davecutting/Ward-Melville-2018-Mission-Possible/Circuit Board/MIT Invitational Circuit Board/Board Bottom MIT.JPG

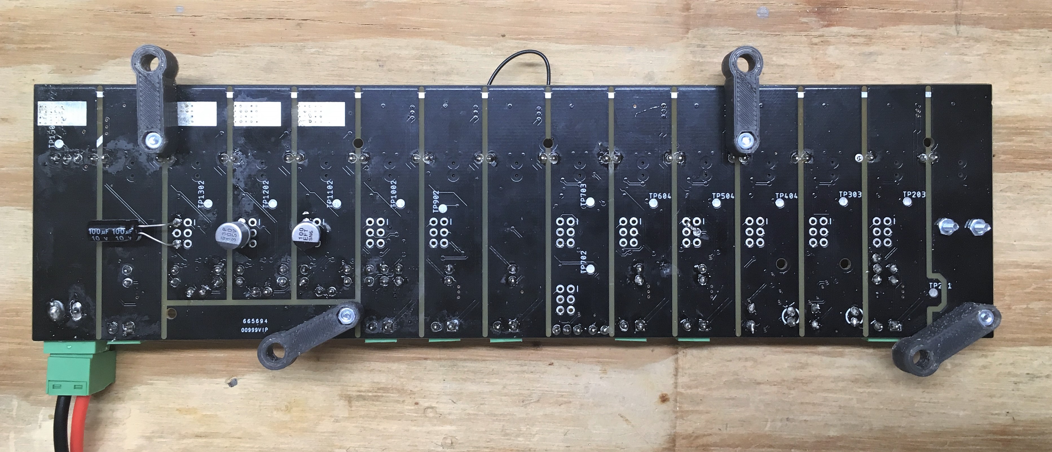
Circuit Board/MIT Invitational Circuit Board/Board Bottom MIT.JPG
