davecutting/Ward-Melville-2018-Mission-Possible/README.md

# WMHS Mission Possible 2018 # 

This repository contains code and circuit board design files for Ward Melville High School's A team Mission Prossible device in the 2017-2018 season. All work represented here is the original work of David Cutting.
