davecutting/Ward-Melville-2018-Mission-Possible/Code/Eastern LI Regionals Code/coinTiny/coinTiny-v1.1.pdf

coinTiny.ino -- Printed on 1/26/2018, 10:43:47 PM -- Page 1 1 /**
2 Coin Action - Mission Possible MK2
3 Ward Melville HS Science Olympiad - Team A - 2017-2018
4 coinTiny.ino
5 Purpose: Triggers the next action based on the input from an NPN inductive probe. 6
7 @author David Cutting
8 @version 1.1 1/23/2018
9 */
10
11 // Definitions for microcontroller pin numbers 12 const int PROBE_PIN = 2;
13 const int OUT_PIN = 4;
14
15 // Variables for states of the pins 16 bool probeState = HIGH;
17 bool outState = LOW;
18
19 // Variables and constants for the debounce code 20 unsigned int counter = 0;
21 const int DEBOUNCE_COUNT = 50;
22 long time = 0;
23
24 void setup() {
25 // Set the microcontroller pins as either inputs or outputs 26 pinMode(PROBE_PIN, INPUT);
27 pinMode(OUT_PIN, OUTPUT);
28
29 // Set the output pin to low
30 digitalWrite(OUT_PIN, LOW); // Write the output pin to LOW 31 }
32
33 void loop() {
34 if(millis() != time && outState == LOW) { // If more than one millisecond has elapsed since the last loop...
35 probeState = digitalRead(PROBE_PIN); // Read the current state of the probe and store it 36
37 if(probeState == LOW) { // If the state of the probe is low (quarter is present)...
38 counter++; // Increment the counter
39 }
40 else { // Otherwise...
41 counter = 0; // Reset the counter
42 }
43 if(counter >= DEBOUNCE_COUNT) { // If the counter is greater than the debounce threshold...
44 counter = 0; // Reset the counter
45 outState = HIGH; // Set the trigger state to high
46 digitalWrite(OUT_PIN, outState); // Set the output pin to the trigger state 47 }
48 time = millis(); // Record the current time in milliseconds
49 }
50 }
51

C:\Users\davec\Documents\GitHub\Ward-Melville-2018-Mission-Possible\Code\Eastern LI Regionals Code\coinTiny\coinTiny.ino -- File date: 1/23/2018 -- File time: 1:49:51 AM
