davecutting/Ward-Melville-2018-Mission-Possible/Code/Eastern LI Regionals Code/exoTiny/exoTiny-v1_1.pdf

exoTiny.ino -- Printed on 1/26/2018, 11:27:37 PM -- Page 1 1 /**
2 Exothermic Action - Mission Possible MK2
3 Ward Melville HS Science Olympiad - Team A - 2017-2018
4 exoTiny.ino
5 Purpose: Triggers the next action when the resistance of a photocell changes more than a threshold value.
6
7 @author David Cutting
8 @version 1.1 1/26/2018
9 */
10
11 // Definitions for microcontroller pin numbers 12 const int photocellPin = 1;
13 const int outPin = 4;
14
15 // Variables for states of the pins 16 int photocellValue;
17 int photocellBase;
18 bool statusOut = LOW;
19
20 void setup() {
21 // Set the microcontroller pins as either inputs or outputs 22 pinMode(photocellPin, INPUT);
23 pinMode(outPin, OUTPUT);
24
25 // Set the output pin to low
26 digitalWrite(outPin, LOW); // Write the output pin to LOW 27
28 // Read the initial value of the photocell (ambient light)
29 photocellBase = analogRead(photocellPin);
30 }
31
32 void loop() {
33 photocellValue = analogRead(photocellPin);
34
35 if(photocellValue - photocellBase >= 200 && statusOut == LOW) {
36 // If the difference (NOT ABSOLUTE VALUE) between the current reading and the ambient reading is greater than the threshold...
37 delay(500); // Delay 500 milliseconds (0.5 s) to allow observation
38 statusOut = HIGH;
39 digitalWrite(outPin, HIGH); // Trigger the next action
40 }
41 }
42

C:\Users\davec\Documents\GitHub\Ward-Melville-2018-Mission-Possible\Code\Eastern LI Regionals Code\exoTiny\exoTiny.ino -- File date: 1/26/2018 -- File time: 11:24:33 PM
