davecutting/Ward-Melville-2018-Mission-Possible/Circuit Board/Eastern LI Regionals Circuit Board/Schematic Top.pdf

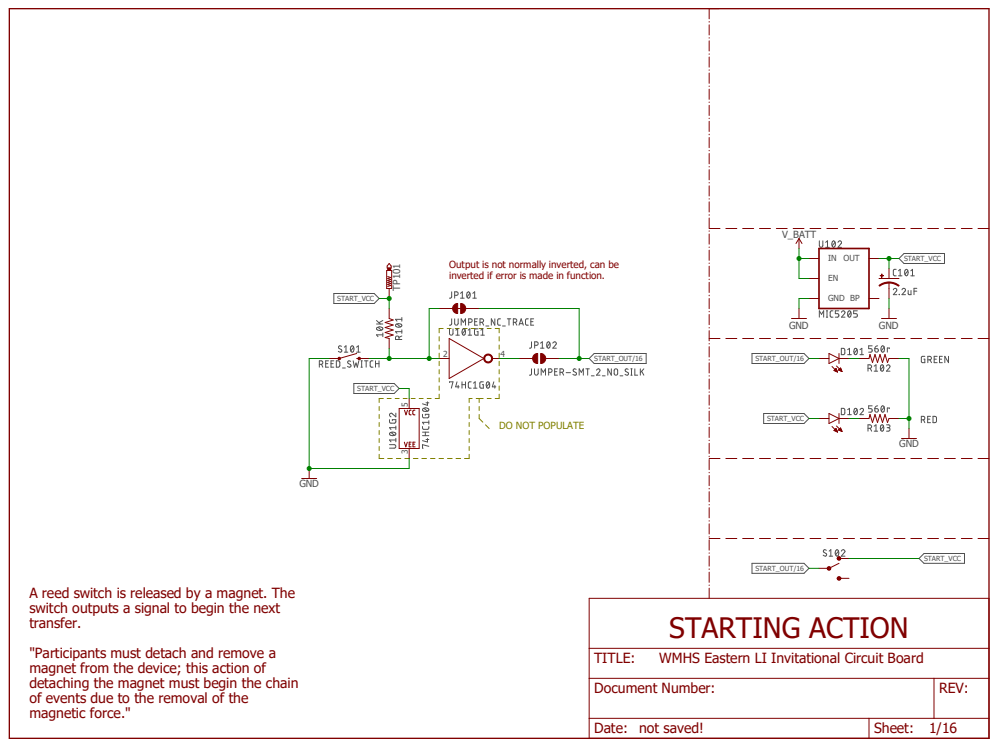
[picture p19: page 1]
GND; V_BATT; OUT; START_VCC; START_OUT/16; STARTING ACTION; TITLE:

Output is not normally inverted, can be
inverted if error is made in function.

DO NOT POPULATE

A reed switch is released by a magnet. The
switch outputs a signal to begin the next
transfer.
"Participants must detach and remove a
magnet from the device; this action of
detaching the magnet must begin the chain
of events due to the removal of the
magnetic force."

WMHS Eastern LI Invitational Circuit Board

Document Number: | REV:

Date: not saved! | Sheet: 1/16

# GND SK310A⁻TP

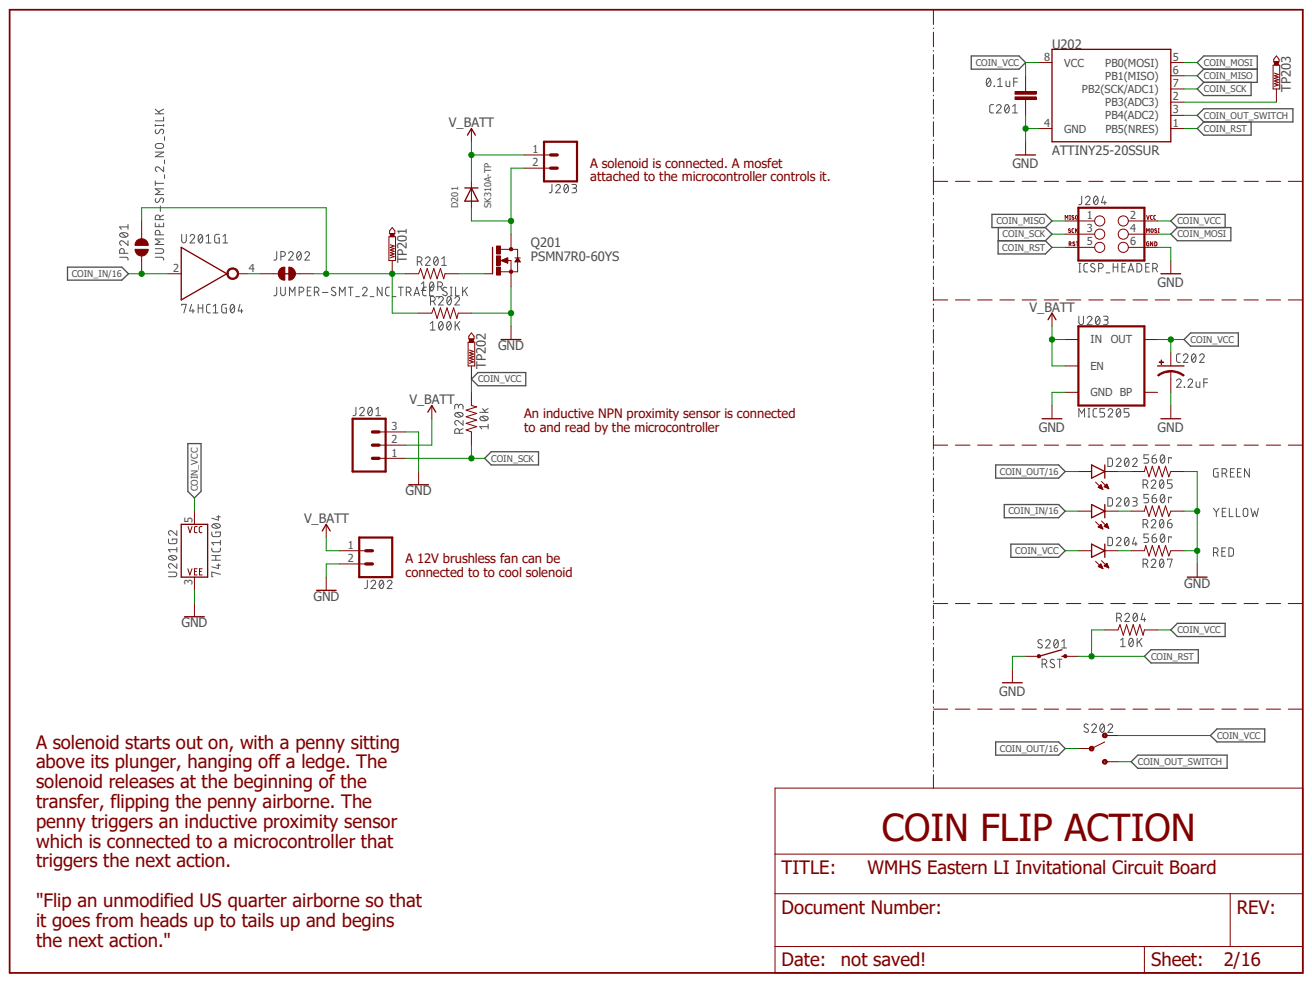
[picture p20: page 2]
V_BATT; GND; ATTINY25-20SSUR; PSMN7R0-60YS D²⁰¹; U202 VCC 8; PB1(MISO); PB5(NRES); 1 GND 4; PB0(MOSI); PB2(SCK/ADC1); 7 PB3(ADC3); PB4(ADC2); OUT; TP203 COIN_VCC; COIN_VCC; COIN_IN/16; COIN_SCK; COIN_MISO; COIN_RST; COIN_MOSI; COIN_OUT/16; COIN_OUT_SWITCH; TITLE:

A solenoid is connected. A mosfet
attached to the microcontroller controls it.

An inductive NPN proximity sensor is connected
to and read by the microcontroller

A 12V brushless fan can be
connected to to cool solenoid

A solenoid starts out on, with a penny sitting
above its plunger, hanging off a ledge. The
solenoid releases at the beginning of the
transfer, flipping the penny airborne. The
penny triggers an inductive proximity sensor
which is connected to a microcontroller that
triggers the next action.
"Flip an unmodified US quarter airborne so that
it goes from heads up to tails up and begins
the next action."

COIN_OUT/16
COIN FLIP ACTION

WMHS Eastern LI Invitational Circuit Board

Document Number: | REV:

Date: not saved! | Sheet: 2/16

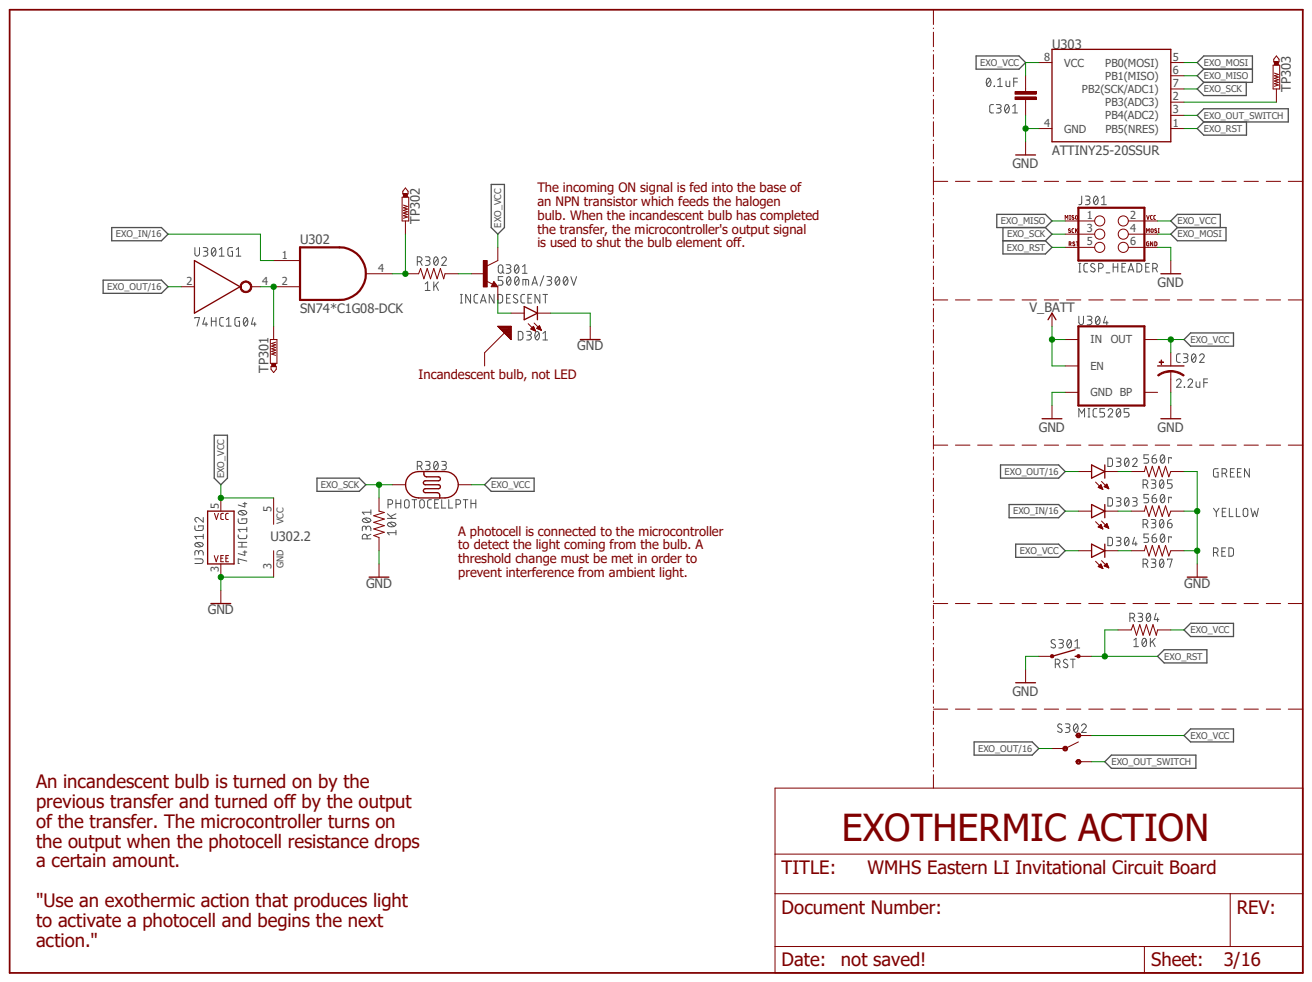
[picture p21: page 3]
GND; ATTINY25-20SSUR; V_BATT; SN74*C1G08-DCK; U303 VCC 8; PB1(MISO); PB5(NRES); 1 GND 4; PB0(MOSI); PB2(SCK/ADC1); 7 PB3(ADC3); PB4(ADC2); OUT; 5 3 U302.2 3 5 GND VCC TP303 TP301 TP302 EXO_VCC; EXO_VCC EXO_VCC; EXO_VCC; EXO_SCK; EXO_IN/16; EXO_OUT/16; EXO_MISO; EXO_RST; EXO_MOSI; EXO_OUT_SWITCH; EXOTHERMIC ACTION; TITLE:

The incoming ON signal is fed into the base of
an NPN transistor which feeds the halogen
bulb. When the incandescent bulb has completed
the transfer, the microcontroller's output signal
is used to shut the bulb element off.

Incandescent bulb, not LED

A photocell is connected to the microcontroller
to detect the light coming from the bulb. A
threshold change must be met in order to
prevent interference from ambient light.

An incandescent bulb is turned on by the
previous transfer and turned off by the output
of the transfer. The microcontroller turns on
the output when the photocell resistance drops
a certain amount.
"Use an exothermic action that produces light
to activate a photocell and begins the next
action."

WMHS Eastern LI Invitational Circuit Board

Document Number: | REV:

Date: not saved! | Sheet: 3/16

# LIGHT_VCC LIGHT_VCC

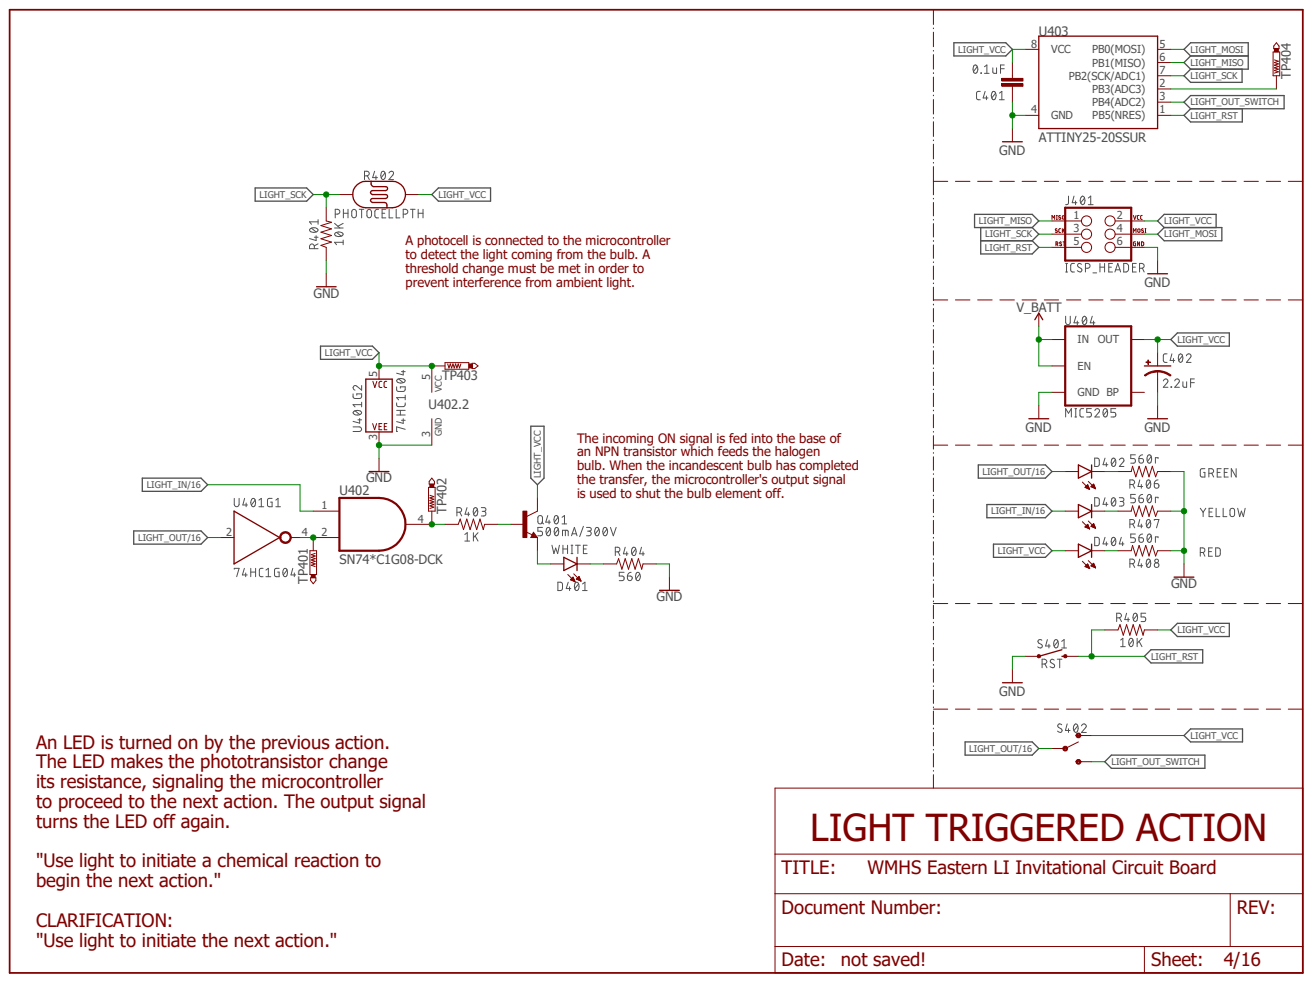
[picture p22: page 4]
GND; ATTINY25-20SSUR; V_BATT; SN74*C1G08-DCK; U403 VCC 8; PB1(MISO); PB5(NRES); 1 GND 4; PB0(MOSI); PB2(SCK/ADC1); 7 PB3(ADC3); PB4(ADC2); OUT; U402.2 3 5 GND VCC5 3; LIGHT_SCK; LIGHT_VCC; LIGHT_IN/16; LIGHT_OUT/16; LIGHT_MISO; LIGHT_RST; LIGHT_MOSI; LIGHT_OUT_SWITCH; TITLE:

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

An LED is turned on by the previous action.
The LED makes the phototransistor change
its resistance, signaling the microcontroller
to proceed to the next action. The output signal
turns the LED off again.
"Use light to initiate a chemical reaction to
begin the next action."
CLARIFICATION:
"Use light to initiate the next action."

LIGHT TRIGGERED ACTION

WMHS Eastern LI Invitational Circuit Board

Document Number: | REV:

Date: not saved! | Sheet: 4/16

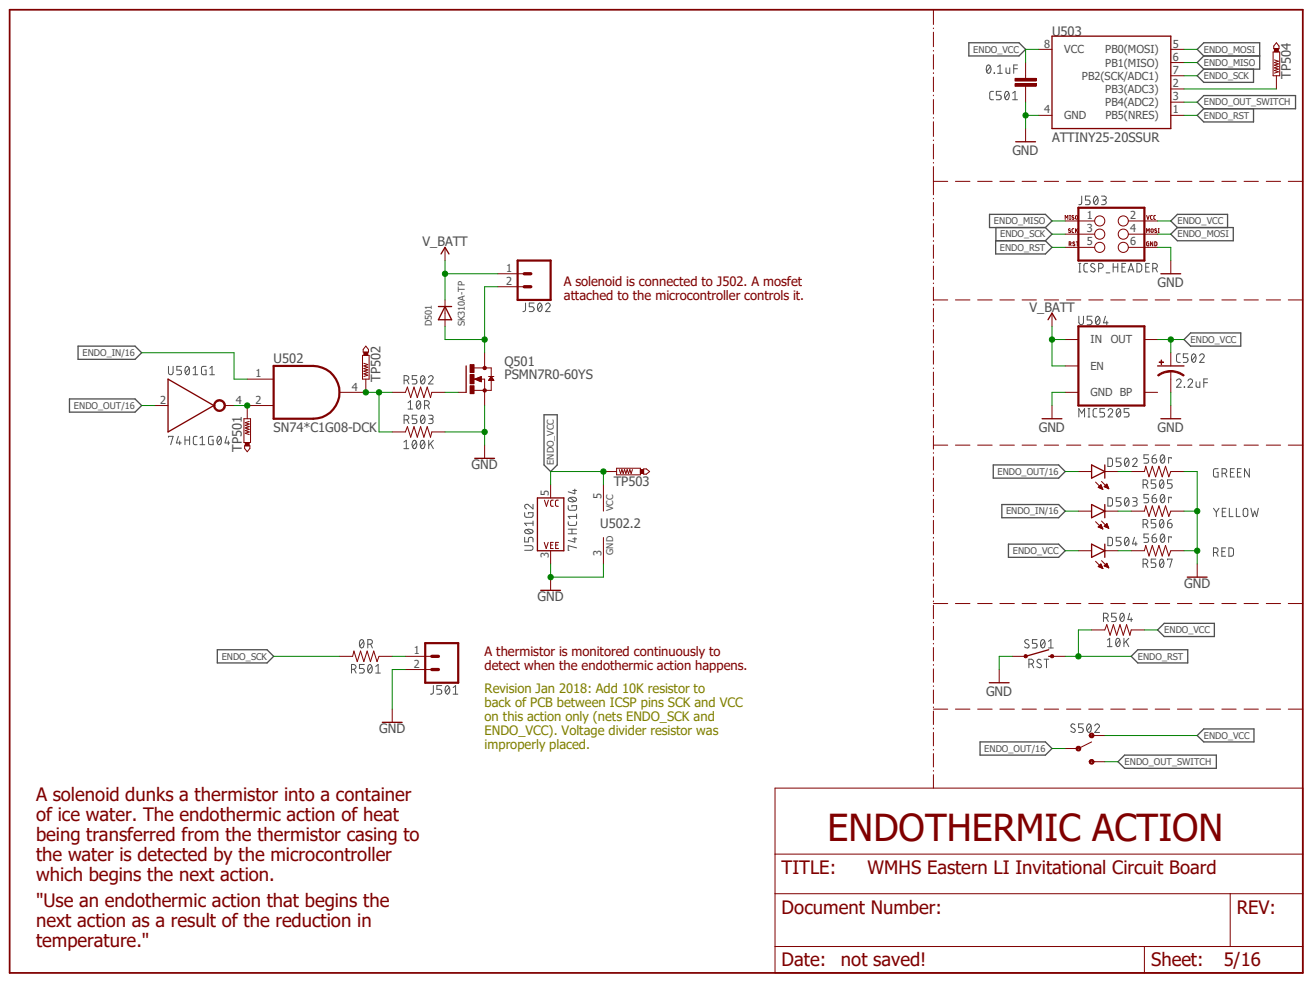
[picture p23: page 5]
GND; PSMN7R0-60YS; GND SK310A⁻TP; V_BATT; ATTINY25-20SSUR; SN74*C1G08-DCK; Q501 D⁵⁰¹; U503 VCC 8; PB1(MISO); PB5(NRES); 1 GND 4; PB0(MOSI); PB2(SCK/ADC1); 7 PB3(ADC3); PB4(ADC2); OUT; 4 U502.2 3 5 GND VCC; ENDO_SCK; ENDO_IN/16; ENDO_OUT/16; ENDO_VCC; ENDO_MISO; ENDO_RST; ENDO_MOSI; ENDO_OUT_SWITCH; ENDOTHERMIC ACTION; TITLE:

A solenoid is connected to J502. A mosfet
attached to the microcontroller controls it.

A thermistor is monitored continuously to
detect when the endothermic action happens.
Revision Jan 2018: Add 10K resistor to
back of PCB between ICSP pins SCK and VCC
on this action only (nets ENDO_SCK and
ENDO_VCC). Voltage divider resistor was
improperly placed.

A solenoid dunks a thermistor into a container
of ice water. The endothermic action of heat
being transferred from the thermistor casing to
the water is detected by the microcontroller
which begins the next action.
"Use an endothermic action that begins the
next action as a result of the reduction in
temperature."

WMHS Eastern LI Invitational Circuit Board

Document Number: | REV:

Date: not saved! | Sheet: 5/16

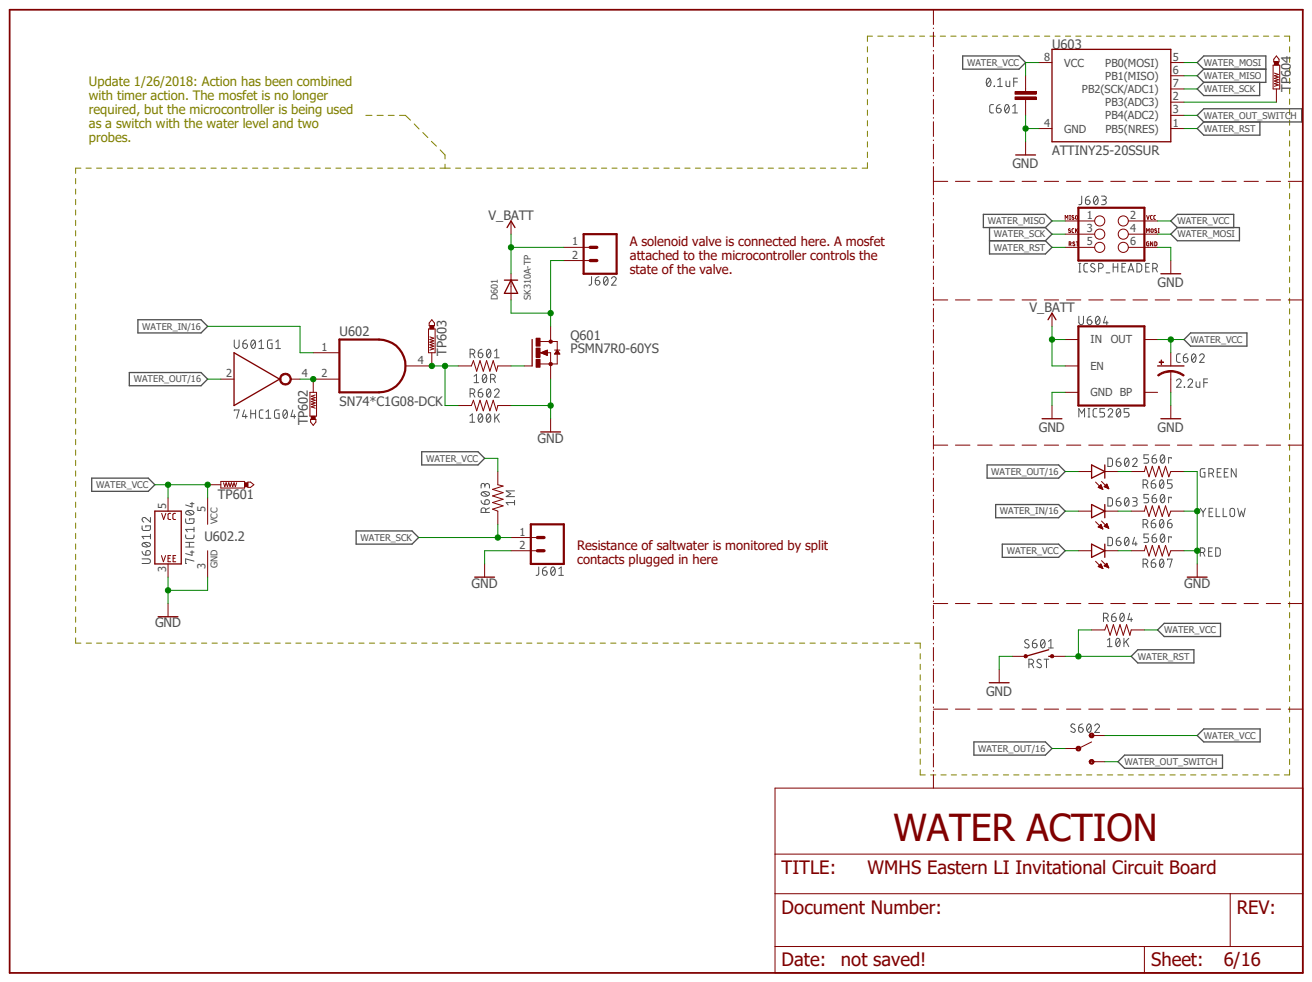
[picture p24: page 6]
PSMN7R0-60YS; GND SK310A⁻TP; V_BATT; GND; ATTINY25-20SSUR; SN74*C1G08-DCK; Q601 D⁶⁰¹; U603 VCC 8; PB1(MISO); PB5(NRES); 1 GND 4; PB0(MOSI); PB2(SCK/ADC1); 7 PB3(ADC3); PB4(ADC2); OUT; 5 3 U602.2 3 5 GND VCC TP604; WATER_VCC; WATER_SCK; WATER_IN/16; WATER_OUT/16; WATER_MISO; WATER_RST; WATER_MOSI; WATER_OUT_SWITCH; WATER ACTION; TITLE:

Update 1/26/2018: Action has been combined
with timer action. The mosfet is no longer
required, but the microcontroller is being used
as a switch with the water level and two
probes.

A solenoid valve is connected here. A mosfet
attached to the microcontroller controls the
state of the valve.

Resistance of saltwater is monitored by split
contacts plugged in here

WMHS Eastern LI Invitational Circuit Board

Document Number: | REV:

Date: not saved! | Sheet: 6/16

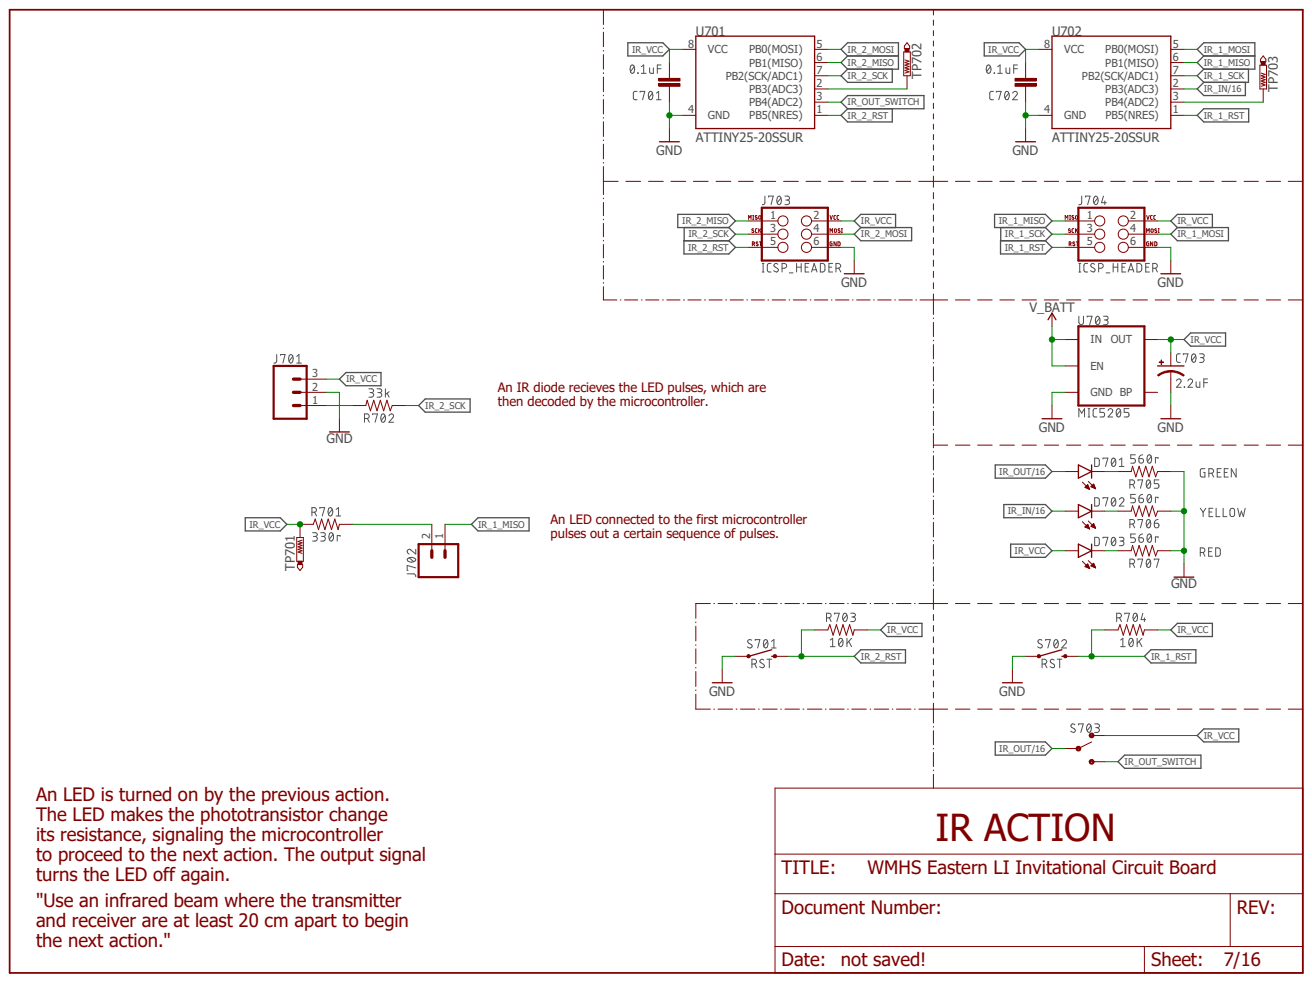
[picture p25: page 7]
GND; ATTINY25-20SSUR; V_BATT; U702 VCC 8; PB1(MISO); PB5(NRES); 1 GND 4; PB0(MOSI); PB2(SCK/ADC1); 7 PB3(ADC3); PB4(ADC2); U701 VCC 8; OUT; IR_1_MISO; IR_2_SCK; IR_VCC; IR_1_SCK; IR_1_RST; IR_1_MOSI; IR_2_MISO; IR_2_RST; IR_2_MOSI; IR_OUT/16; IR_OUT_SWITCH; IR ACTION; TITLE:

An IR diode recieves the LED pulses, which are
then decoded by the microcontroller.

An LED connected to the first microcontroller
pulses out a certain sequence of pulses.

An LED is turned on by the previous action.
The LED makes the phototransistor change
its resistance, signaling the microcontroller
to proceed to the next action. The output signal
turns the LED off again.
"Use an infrared beam where the transmitter
and receiver are at least 20 cm apart to begin
the next action."

WMHS Eastern LI Invitational Circuit Board

Document Number: | REV:

Date: not saved! | Sheet: 7/16

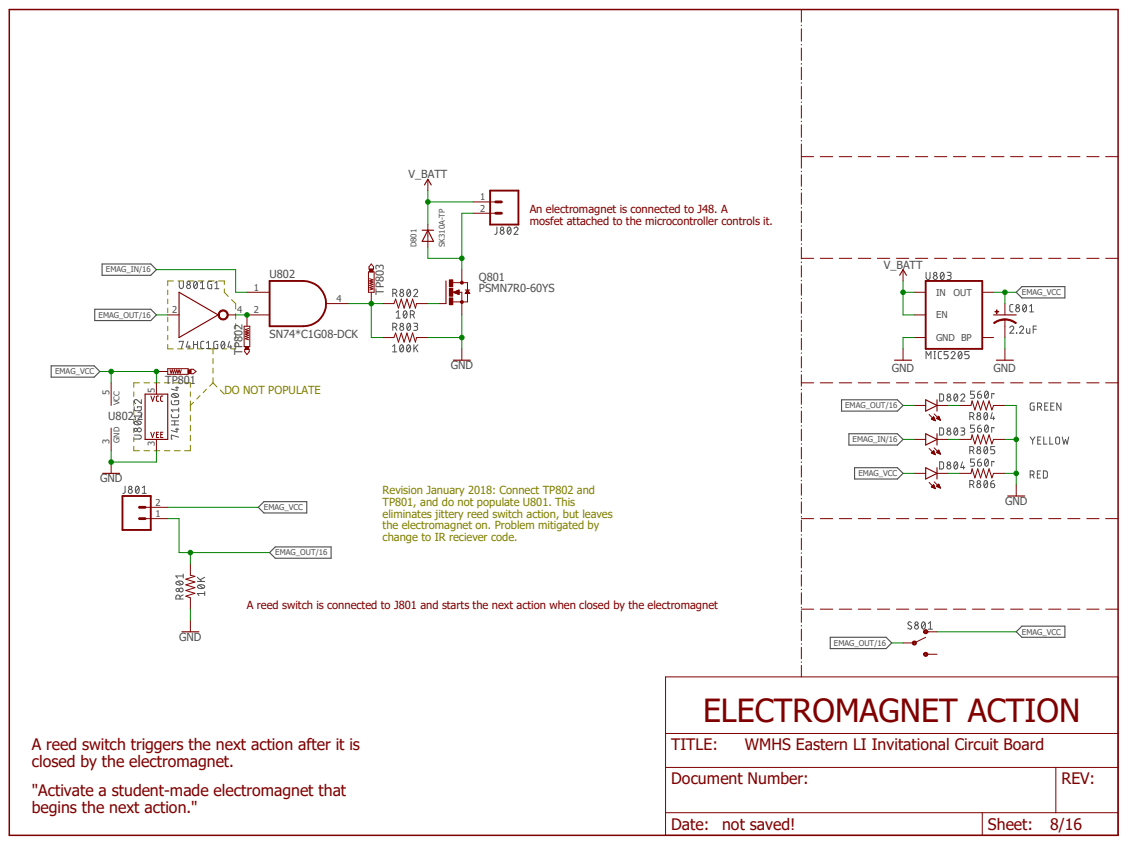
[picture p26: page 8]
GND; PSMN7R0-60YS; GND SK310A⁻TP; V_BATT; SN74*C1G08-DCK; Q801 D⁸⁰¹; OUT; 5 3 U802.2 3 5 GND VCC TP802 TP803; EMAG_VCC; EMAG_OUT/16; EMAG_IN/16; ELECTROMAGNET ACTION; TITLE:

An electromagnet is connected to J48. A
mosfet attached to the microcontroller controls it.

DO NOT POPULATE

Revision January 2018: Connect TP802 and
TP801, and do not populate U801. This
eliminates jittery reed switch action, but leaves
the electromagnet on. Problem mitigated by
change to IR reciever code.

A reed switch is connected to J801 and starts the next action when closed by the electromagnet

A reed switch triggers the next action after it is
closed by the electromagnet.
"Activate a student-made electromagnet that
begins the next action."

WMHS Eastern LI Invitational Circuit Board

Document Number: | REV:

Date: not saved! | Sheet: 8/16

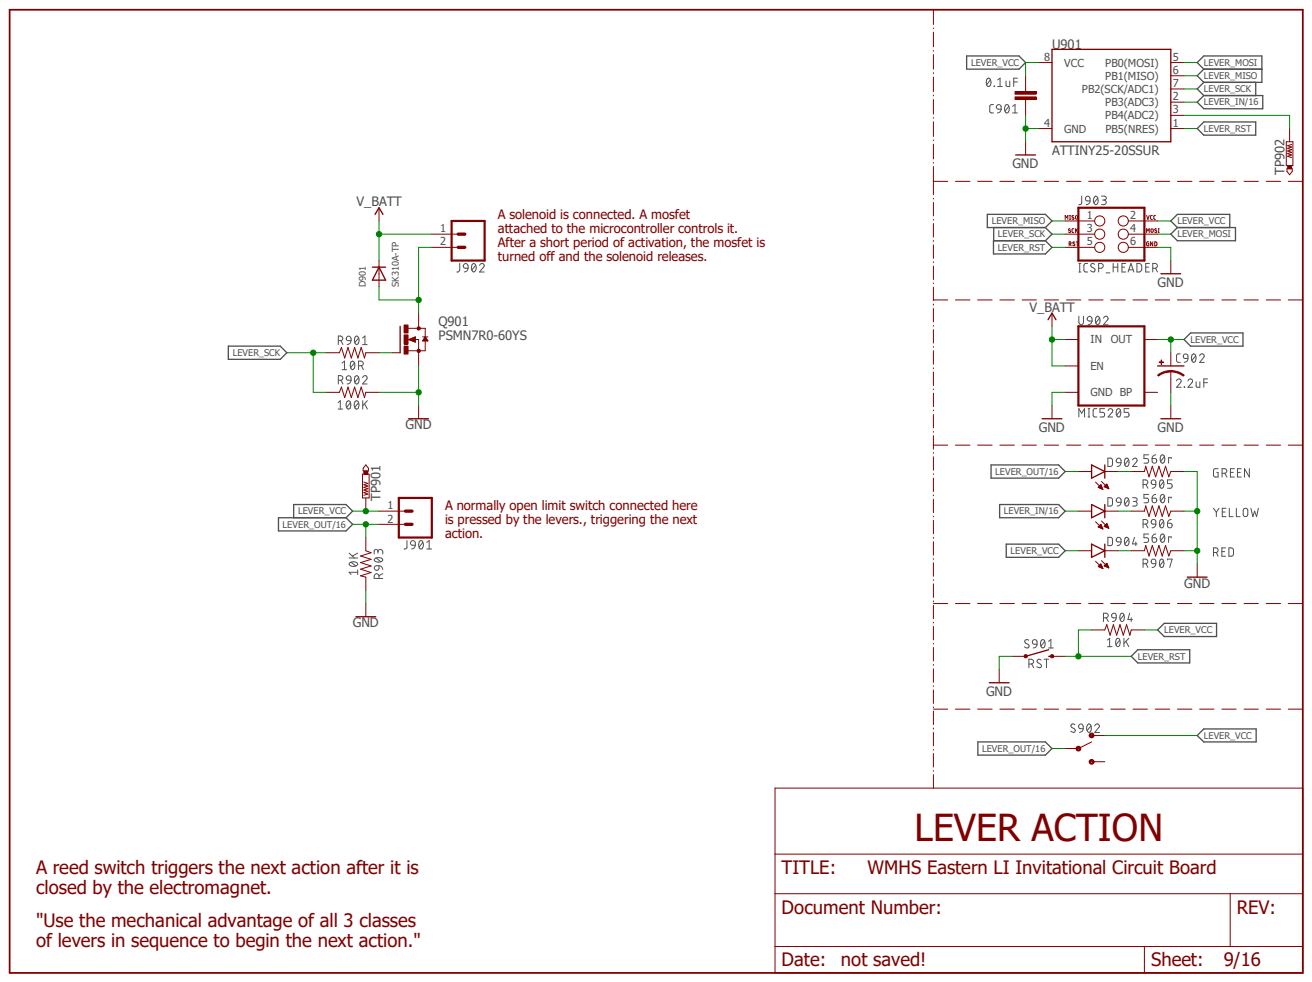
[picture p27: page 9]
PSMN7R0-60YS; GND SK310A⁻TP; V_BATT; GND; ATTINY25-20SSUR; Q901 D⁹⁰¹; U901 VCC 8; PB1(MISO); PB5(NRES); 1 GND 4; PB0(MOSI); PB2(SCK/ADC1); 7 PB3(ADC3); PB4(ADC2); OUT; LEVER_SCK; LEVER_OUT/16; LEVER_VCC; LEVER_MISO; LEVER_RST; LEVER_MOSI; LEVER_IN/16; LEVER ACTION; TITLE:

A solenoid is connected. A mosfet
attached to the microcontroller controls it.
After a short period of activation, the mosfet is
turned off and the solenoid releases.

A normally open limit switch connected here
is pressed by the levers., triggering the next
action.

A reed switch triggers the next action after it is
closed by the electromagnet.
"Use the mechanical advantage of all 3 classes
of levers in sequence to begin the next action."

WMHS Eastern LI Invitational Circuit Board

Document Number: | REV:

Date: not saved! | Sheet: 9/16

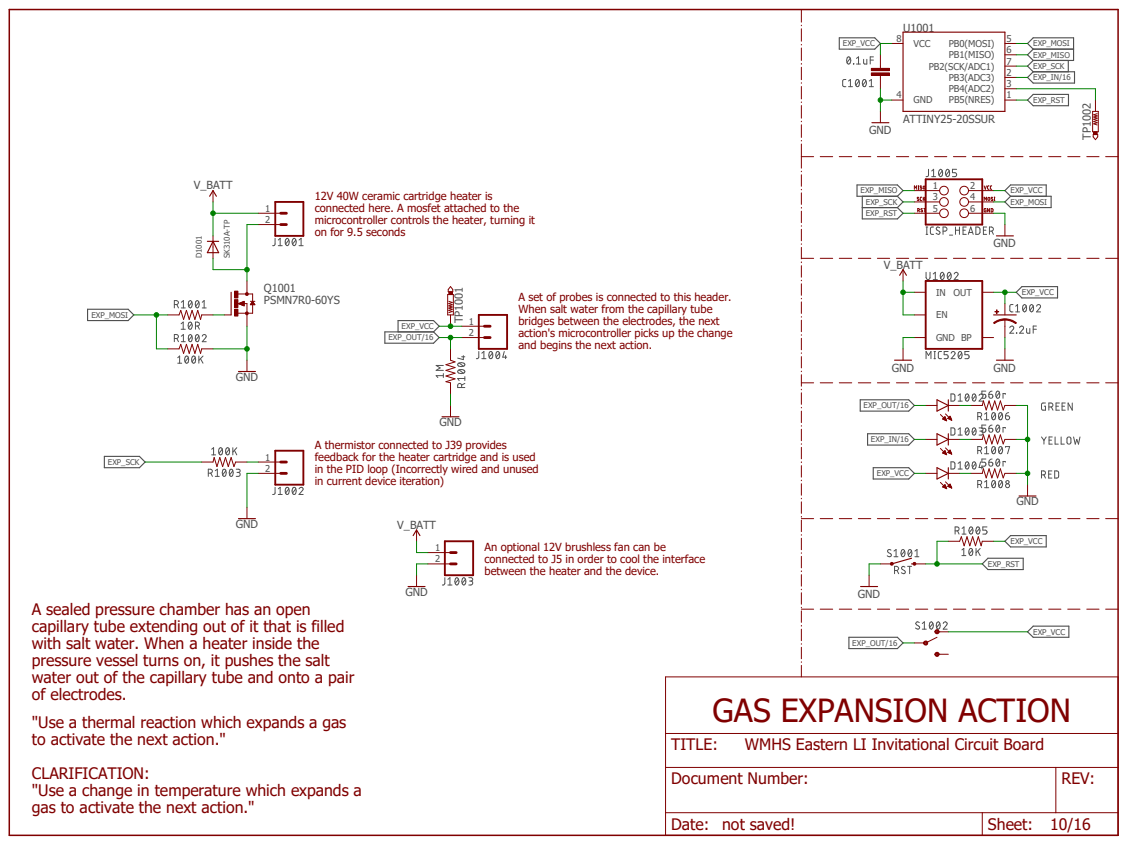
[picture p28: page 10]
PSMN7R0-60YS; GND SK310A⁻TP; V_BATT; GND; ATTINY25-20SSUR; Q1001 D¹⁰⁰¹; U1001 VCC 8; PB1(MISO); PB5(NRES); 1 GND 4; PB0(MOSI); PB2(SCK/ADC1); 7 PB3(ADC3); PB4(ADC2); OUT; TP1002 TP1001 EXP_MOSI; EXP_MOSI; EXP_SCK; EXP_OUT/16; EXP_VCC; EXP_MISO; EXP_RST; EXP_IN/16; "Use a thermal reaction which expands a gas; GAS EXPANSION ACTION; TITLE:

12V 40W ceramic cartridge heater is
connected here. A mosfet attached to the
microcontroller controls the heater, turning it
on for 9.5 seconds

A set of probes is connected to this header.
When salt water from the capillary tube
bridges between the electrodes, the next
action's microcontroller picks up the change
and begins the next action.

A thermistor connected to J39 provides
feedback for the heater cartridge and is used
in the PID loop (Incorrectly wired and unused
in current device iteration)

An optional 12V brushless fan can be
connected to J5 in order to cool the interface
between the heater and the device.

A sealed pressure chamber has an open
capillary tube extending out of it that is filled
with salt water. When a heater inside the
pressure vessel turns on, it pushes the salt
water out of the capillary tube and onto a pair
of electrodes.

to activate the next action."
CLARIFICATION:
"Use a change in temperature which expands a
gas to activate the next action."

WMHS Eastern LI Invitational Circuit Board

Document Number: | REV:

Date: not saved! | Sheet: 10/16

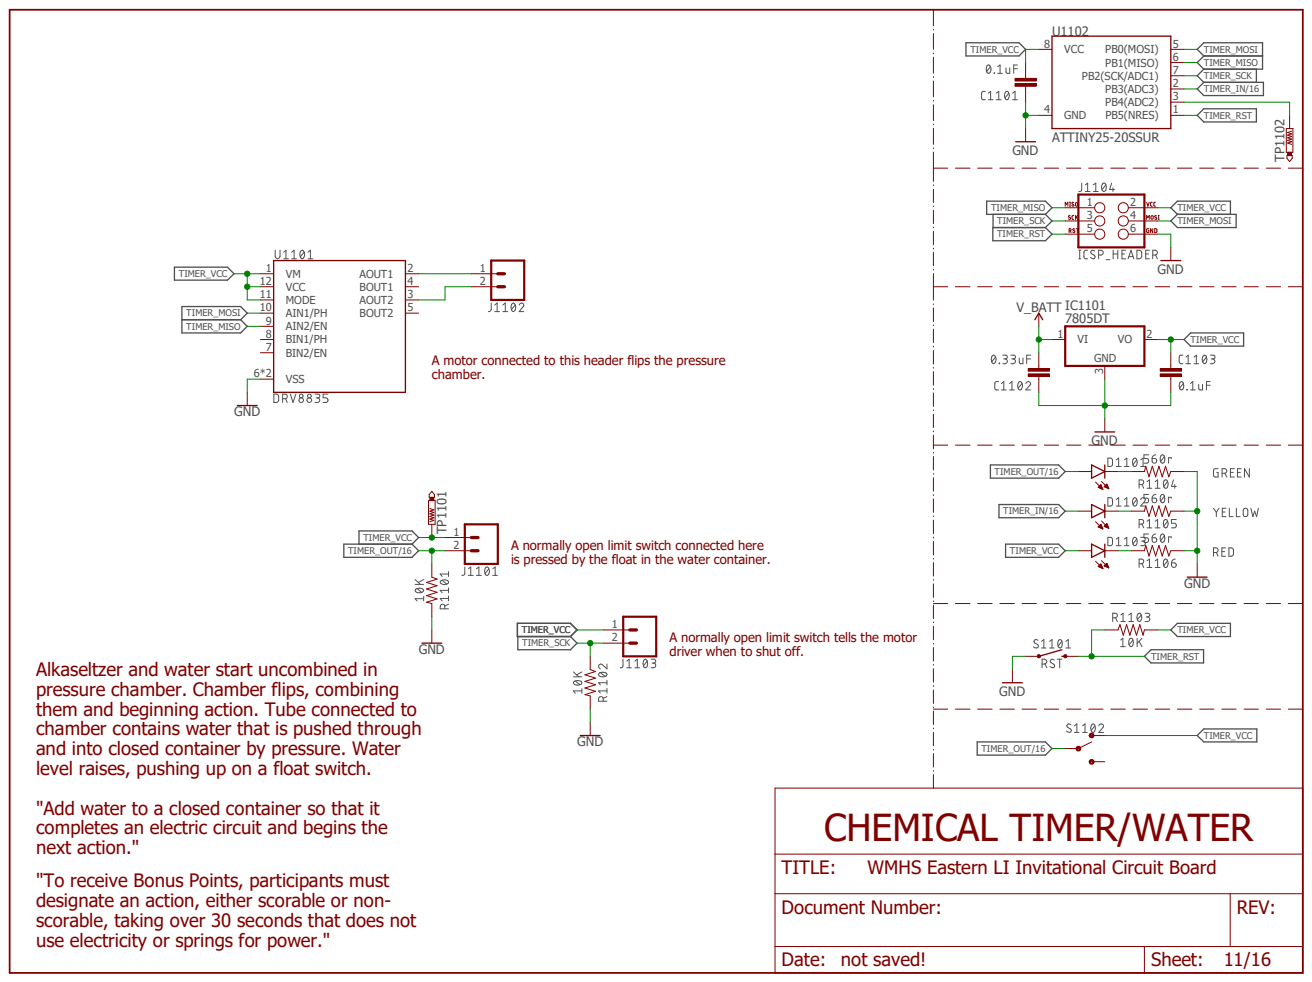
[picture p29: page 11]
GND; ATTINY25-20SSUR; V_BATT; AIN1/PH 10 AIN2/EN 9; AOUT1; AOUT2; BIN1/PH 8; BIN2/EN 7; BOUT1; 4 BOUT2; 5 MODE 11; VCC 12; VSS 6*2; U1102 VCC 8; PB1(MISO); PB5(NRES); 1 GND 4; PB0(MOSI); PB2(SCK/ADC1); 7 PB3(ADC3); PB4(ADC2); TIMER_VCC; TIMER_MOSI; TIMER_MISO; TIMER_OUT/16; TIMER_SCK; TIMER_IN/16; TIMER_RST; TITLE:

A motor connected to this header flips the pressure
chamber.

A normally open limit switch connected here
is pressed by the float in the water container.

A normally open limit switch tells the motor
driver when to shut off.

Alkaseltzer and water start uncombined in
pressure chamber. Chamber flips, combining
them and beginning action. Tube connected to
chamber contains water that is pushed through
and into closed container by pressure. Water
level raises, pushing up on a float switch.
"Add water to a closed container so that it
completes an electric circuit and begins the
next action."
"To receive Bonus Points, participants must
designate an action, either scorable or non-
scorable, taking over 30 seconds that does not
use electricity or springs for power."

CHEMICAL TIMER/WATER

WMHS Eastern LI Invitational Circuit Board

Document Number: | REV:

Date: not saved! | Sheet: 11/16

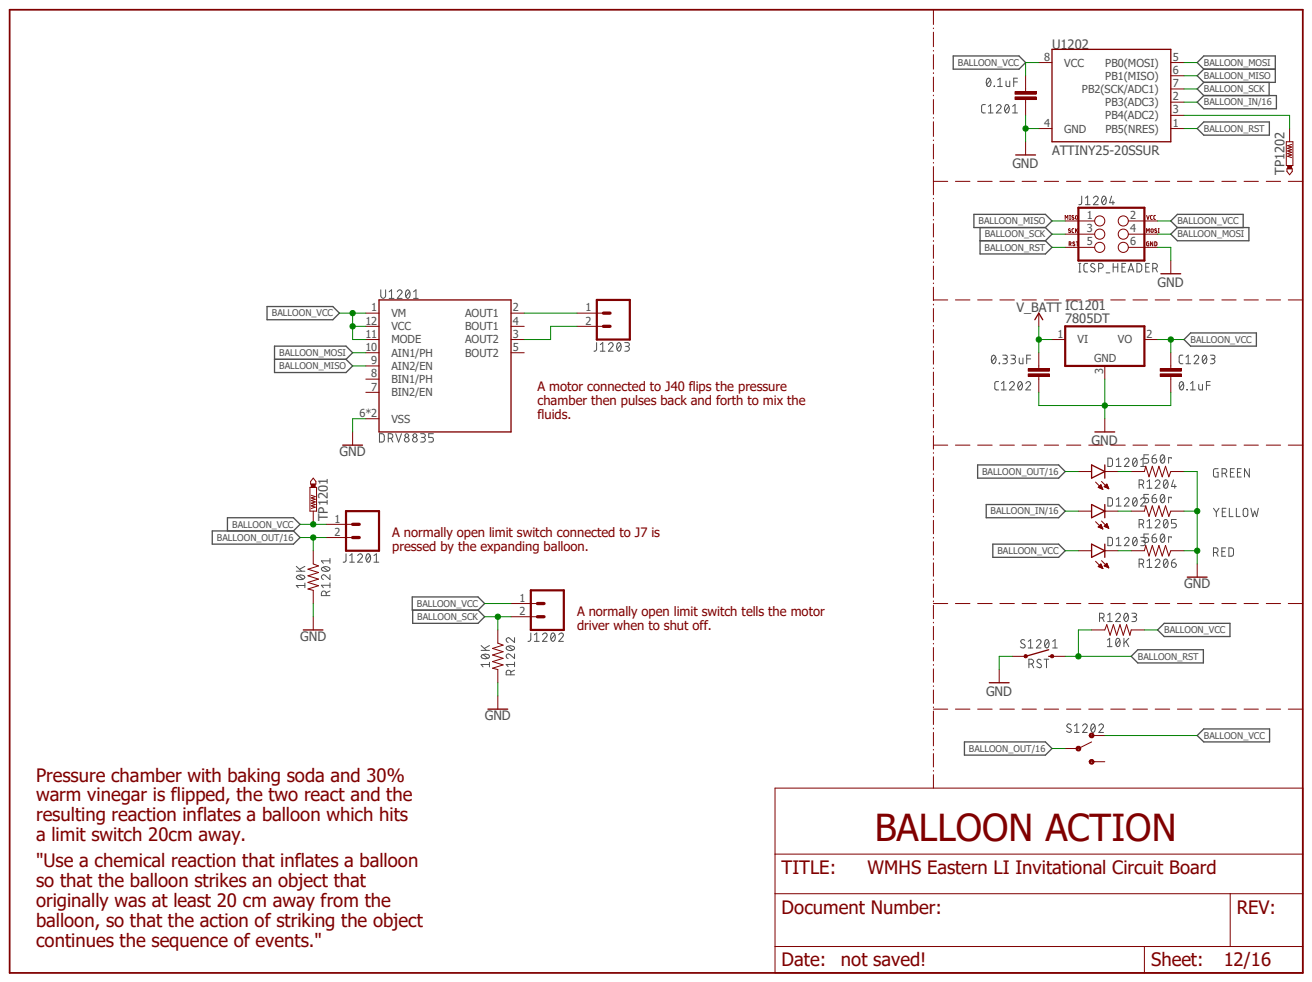
[picture p30: page 12]
GND; ATTINY25-20SSUR; V_BATT; AIN1/PH 10 AIN2/EN 9; AOUT1; AOUT2; BIN1/PH 8; BIN2/EN 7; BOUT1; 4 BOUT2; 5 MODE 11; VCC 12; VSS 6*2; U1202 VCC 8; PB1(MISO); PB5(NRES); 1 GND 4; PB0(MOSI); PB2(SCK/ADC1); 7 PB3(ADC3); PB4(ADC2); BALLOON_VCC; BALLOON_MOSI; BALLOON_MISO; BALLOON_OUT/16; BALLOON_SCK; BALLOON_RST; BALLOON_IN/16; BALLOON ACTION; TITLE:

A motor connected to J40 flips the pressure
chamber then pulses back and forth to mix the
fluids.

A normally open limit switch connected to J7 is
pressed by the expanding balloon.

A normally open limit switch tells the motor
driver when to shut off.

Pressure chamber with baking soda and 30%
warm vinegar is flipped, the two react and the
resulting reaction inflates a balloon which hits
a limit switch 20cm away.
"Use a chemical reaction that inflates a balloon
so that the balloon strikes an object that
originally was at least 20 cm away from the
balloon, so that the action of striking the object
continues the sequence of events."

WMHS Eastern LI Invitational Circuit Board

Document Number: | REV:

Date: not saved! | Sheet: 12/16

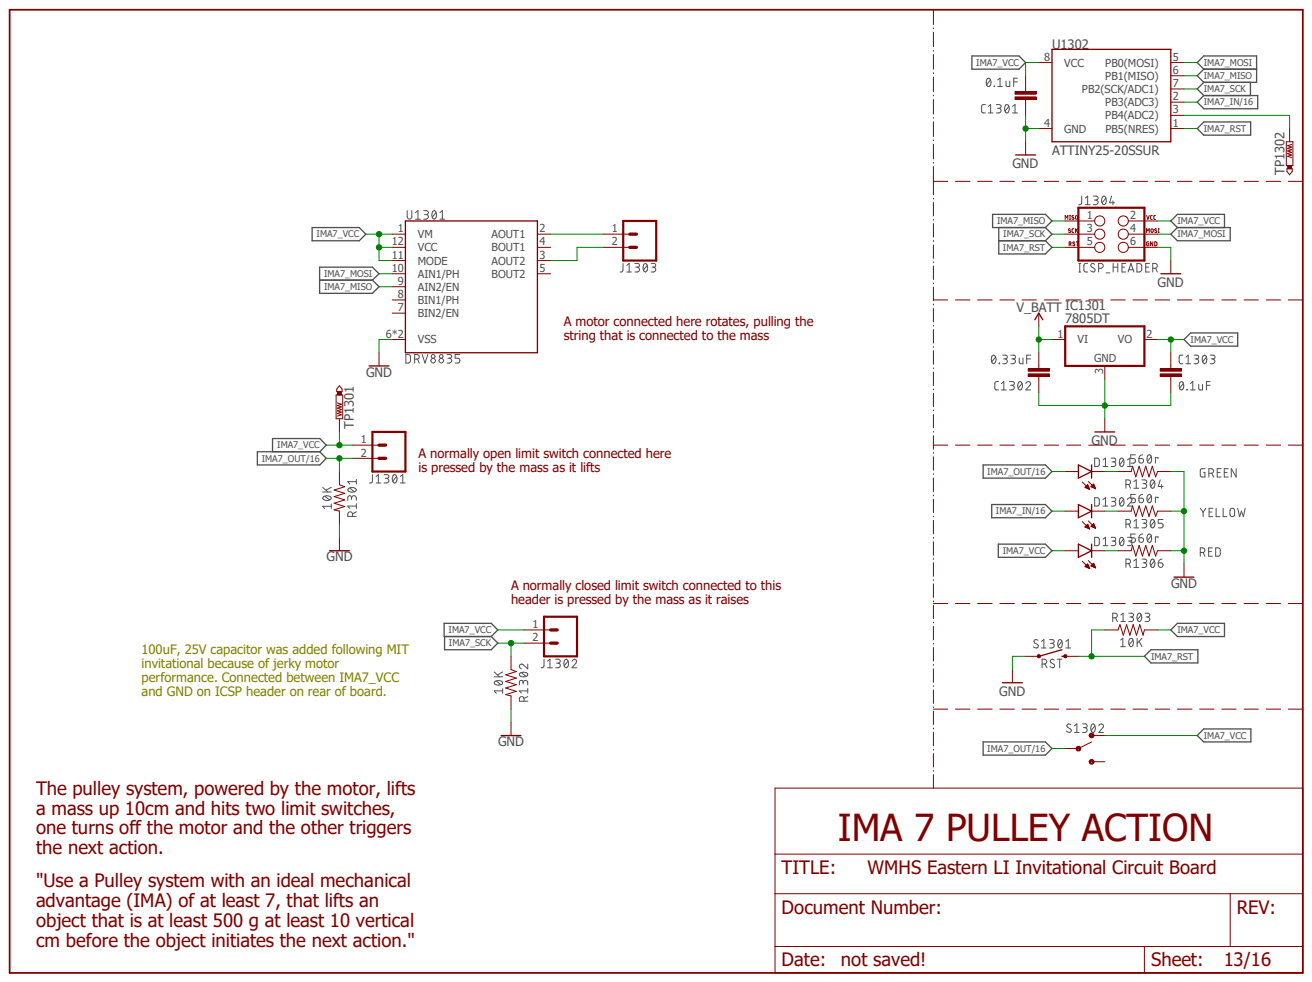
[picture p31: page 13]
GND; ATTINY25-20SSUR; V_BATT; AIN1/PH 10 AIN2/EN 9; AOUT1; AOUT2; BIN1/PH 8; BIN2/EN 7; BOUT1; 4 BOUT2; 5 MODE 11; VCC 12; VSS 6*2; U1302 VCC 8; PB1(MISO); PB5(NRES); 1 GND 4; PB0(MOSI); PB2(SCK/ADC1); 7 PB3(ADC3); PB4(ADC2); IMA7_VCC; IMA7_MOSI; IMA7_MISO; IMA7_OUT/16; IMA7_SCK; IMA7_RST; IMA7_IN/16; TITLE:

A motor connected here rotates, pulling the
string that is connected to the mass

A normally open limit switch connected here
is pressed by the mass as it lifts

A normally closed limit switch connected to this
header is pressed by the mass as it raises

100uF, 25V capacitor was added following MIT
invitational because of jerky motor
performance. Connected between IMA7_VCC
and GND on ICSP header on rear of board.

The pulley system, powered by the motor, lifts
a mass up 10cm and hits two limit switches,
one turns off the motor and the other triggers
the next action.
"Use a Pulley system with an ideal mechanical
advantage (IMA) of at least 7, that lifts an
object that is at least 500 g at least 10 vertical
cm before the object initiates the next action."

IMA 7 PULLEY ACTION

WMHS Eastern LI Invitational Circuit Board

Document Number: | REV:

Date: not saved! | Sheet: 13/16

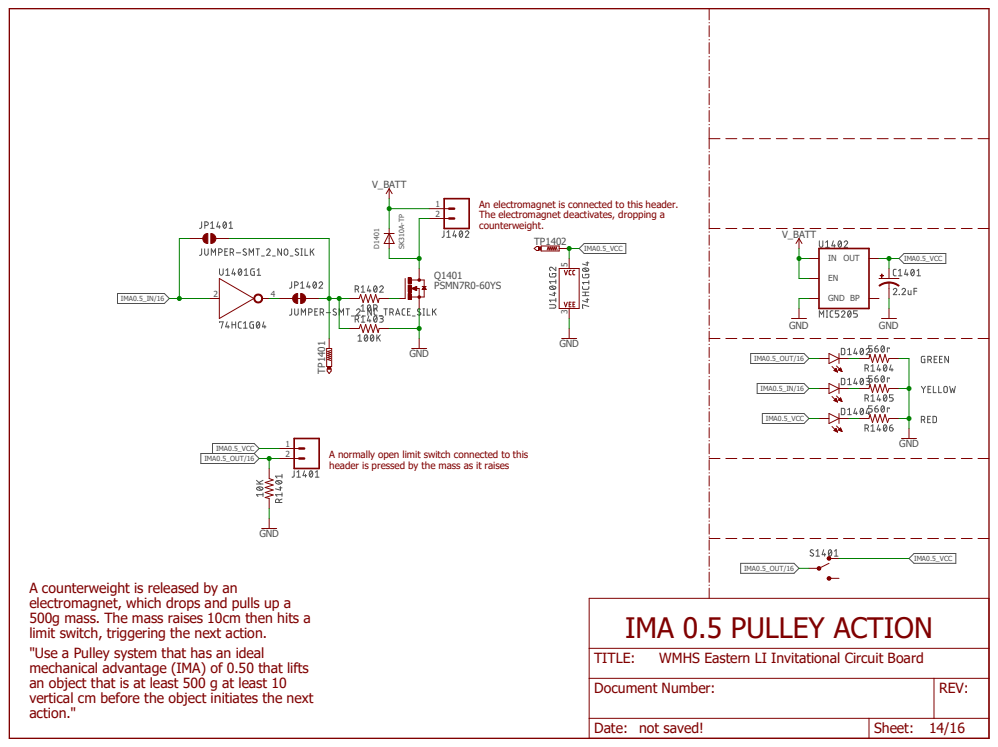
[picture p32: page 14]
PSMN7R0-60YS; GND SK310A⁻TP; V_BATT; GND; Q1401 D¹⁴⁰¹; OUT; IMA0.5_VCC; IMA0.5_OUT/16; IMA0.5_IN/16; TITLE:

An electromagnet is connected to this header.
The electromagnet deactivates, dropping a
counterweight.

A normally open limit switch connected to this
header is pressed by the mass as it raises

A counterweight is released by an
electromagnet, which drops and pulls up a
500g mass. The mass raises 10cm then hits a
limit switch, triggering the next action.
"Use a Pulley system that has an ideal
mechanical advantage (IMA) of 0.50 that lifts
an object that is at least 500 g at least 10
vertical cm before the object initiates the next
action."

IMA 0.5 PULLEY ACTION

WMHS Eastern LI Invitational Circuit Board

Document Number: | REV:

Date: not saved! | Sheet: 14/16

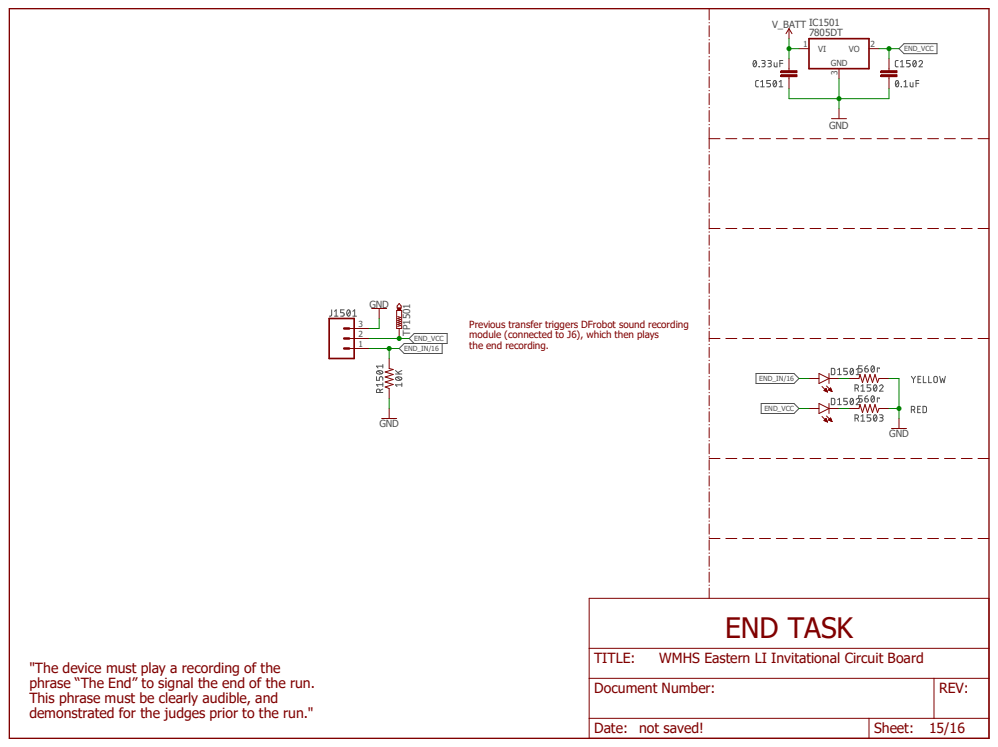
[picture p33: page 15]
GND; V_BATT; END_IN/16; END_VCC; END TASK; TITLE:

Previous transfer triggers DFrobot sound recording
module (connected to J6), which then plays
the end recording.

WMHS Eastern LI Invitational Circuit Board

"The device must play a recording of the
phrase “The End” to signal the end of the run.
This phrase must be clearly audible, and
demonstrated for the judges prior to the run."

Document Number: | REV:

Date: not saved! | Sheet: 15/16

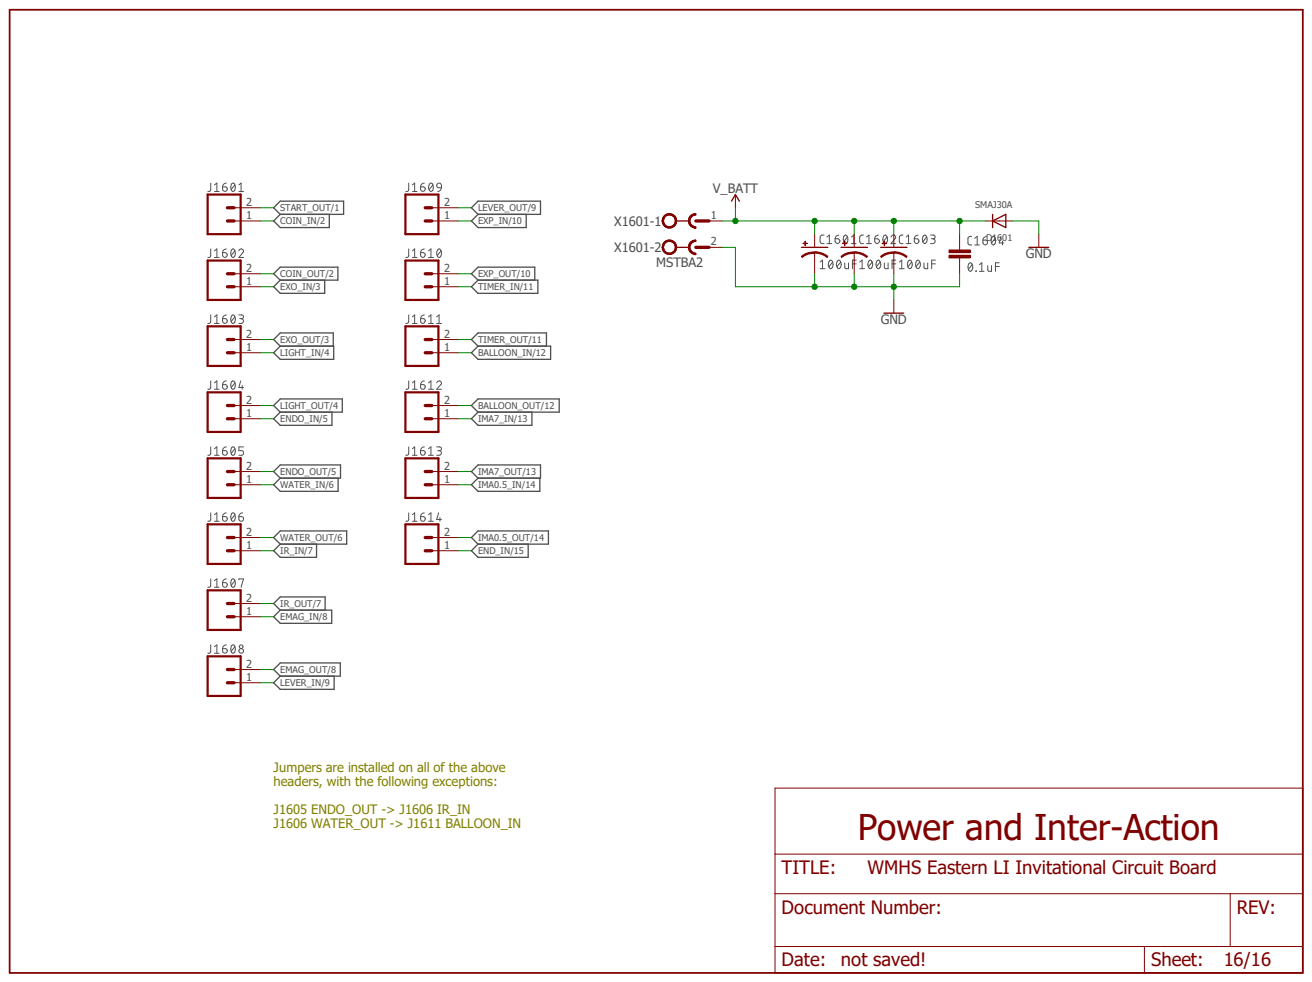
[picture p34: page 16]
MSTBA2; V_BATT; GND; SMAJ30A GND; D1601 START_OUT/1; COIN_IN/2; EXP_OUT/10; BALLOON_OUT/12; IR_OUT/7; ENDO_OUT/5; WATER_OUT/6; LIGHT_OUT/4; EXO_OUT/3; EMAG_OUT/8; COIN_OUT/2; LEVER_OUT/9; IMA7_OUT/13; IMA0.5_OUT/14 END_IN/15; EXO_IN/3; LIGHT_IN/4; ENDO_IN/5; WATER_IN/6; EMAG_IN/8; LEVER_IN/9; TIMER_OUT/11; EXP_IN/10; BALLOON_IN/12; IMA7_IN/13; IMA0.5_IN/14; TIMER_IN/11; TITLE:

Jumpers are installed on all of the above
headers, with the following exceptions:
J1605 ENDO_OUT -> J1606 IR_IN
J1606 WATER_OUT -> J1611 BALLOON_IN

Power and Inter-Action

WMHS Eastern LI Invitational Circuit Board

Document Number: | REV:

Date: not saved! | Sheet: 16/16
