davecutting/Ward-Melville-2018-Mission-Possible/Circuit Board/MIT Invitational Circuit Board/Schematic MIT.pdf

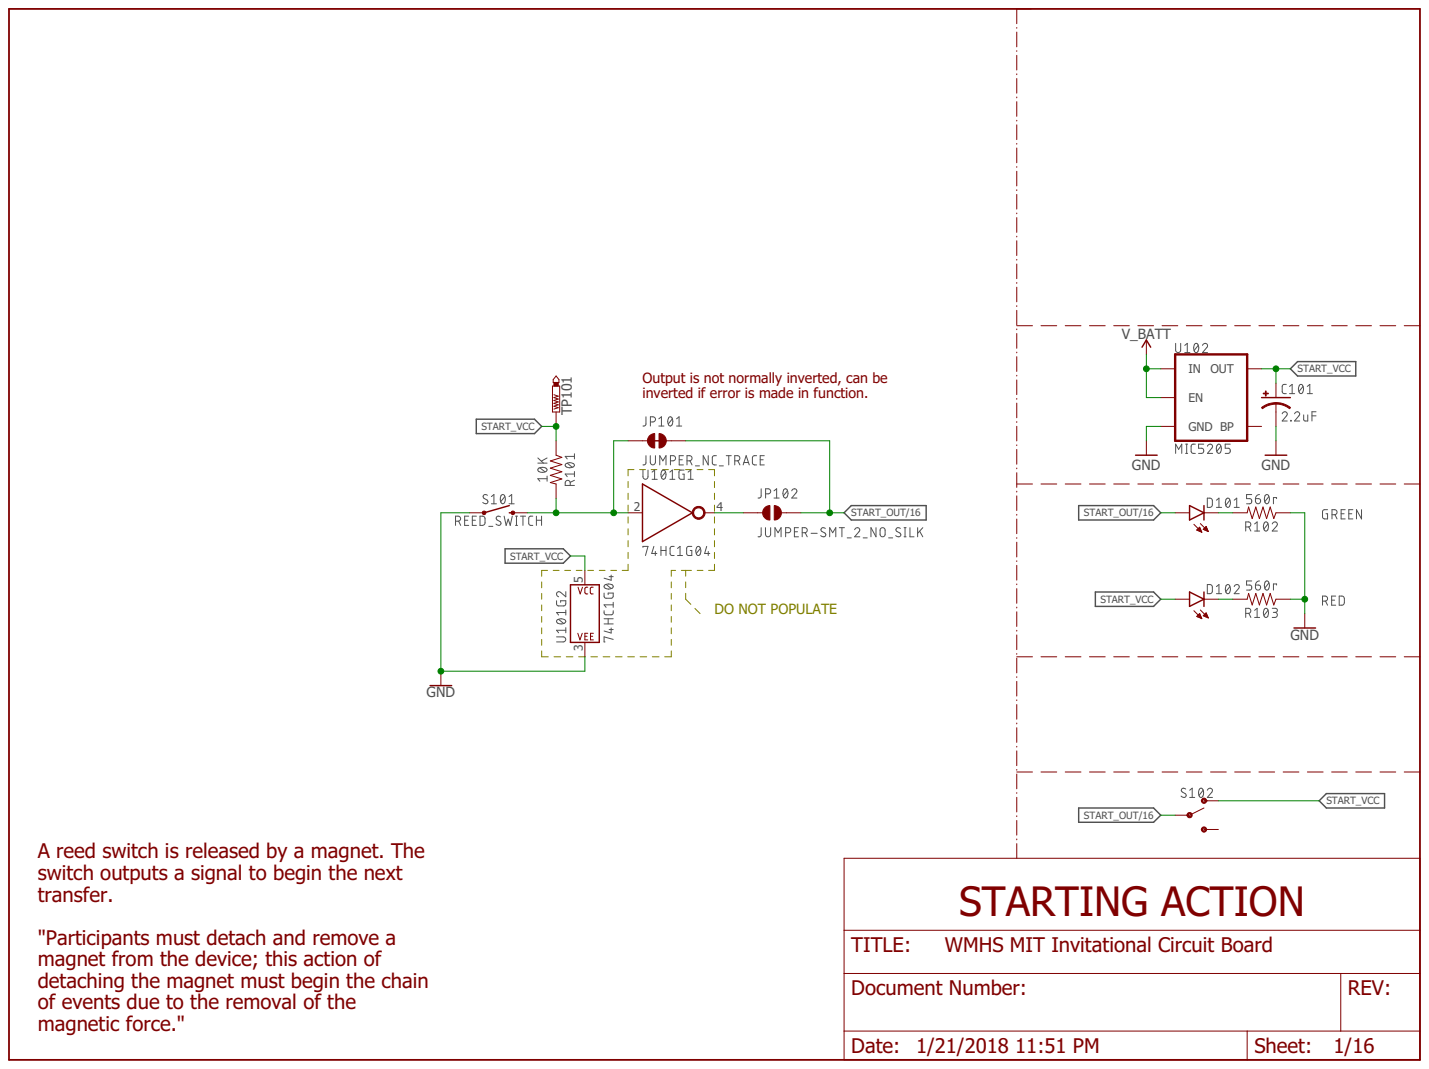
[picture p35: page 1]

Output is not normally inverted, can be
inverted if error is made in function.

A reed switch is released by a magnet. The
switch outputs a signal to begin the next
transfer.

"Participants must detach and remove a
magnet from the device; this action of
detaching the magnet must begin the chain
of events due to the removal of the
magnetic force."

WMHS MIT Invitational Circuit Board

Document Number: | REV:

Date: 1/21/2018 11:51 PM | Sheet: 1/16

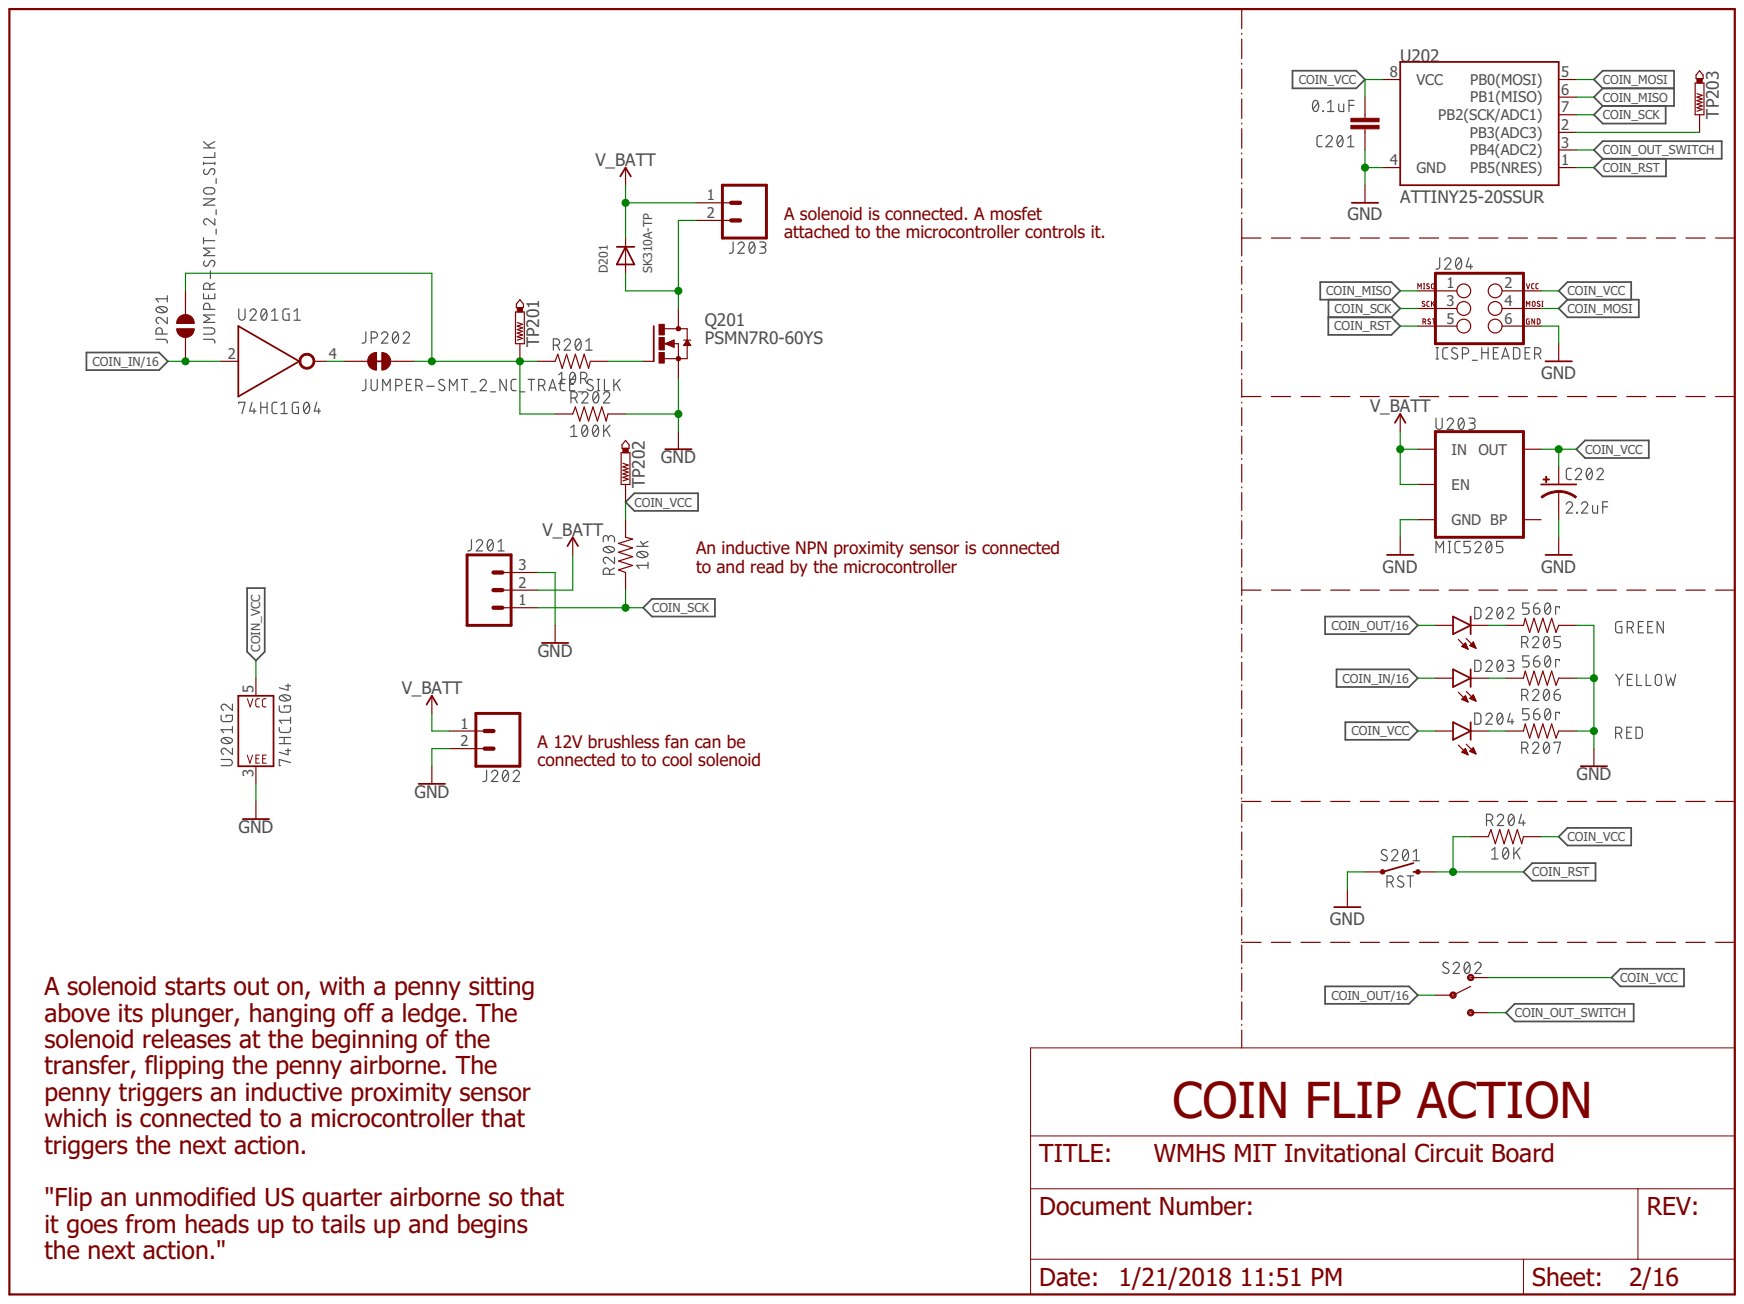
[picture p36: page 2]

A solenoid is connected. A mosfet attached to the microcontroller controls it.

An inductive NPN proximity sensor is connected
to and read by the microcontroller

A 12V brushless fan can be
connected to to cool solenoid

A solenoid starts out on, with a penny sitting
above its plunger, hanging off a ledge. The
solenoid releases at the beginning of the
transfer, flipping the penny airborne. The
penny triggers an inductive proximity sensor
which is connected to a microcontroller that

WMHS MIT Invitational Circuit Board

"Flip an unmodified US quarter airborne so that
it goes from heads up to tails up and begins
the next action."

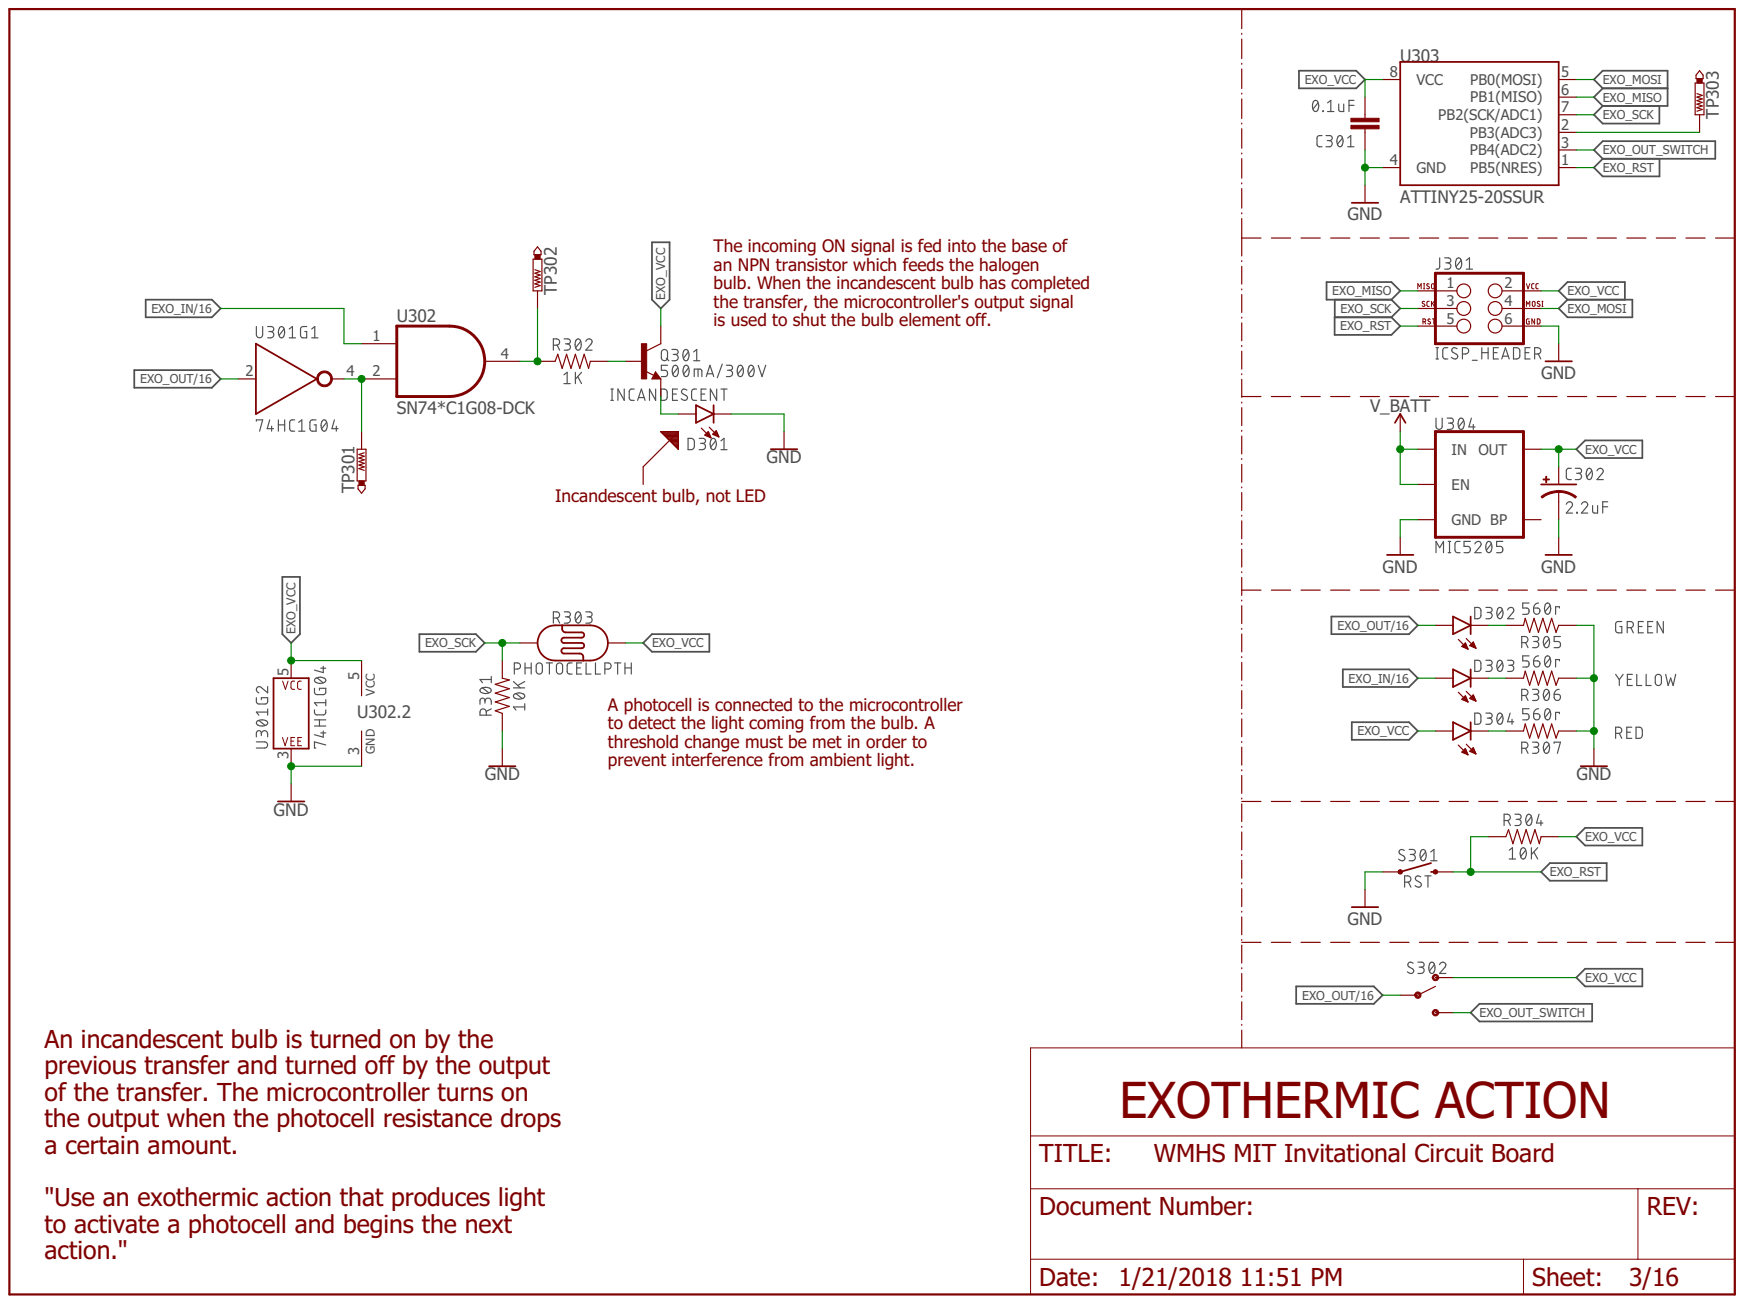
[picture p37: page 3]

The incoming ON signal is fed into the base of an NPN transistor which feeds the halogen

bulb. When the incandescent bulb has completed
the transfer, the microcontroller's output signal
is used to shut the bulb element off.

Incandescent bulb, not LED

A photocell is connected to the microcontroller
to detect the light coming from the bulb. A
threshold change must be met in order to prevent interference from ambient light.

An incandescent bulb is turned on by the
previous transfer and turned off by the output
of the transfer. The microcontroller turns on
the output when the photocell resistance drops

WMHS MIT Invitational Circuit Board

"Use an exothermic action that produces light
to activate a photocell and begins the next
action."

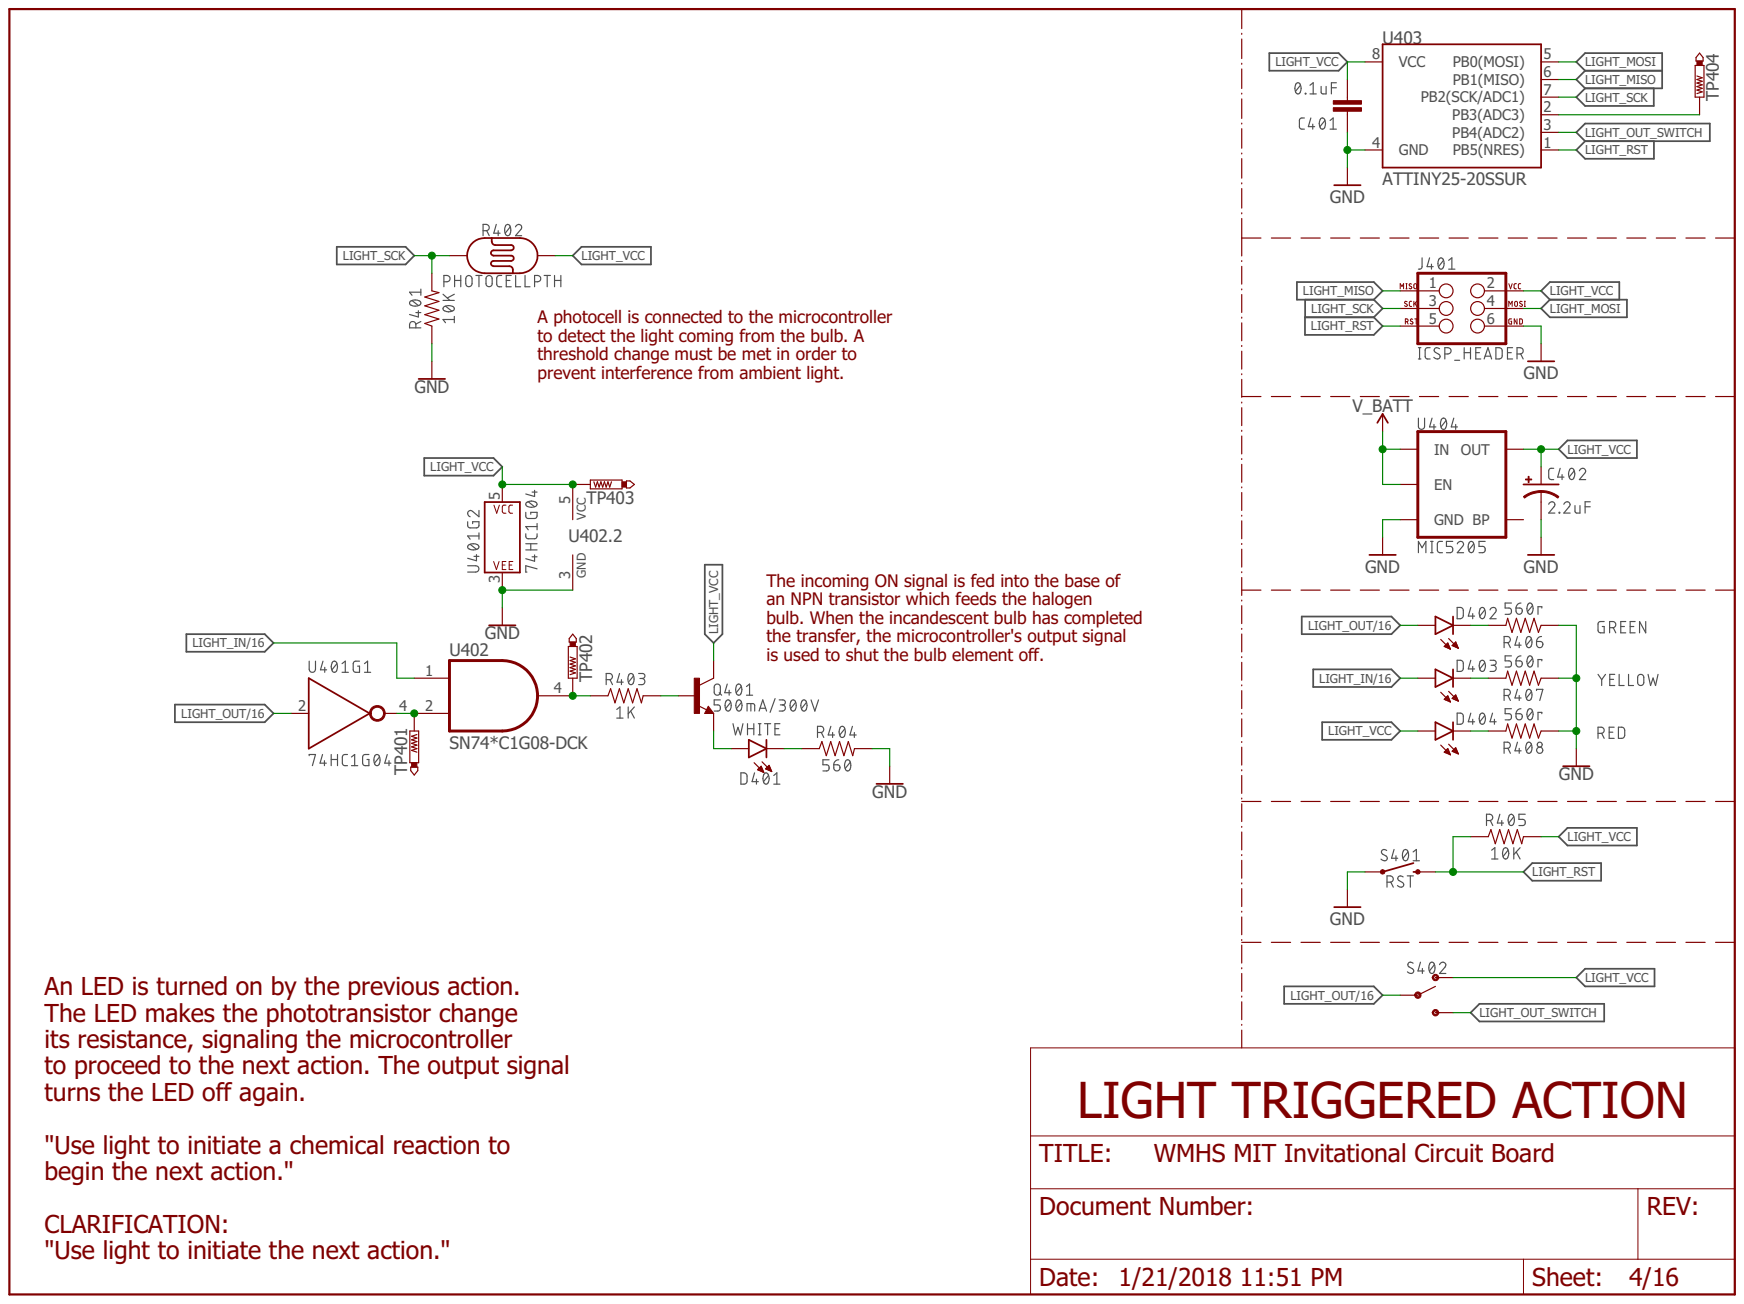
[picture p38: page 4]
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

An LED is turned on by the previous action. The LED makes the phototransistor change

its resistance, signaling the microcontroller
to proceed to the next action. The output signal
turns the LED off again.

"Use light to initiate a chemical reaction to
begin the next action." CLARIFICATION: "Use light to initiate the next action."

WMHS MIT Invitational Circuit Board

Document Number: | REV:

Date: 1/21/2018 11:51 PM | Sheet: 4/16

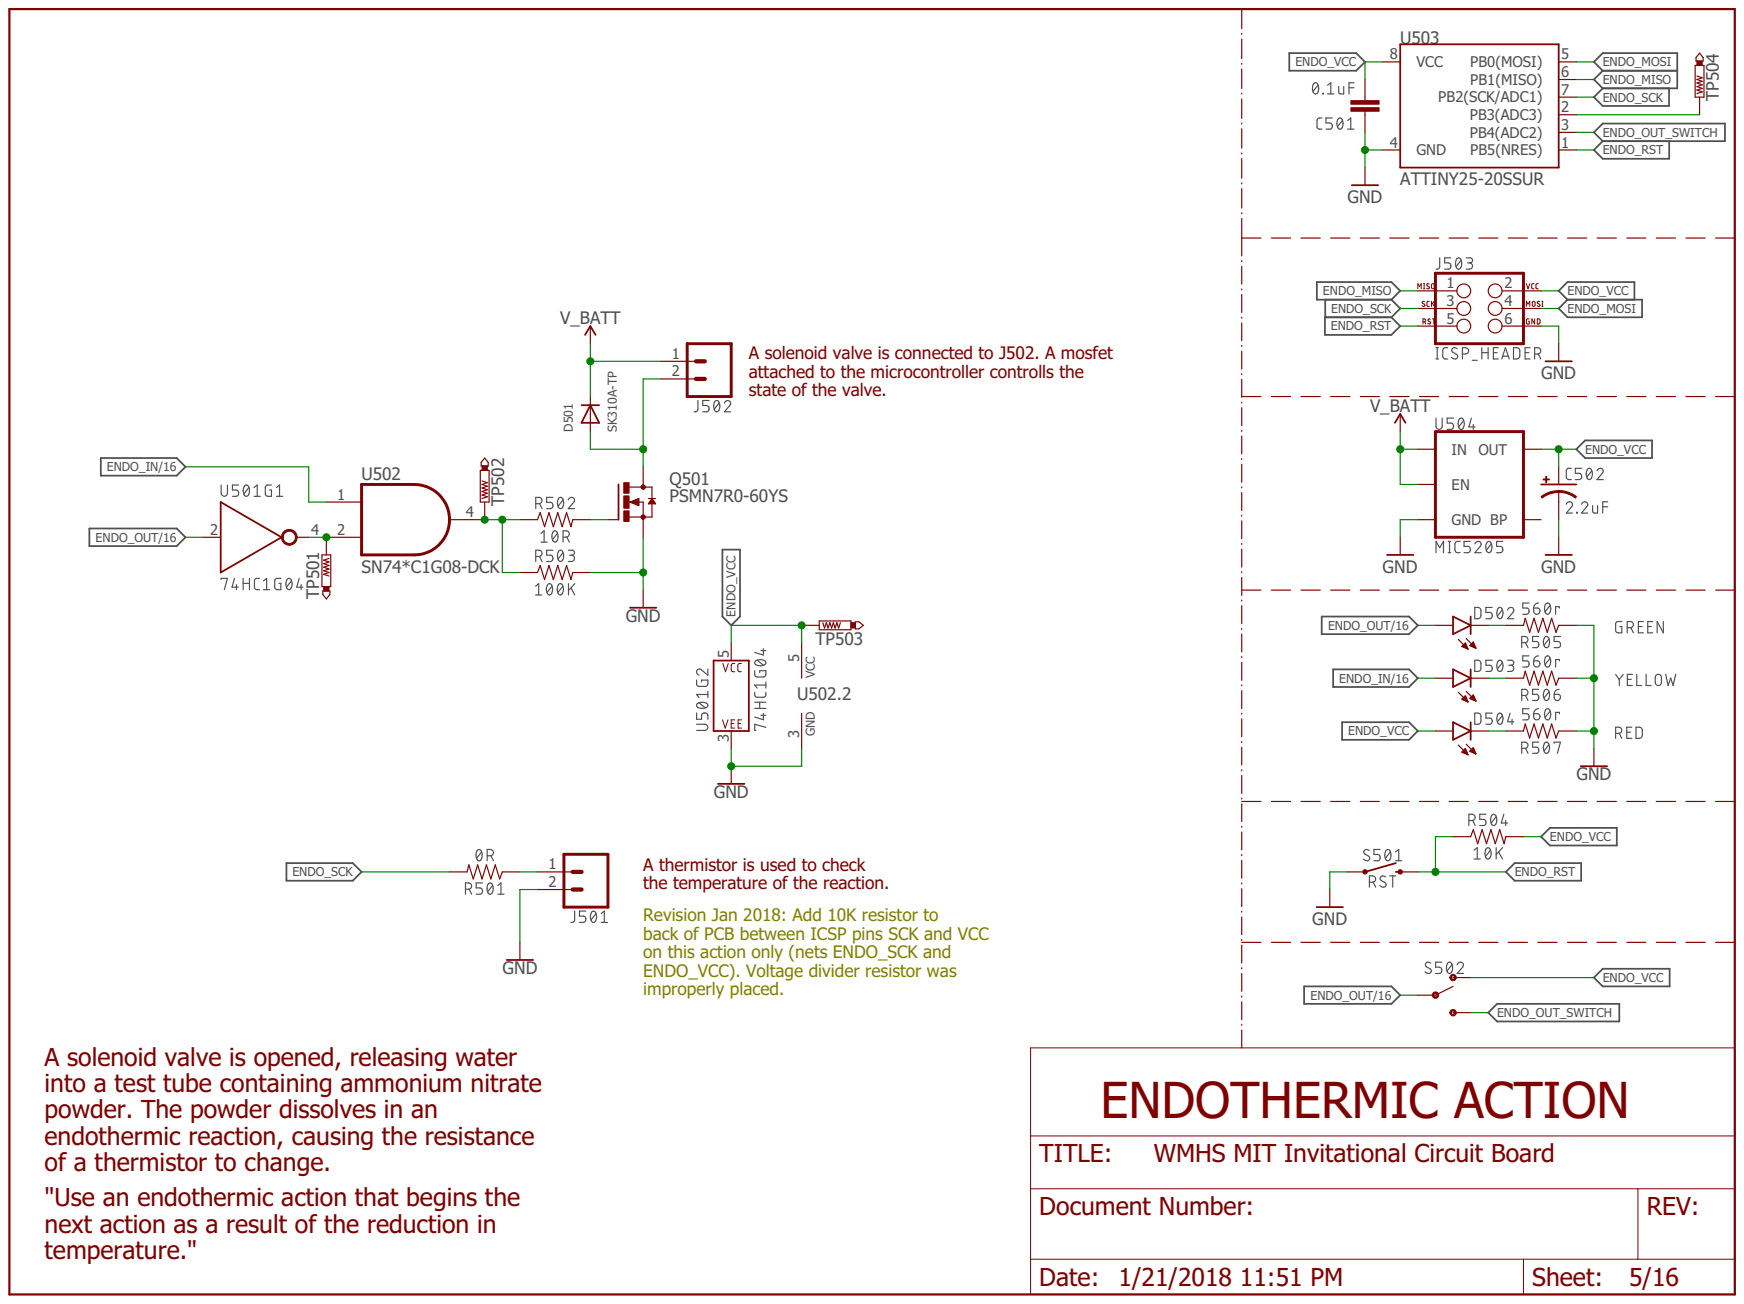
[picture p39: page 5]

A solenoid valve is connected to J502. A mosfet attached to the microcontroller controlls the

state of the valve.

A thermistor is used to check
the temperature of the reaction.

Revision Jan 2018: Add 10K resistor to back of PCB between ICSP pins SCK and VCC

on this action only (nets ENDO_SCK and
ENDO_VCC). Voltage divider resistor was

A solenoid valve is opened, releasing water
into a test tube containing ammonium nitrate
powder. The powder dissolves in an
endothermic reaction, causing the resistance
"Use an endothermic action that begins the
next action as a result of the reduction in
temperature."

WMHS MIT Invitational Circuit Board

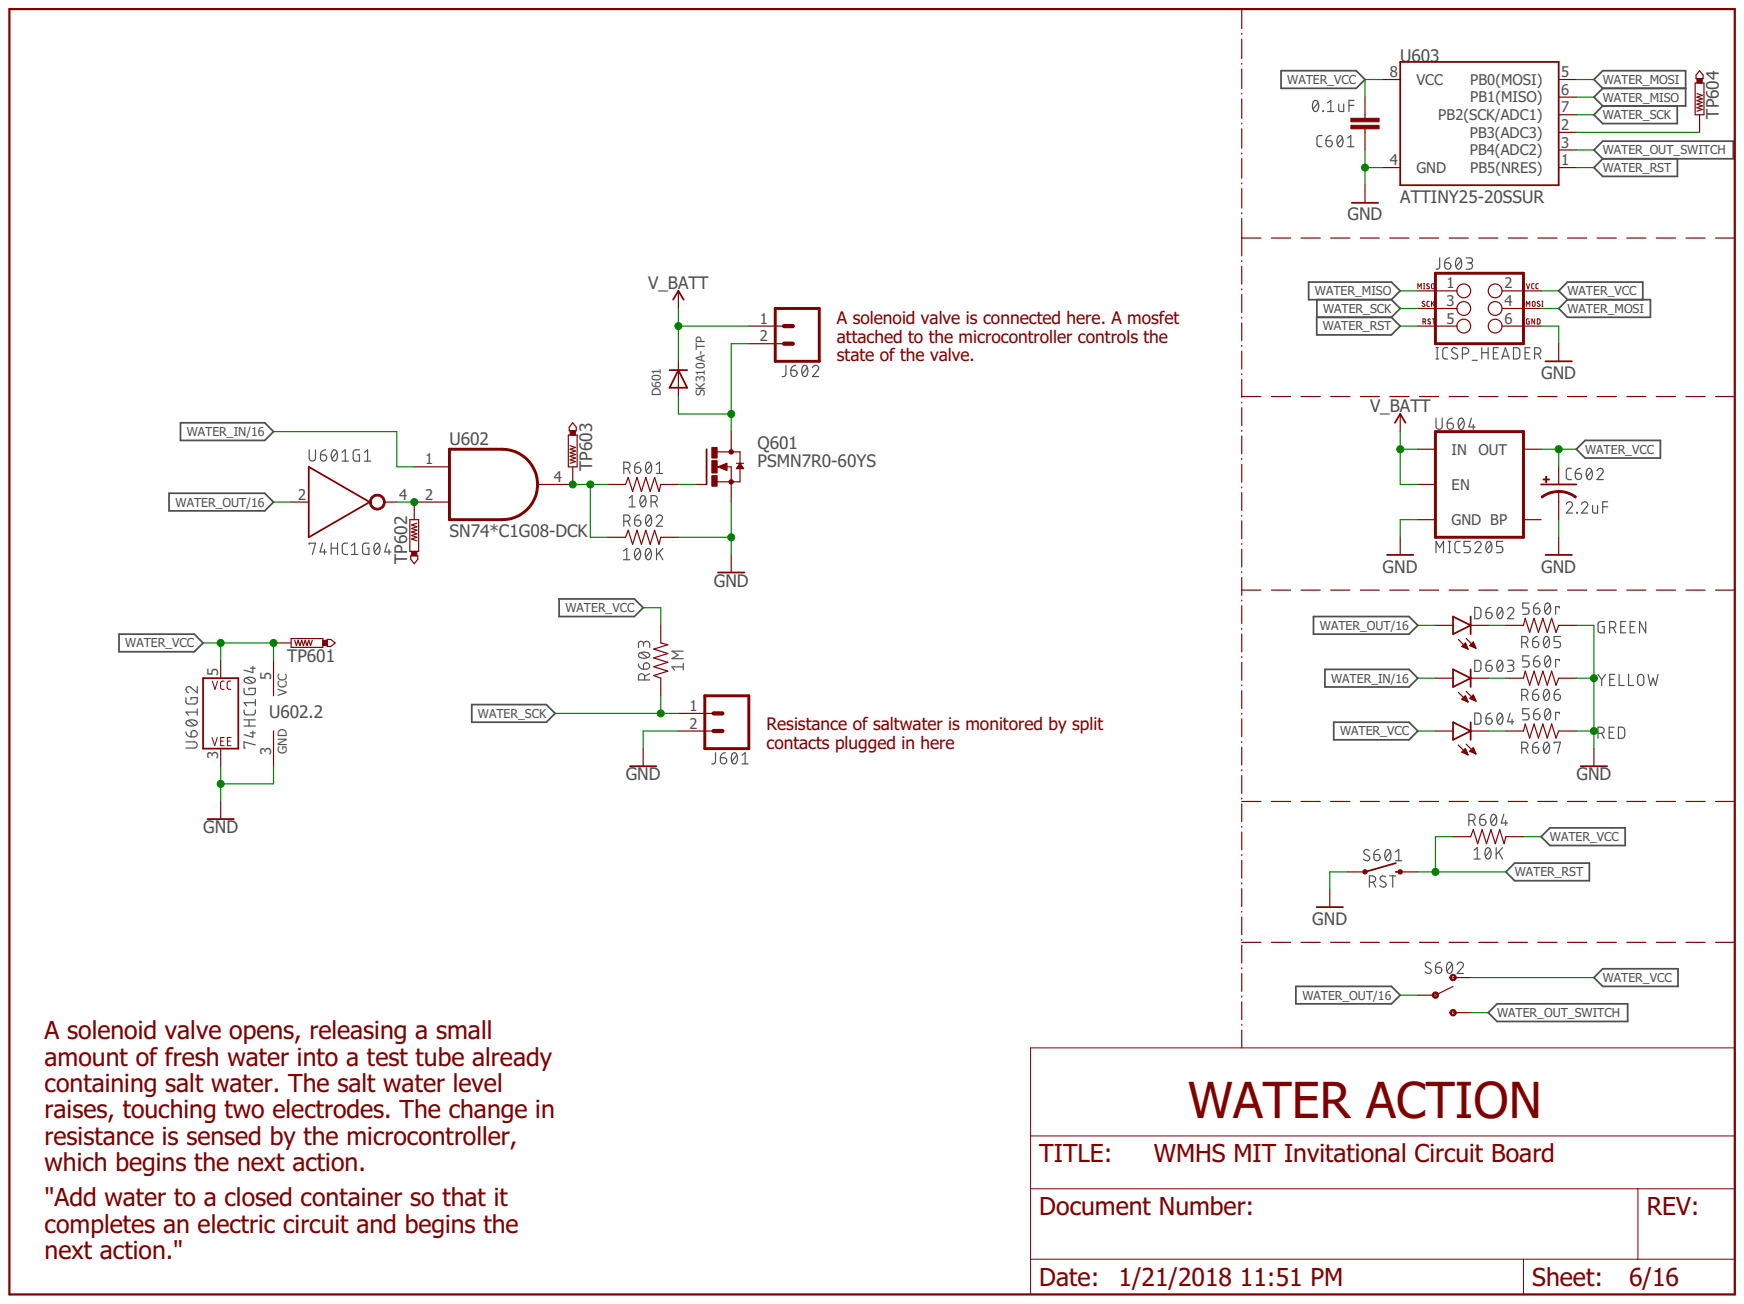
[picture p40: page 6]

A solenoid valve is connected here. A mosfet attached to the microcontroller controls the

state of the valve.

Resistance of saltwater is monitored by split contacts plugged in here

A solenoid valve opens, releasing a small
amount of fresh water into a test tube already
containing salt water. The salt water level
raises, touching two electrodes. The change in

WMHS MIT Invitational Circuit Board

"Add water to a closed container so that it
completes an electric circuit and begins the
next action."

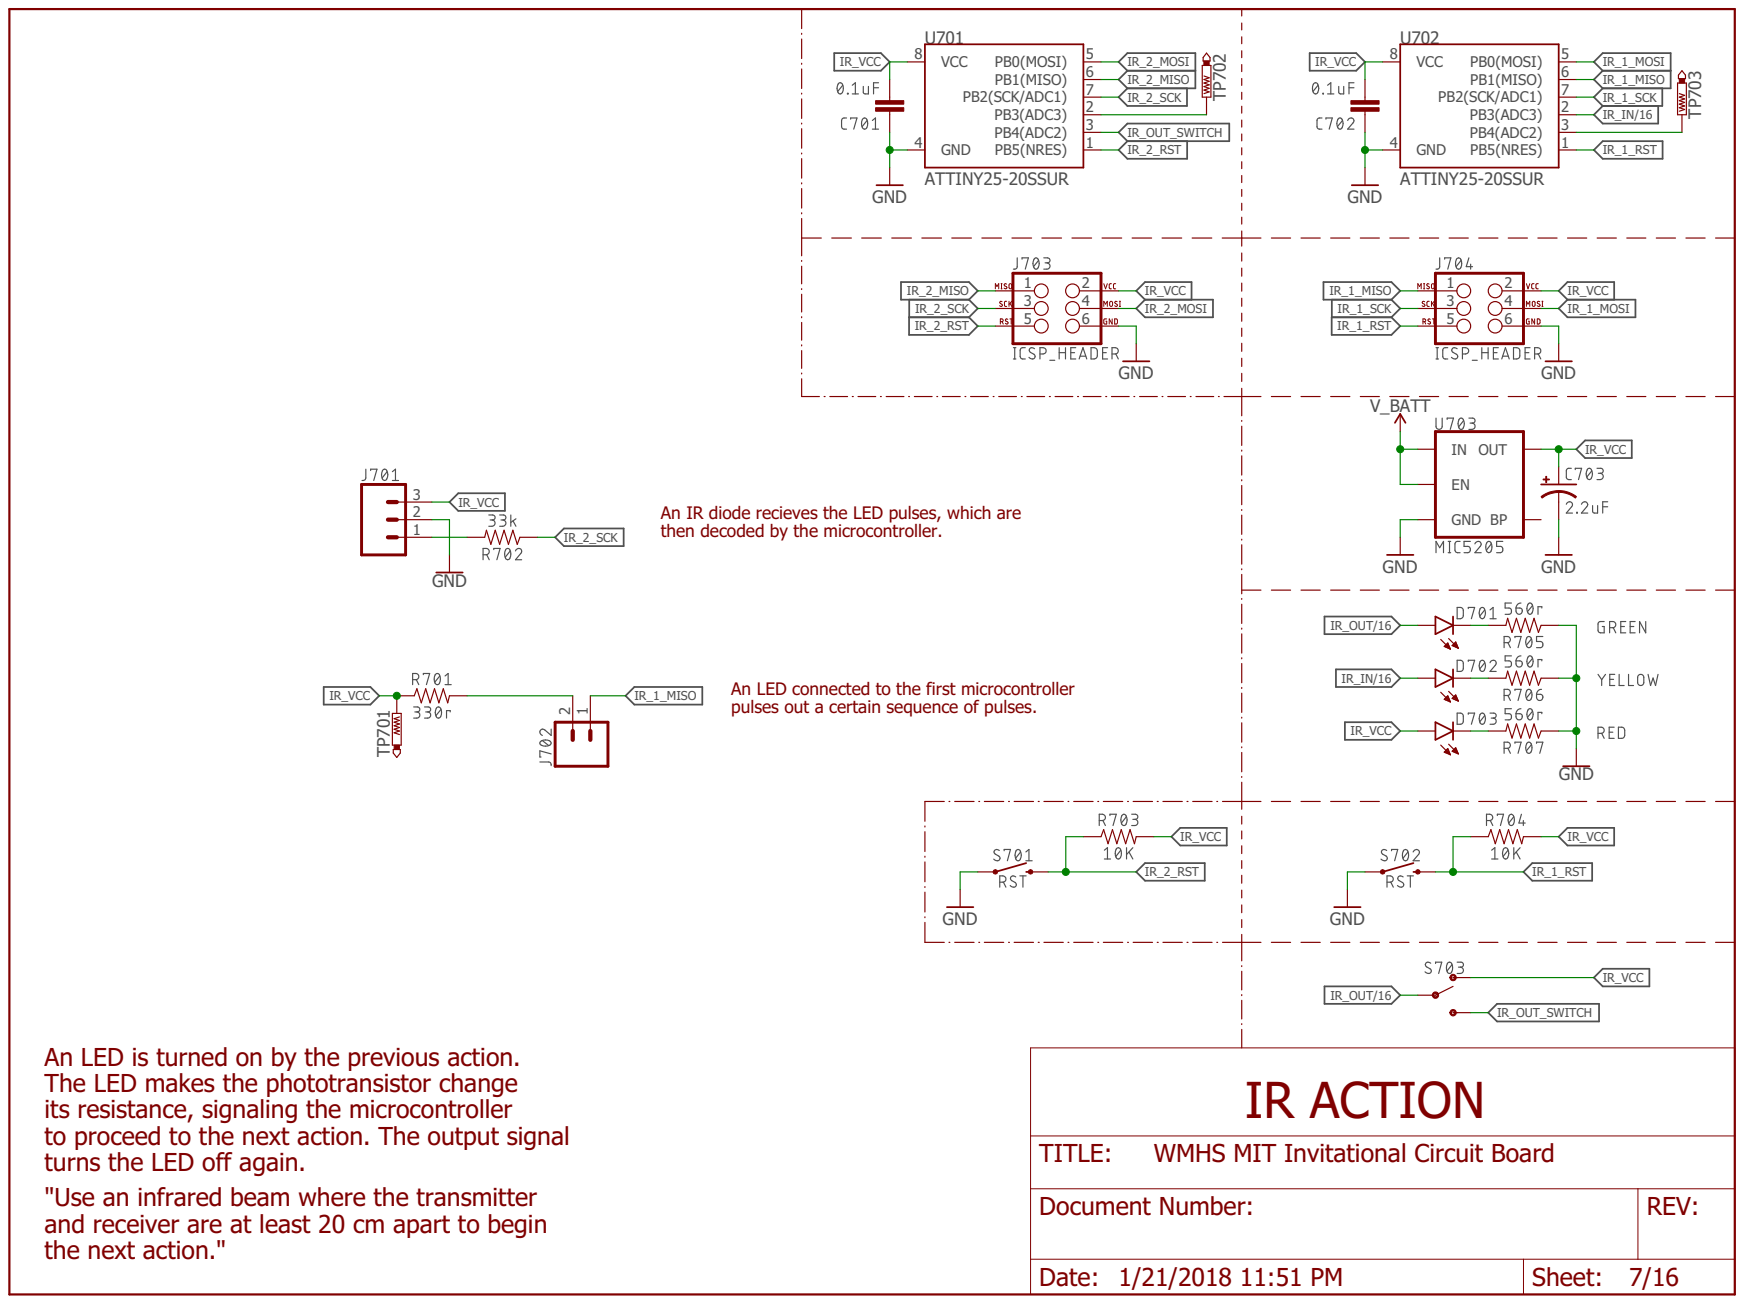
[picture p41: page 7]

An IR diode recieves the LED pulses, which are
then decoded by the microcontroller.

An LED connected to the first microcontroller pulses out a certain sequence of pulses.

An LED is turned on by the previous action. The LED makes the phototransistor change

its resistance, signaling the microcontroller
to proceed to the next action. The output signal
"Use an infrared beam where the transmitter
and receiver are at least 20 cm apart to begin
the next action."

WMHS MIT Invitational Circuit Board

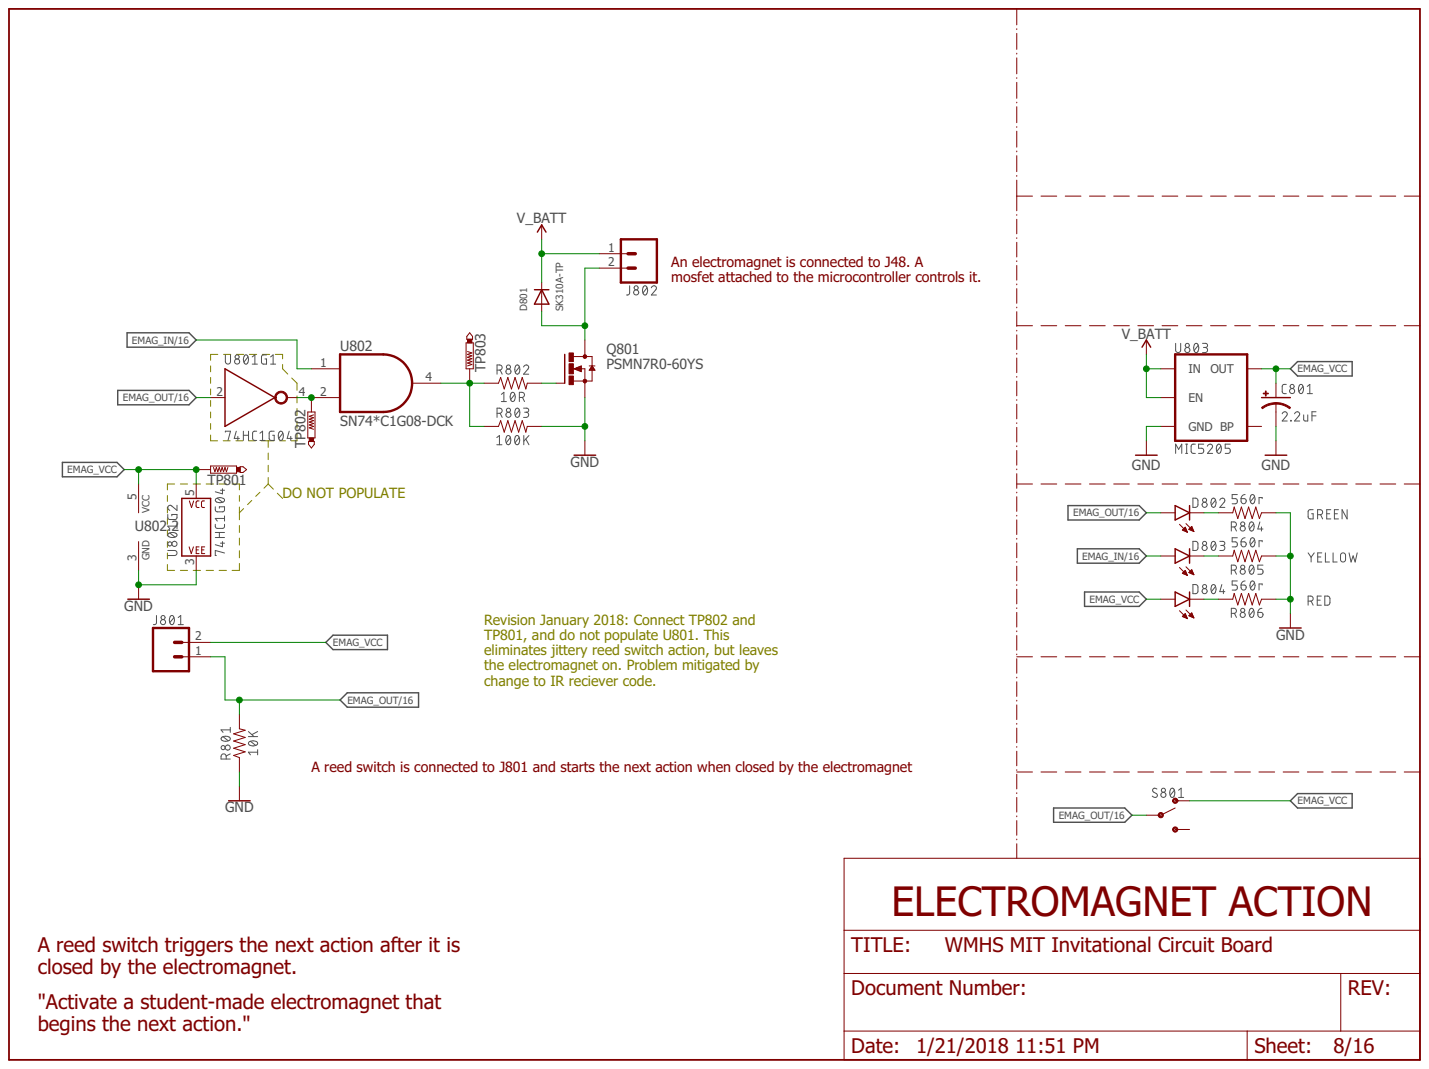
[picture p42: page 8]

An electromagnet is connected to J48. A mosfet attached to the microcontroller controls it.

Revision January 2018: Connect TP802 and
TP801, and do not populate U801. This eliminates jittery reed switch action, but leaves

the electromagnet on. Problem mitigated by
change to IR reciever code.

A reed switch is connected to J801 and starts the next action when closed by the electromagnet

A reed switch triggers the next action after it is
closed by the electromagnet.

WMHS MIT Invitational Circuit Board

Document Number: | REV:

"Activate a student-made electromagnet that
begins the next action."

Date: 1/21/2018 11:51 PM | Sheet: 8/16

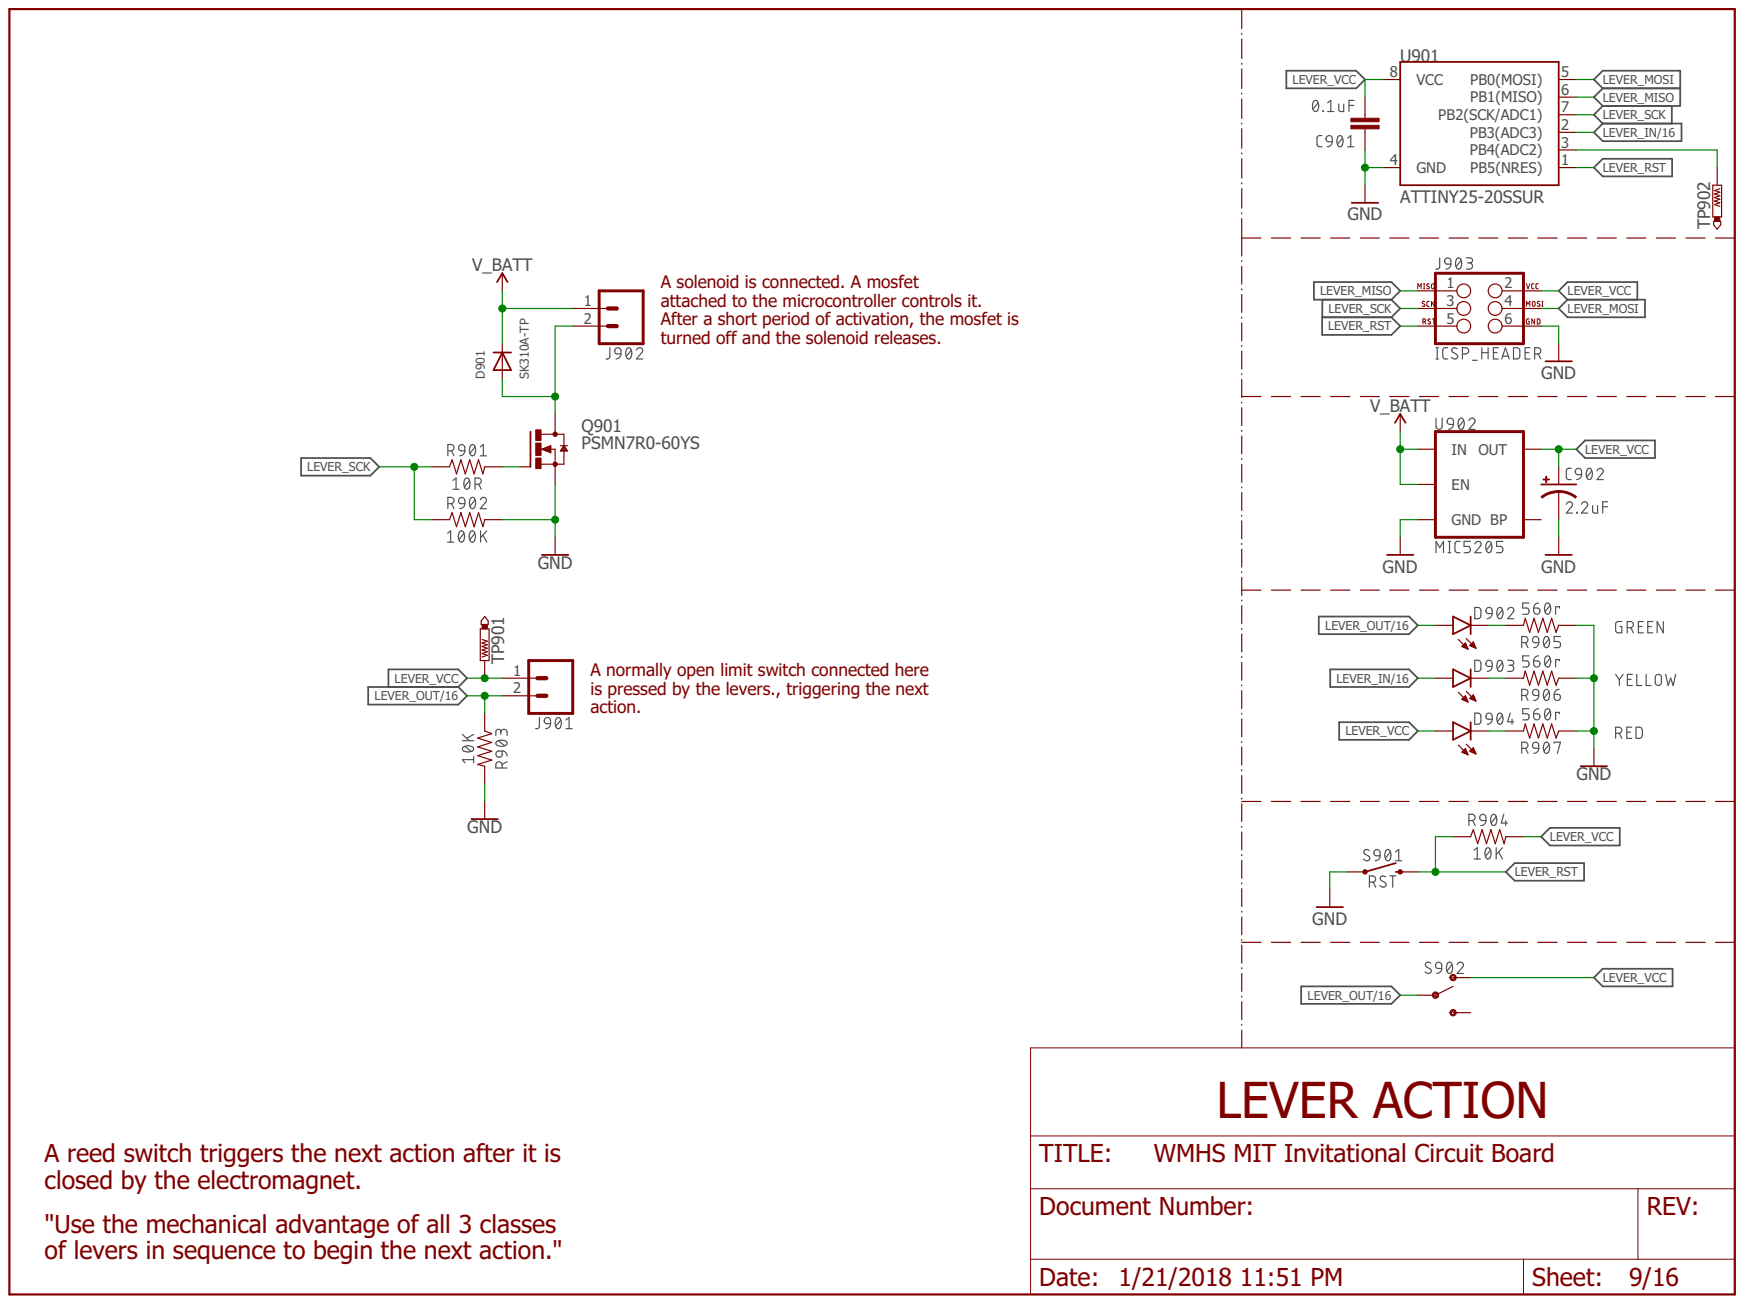
[picture p43: page 9]

A solenoid is connected. A mosfet attached to the microcontroller controls it. After a short period of activation, the mosfet is

turned off and the solenoid releases.

A normally open limit switch connected here
is pressed by the levers., triggering the next action.

A reed switch triggers the next action after it is

WMHS MIT Invitational Circuit Board

"Use the mechanical advantage of all 3 classes
of levers in sequence to begin the next action."

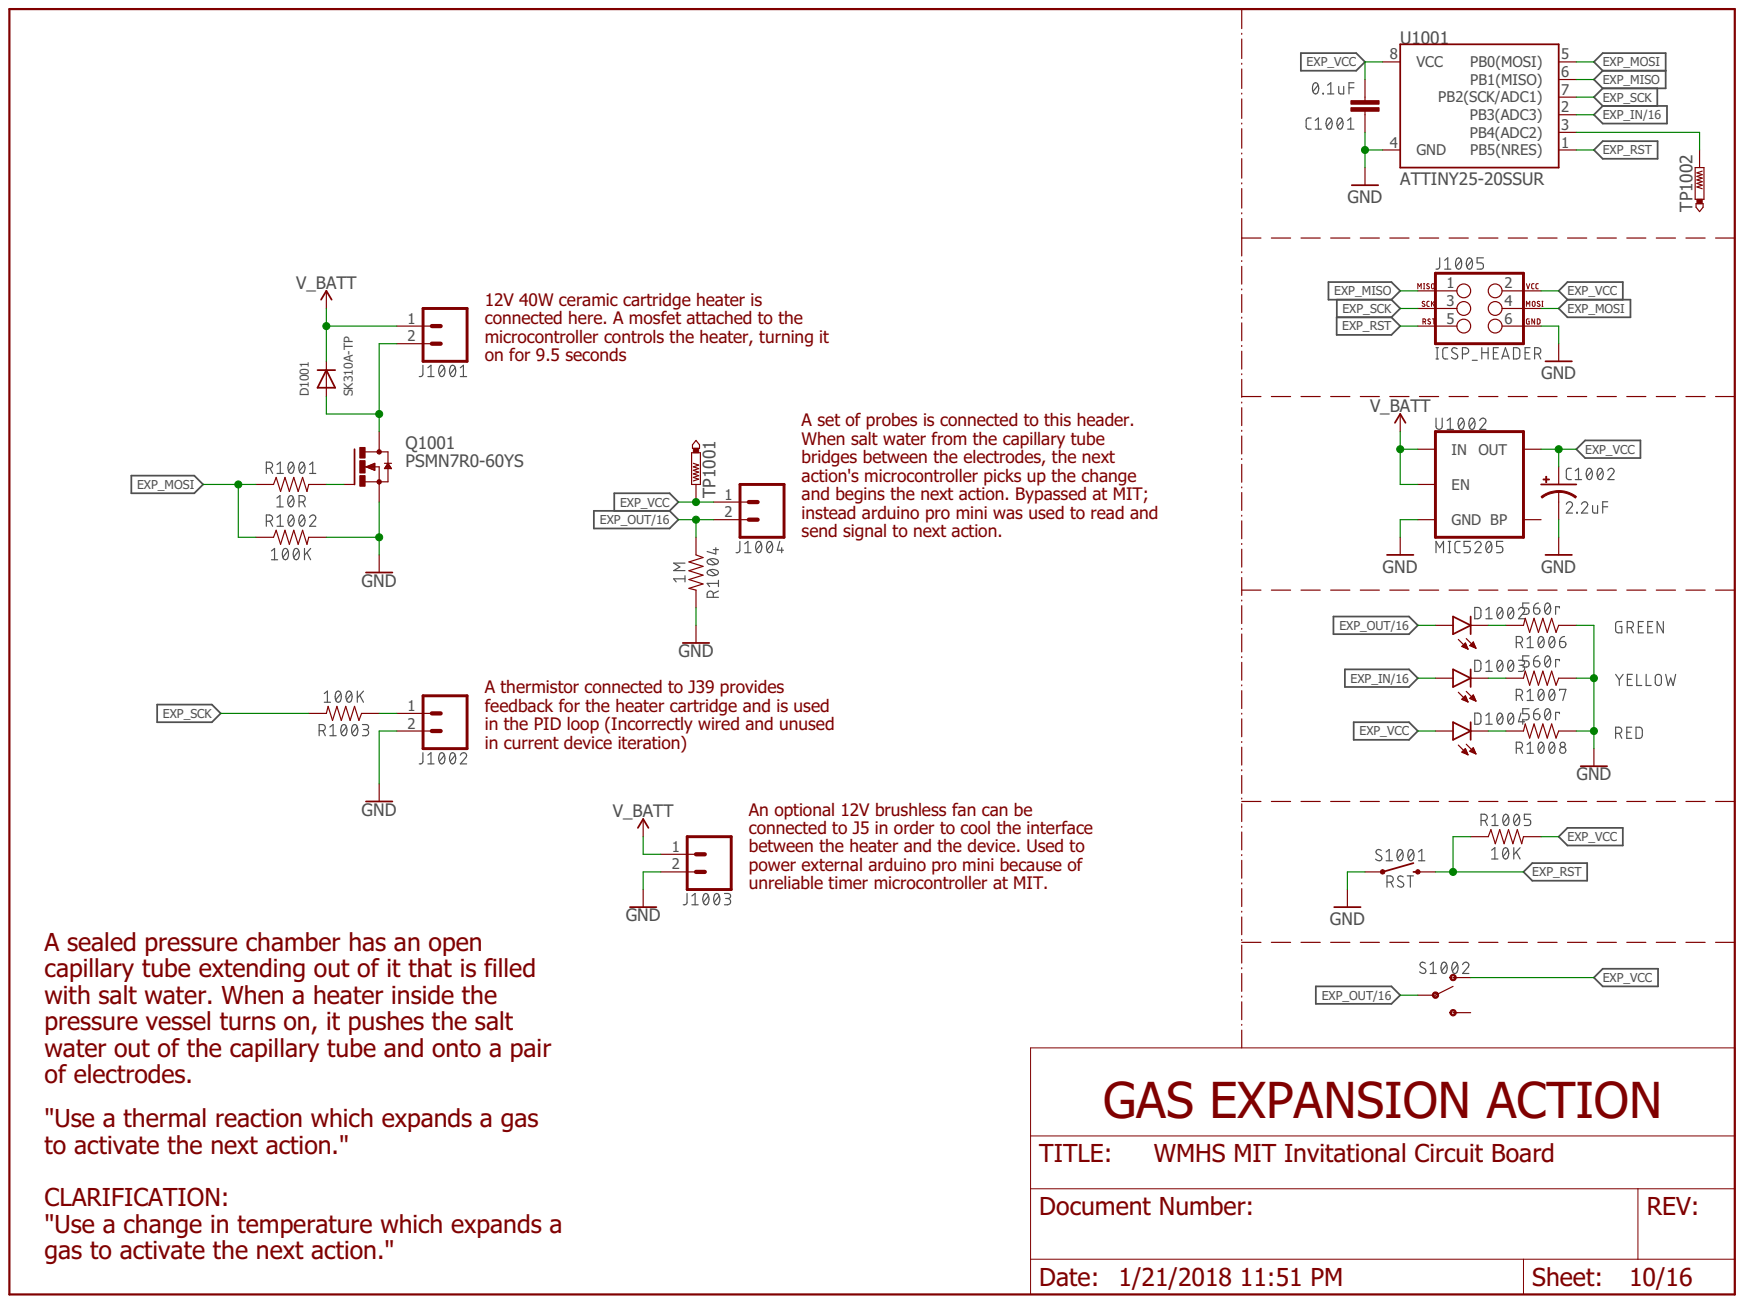
[picture p44: page 10]

and begins the next action. Bypassed at MIT;
instead arduino pro mini was used to read and
send signal to next action.

A thermistor connected to J39 provides
feedback for the heater cartridge and is used
in the PID loop (Incorrectly wired and unused
in current device iteration)

An optional 12V brushless fan can be

connected to J5 in order to cool the interface between the heater and the device. Used to power external arduino pro mini because of unreliable timer microcontroller at MIT. A sealed pressure chamber has an open

capillary tube extending out of it that is filled
with salt water. When a heater inside the
pressure vessel turns on, it pushes the salt
water out of the capillary tube and onto a pair

to activate the next action." CLARIFICATION: "Use a change in temperature which expands a

WMHS MIT Invitational Circuit Board

gas to activate the next action."

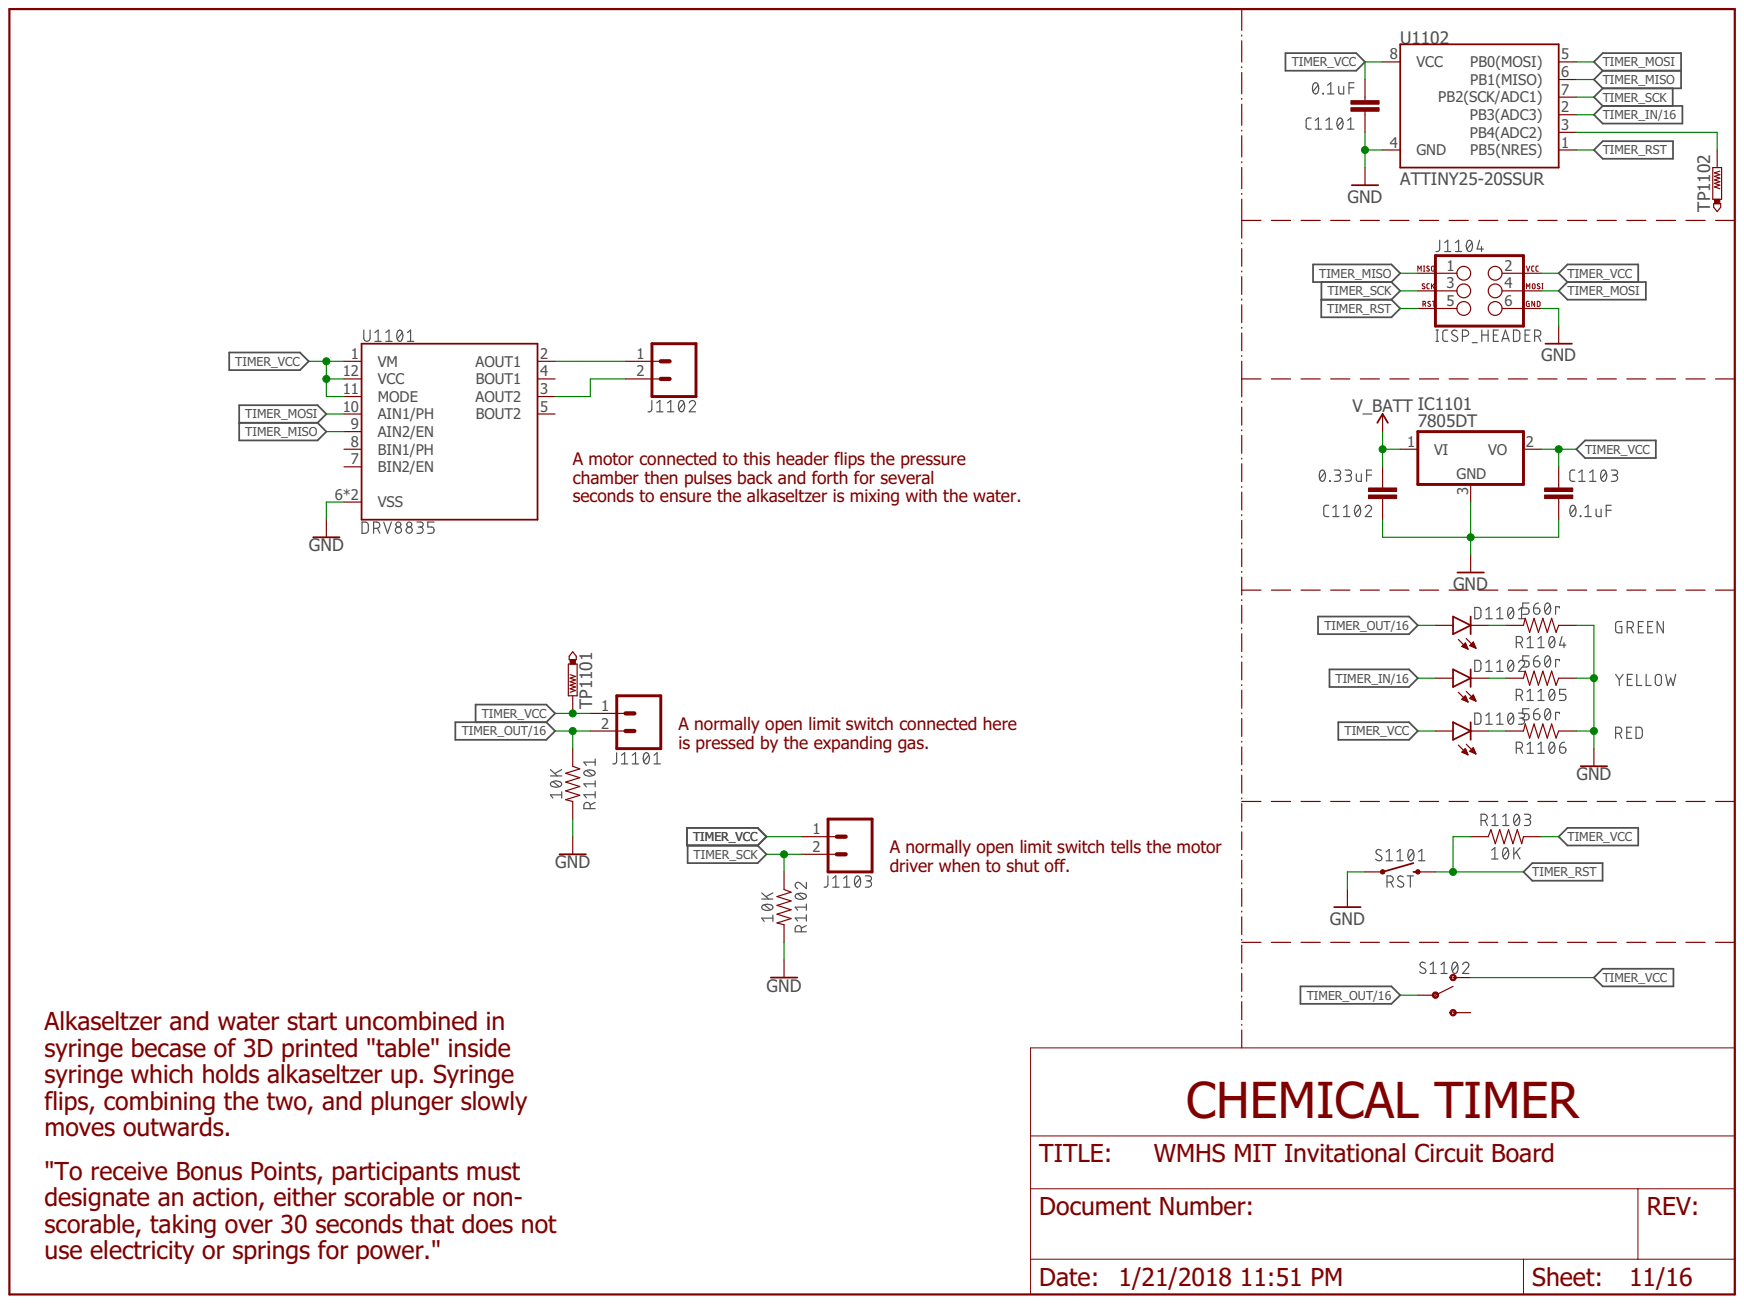
[picture p45: page 11]

A motor connected to this header flips the pressure
chamber then pulses back and forth for several seconds to ensure the alkaseltzer is mixing with the water.

A normally open limit switch connected here
is pressed by the expanding gas.

A normally open limit switch tells the motor driver when to shut off. Alkaseltzer and water start uncombined in

syringe becase of 3D printed "table" inside
syringe which holds alkaseltzer up. Syringe
flips, combining the two, and plunger slowly

WMHS MIT Invitational Circuit Board

"To receive Bonus Points, participants must
designate an action, either scorable or non- scorable, taking over 30 seconds that does not

use electricity or springs for power."

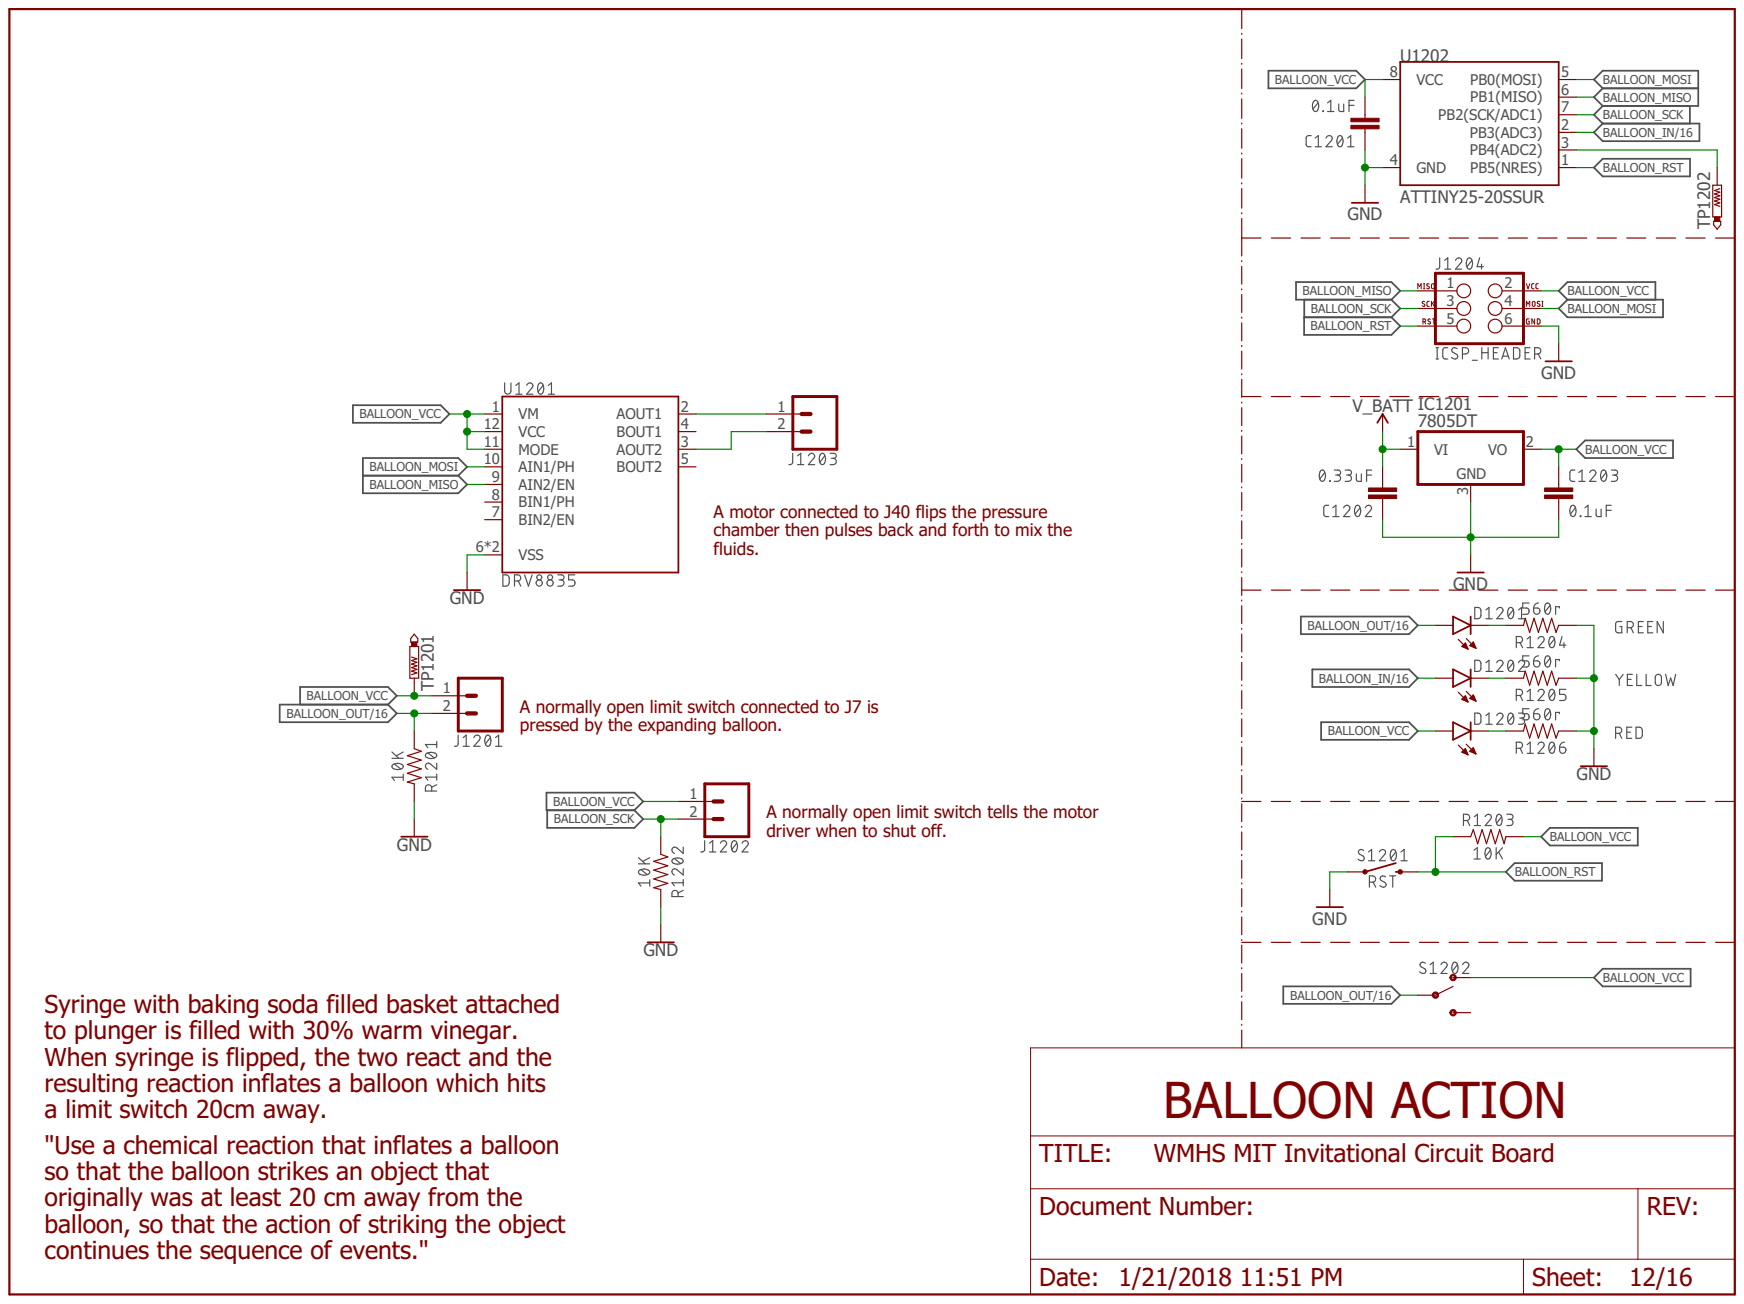
[picture p46: page 12]

A motor connected to J40 flips the pressure
chamber then pulses back and forth to mix the
fluids.

A normally open limit switch connected to J7 is pressed by the expanding balloon.

A normally open limit switch tells the motor driver when to shut off.

Syringe with baking soda filled basket attached
to plunger is filled with 30% warm vinegar. When syringe is flipped, the two react and the

resulting reaction inflates a balloon which hits
"Use a chemical reaction that inflates a balloon
so that the balloon strikes an object that
originally was at least 20 cm away from the
balloon, so that the action of striking the object
continues the sequence of events."

WMHS MIT Invitational Circuit Board

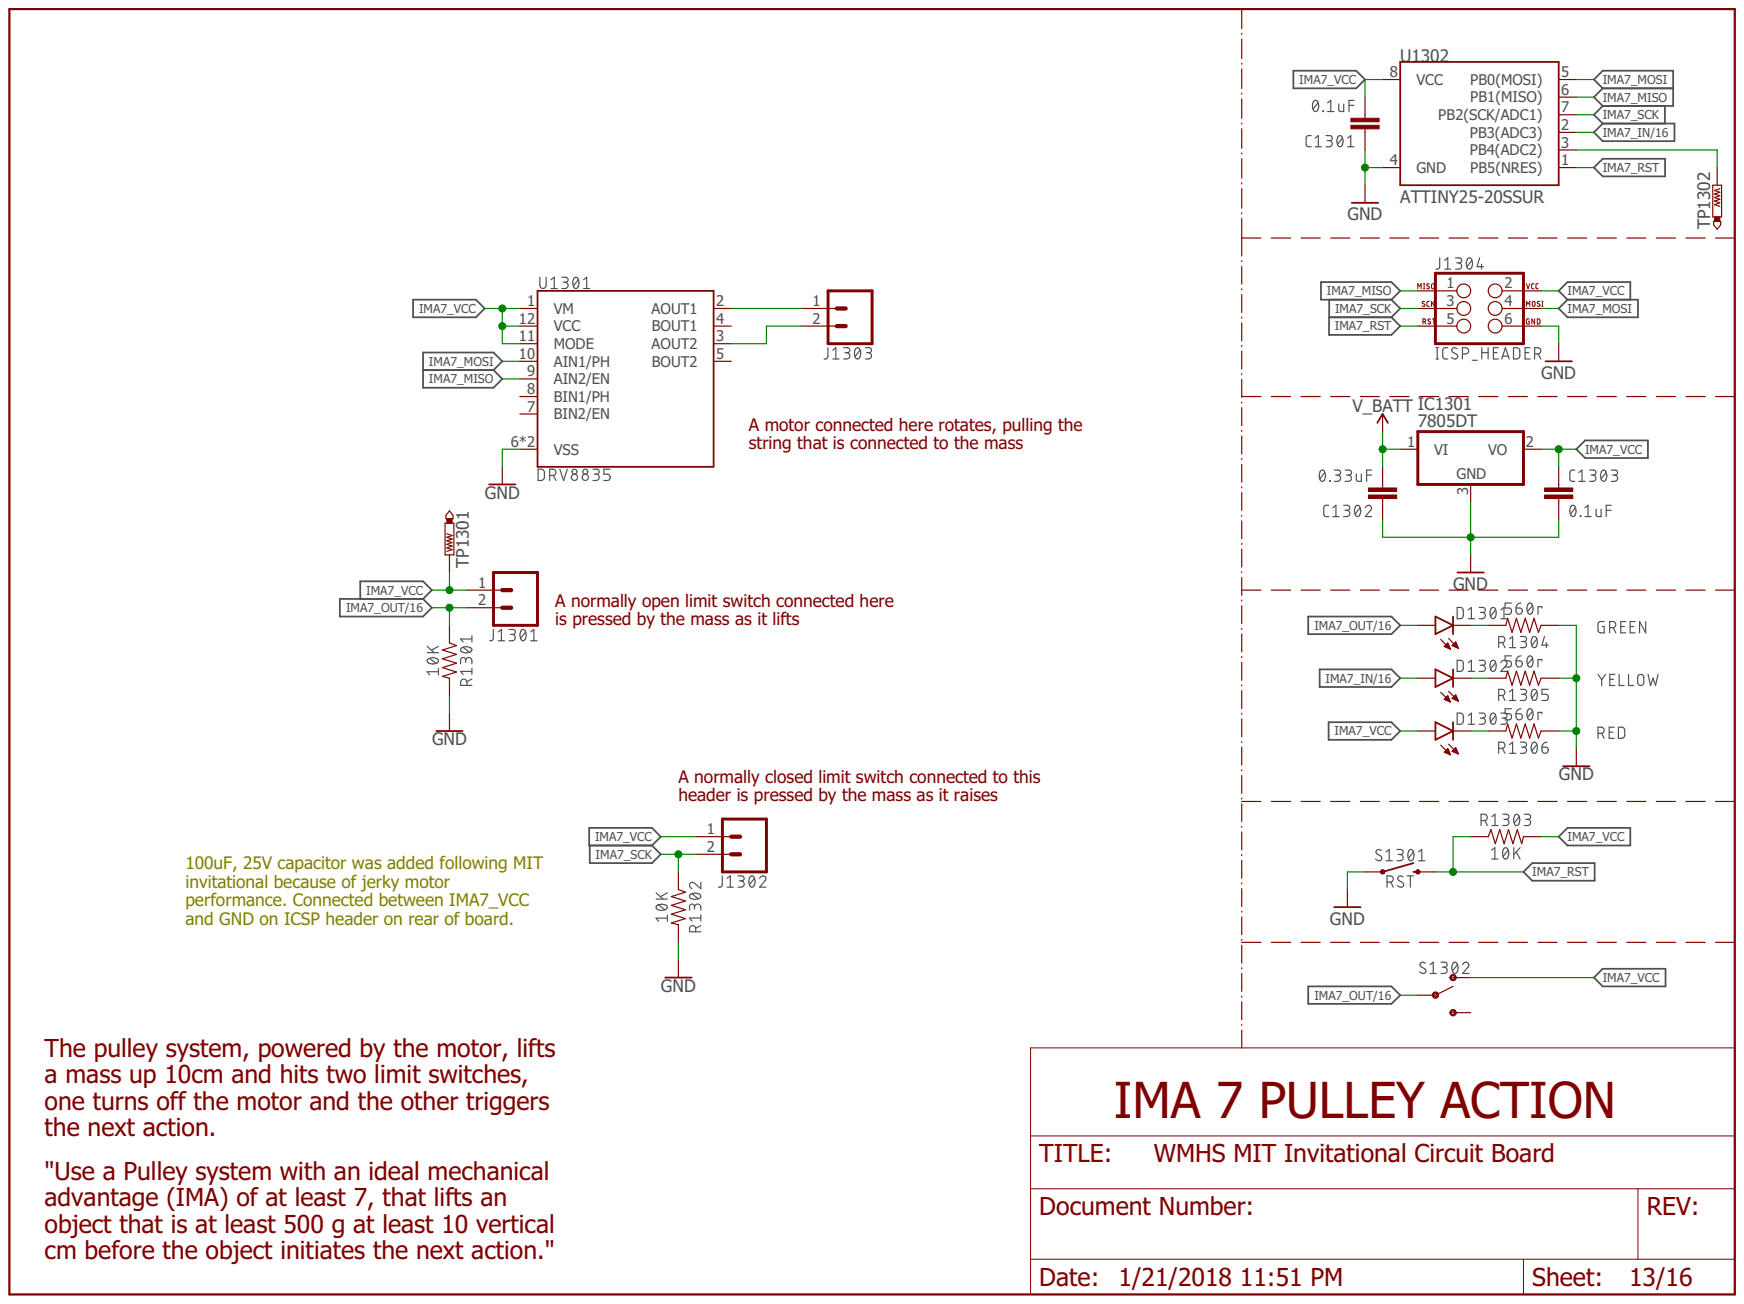
[picture p47: page 13]

A motor connected here rotates, pulling the
string that is connected to the mass

A normally open limit switch connected here
is pressed by the mass as it lifts

A normally closed limit switch connected to this header is pressed by the mass as it raises

100uF, 25V capacitor was added following MIT
invitational because of jerky motor performance. Connected between IMA7_VCC

and GND on ICSP header on rear of board.

The pulley system, powered by the motor, lifts
a mass up 10cm and hits two limit switches, one turns off the motor and the other triggers

WMHS MIT Invitational Circuit Board

"Use a Pulley system with an ideal mechanical
advantage (IMA) of at least 7, that lifts an
object that is at least 500 g at least 10 vertical
cm before the object initiates the next action."

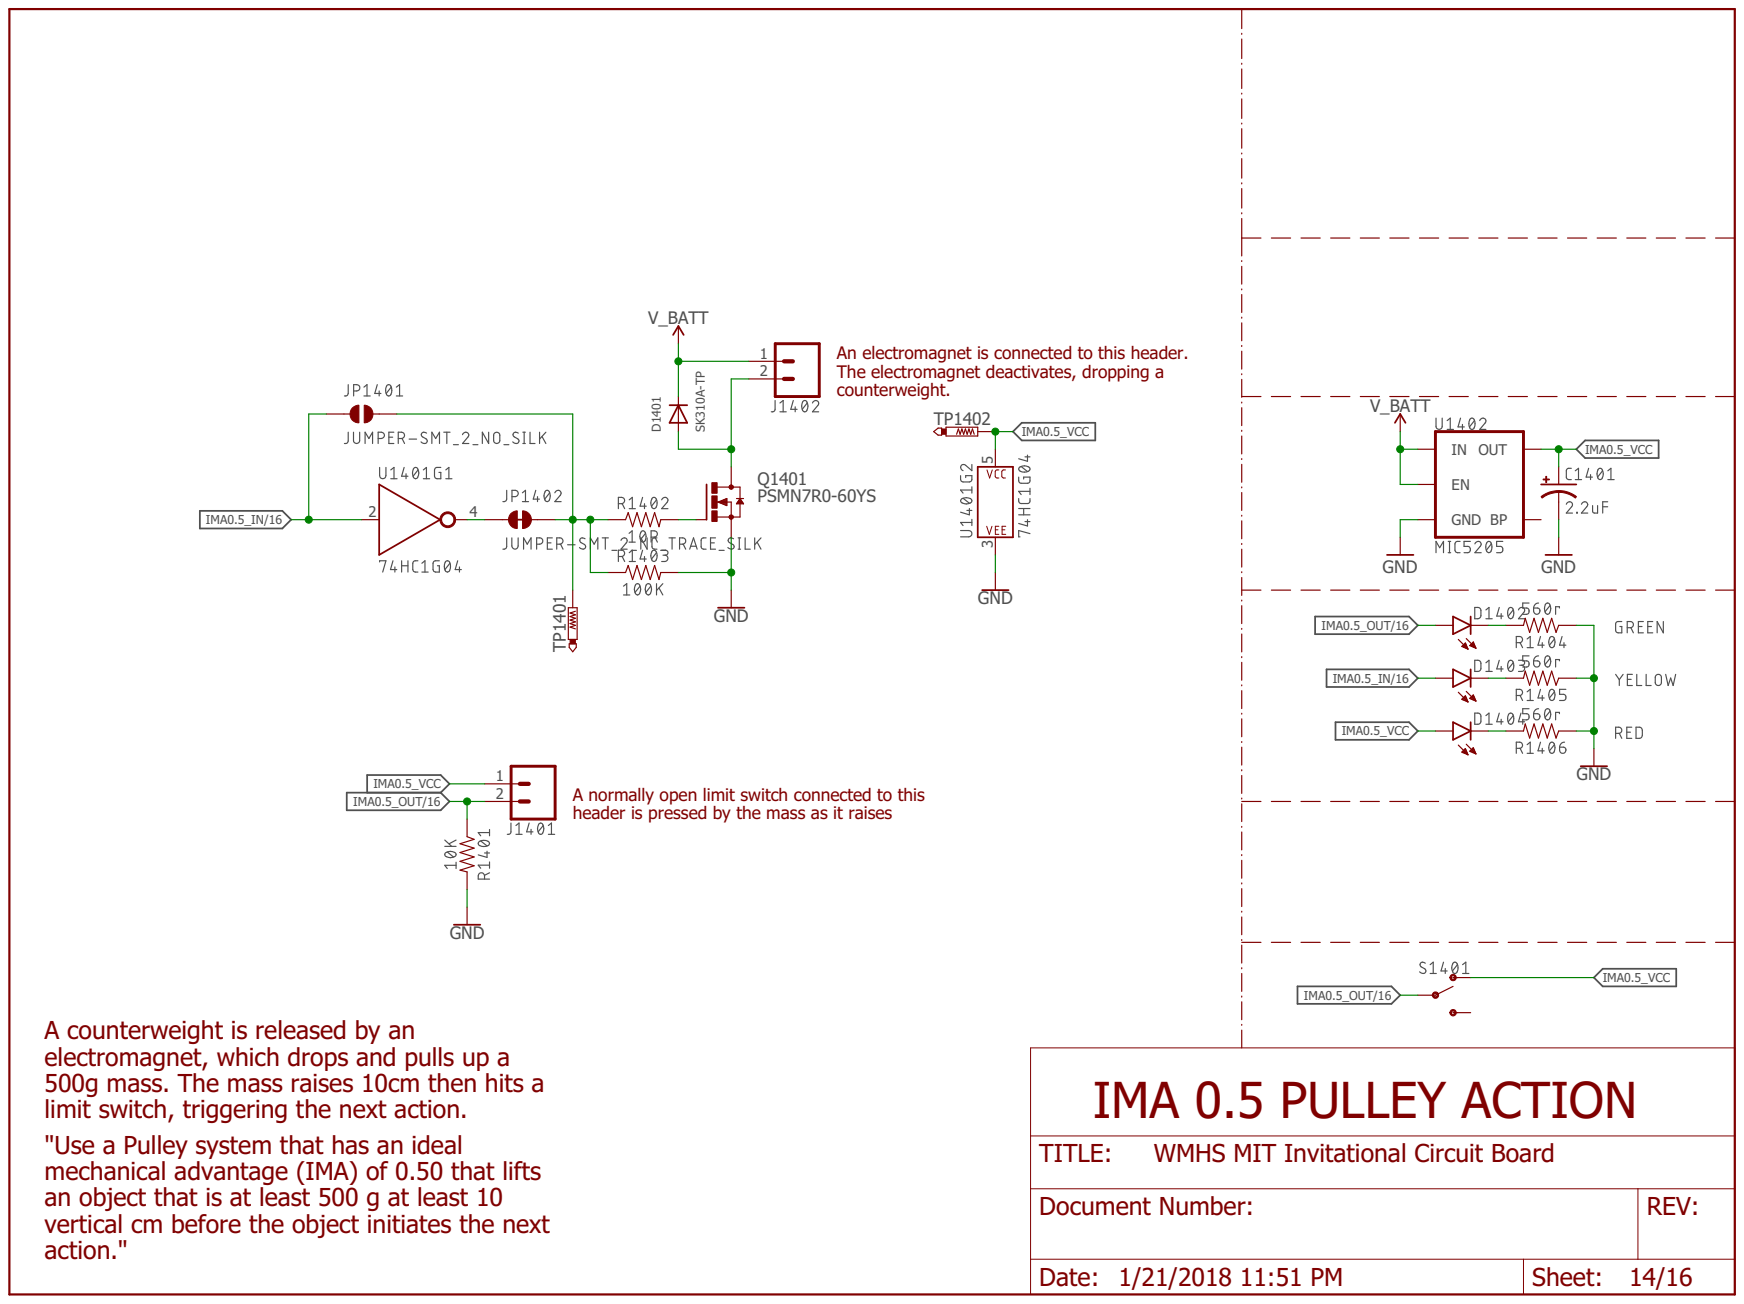
[picture p48: page 14]

An electromagnet is connected to this header. The electromagnet deactivates, dropping a

A normally open limit switch connected to this header is pressed by the mass as it raises

A counterweight is released by an
electromagnet, which drops and pulls up a
500g mass. The mass raises 10cm then hits a
"Use a Pulley system that has an ideal
mechanical advantage (IMA) of 0.50 that lifts
an object that is at least 500 g at least 10
vertical cm before the object initiates the next
action."

WMHS MIT Invitational Circuit Board

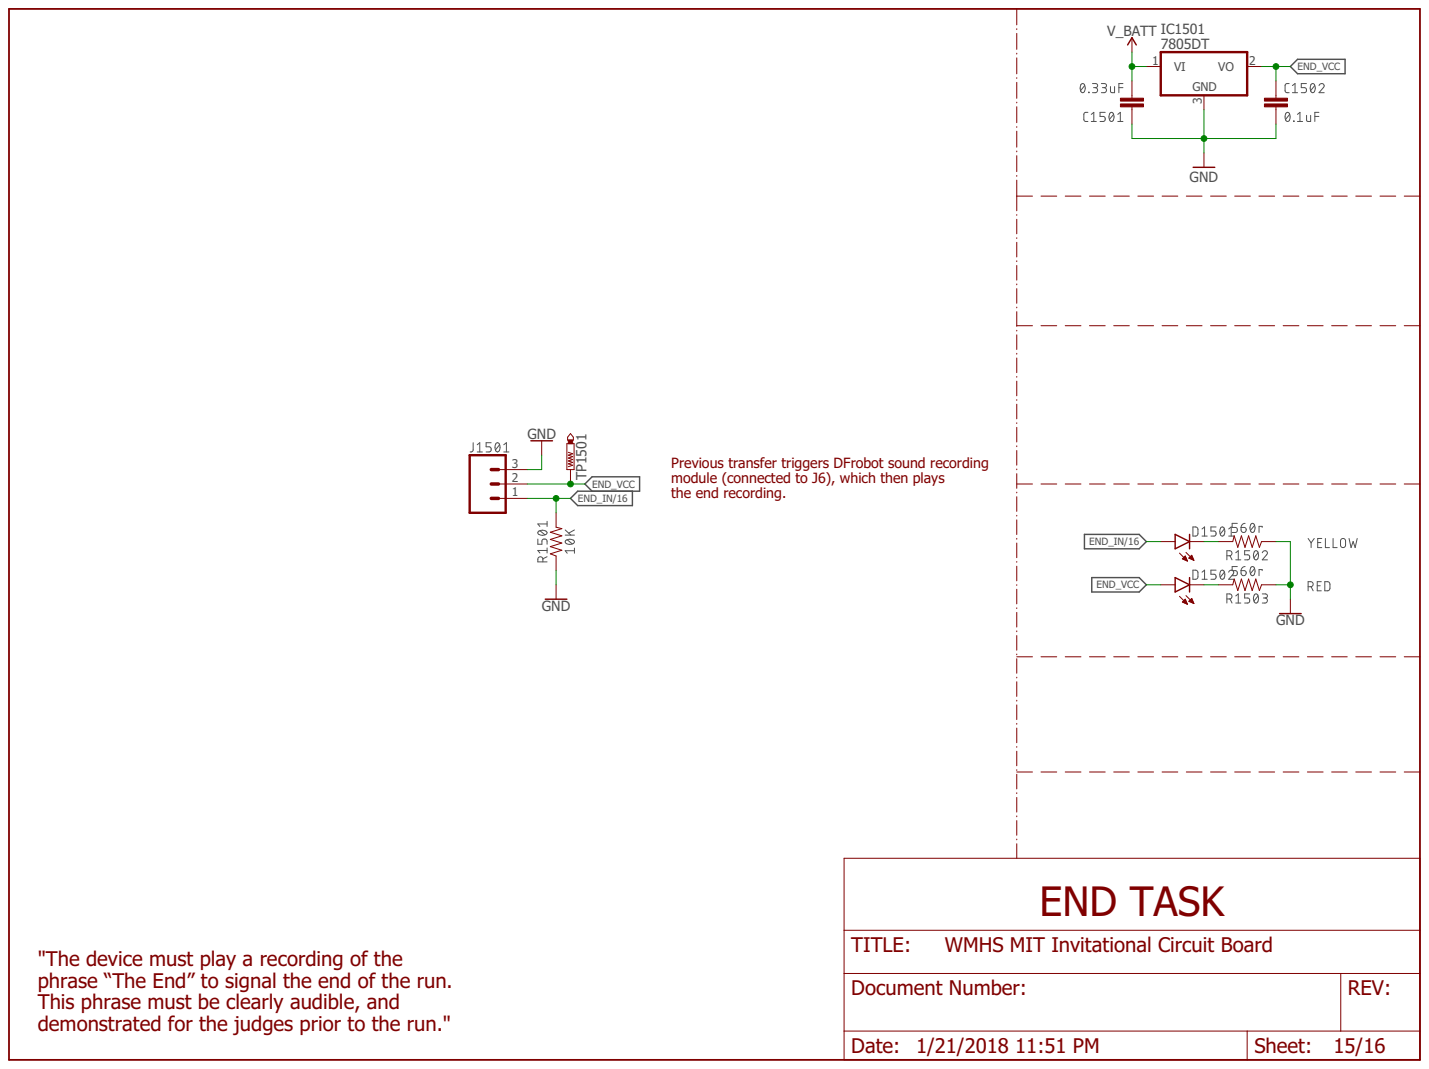
[picture p49: page 15]

Previous transfer triggers DFrobot sound recording module (connected to J6), which then plays

WMHS MIT Invitational Circuit Board

"The device must play a recording of the
phrase “The End” to signal the end of the run. This phrase must be clearly audible, and

Document Number: | REV:

demonstrated for the judges prior to the run."

Date: 1/21/2018 11:51 PM | Sheet: 15/16

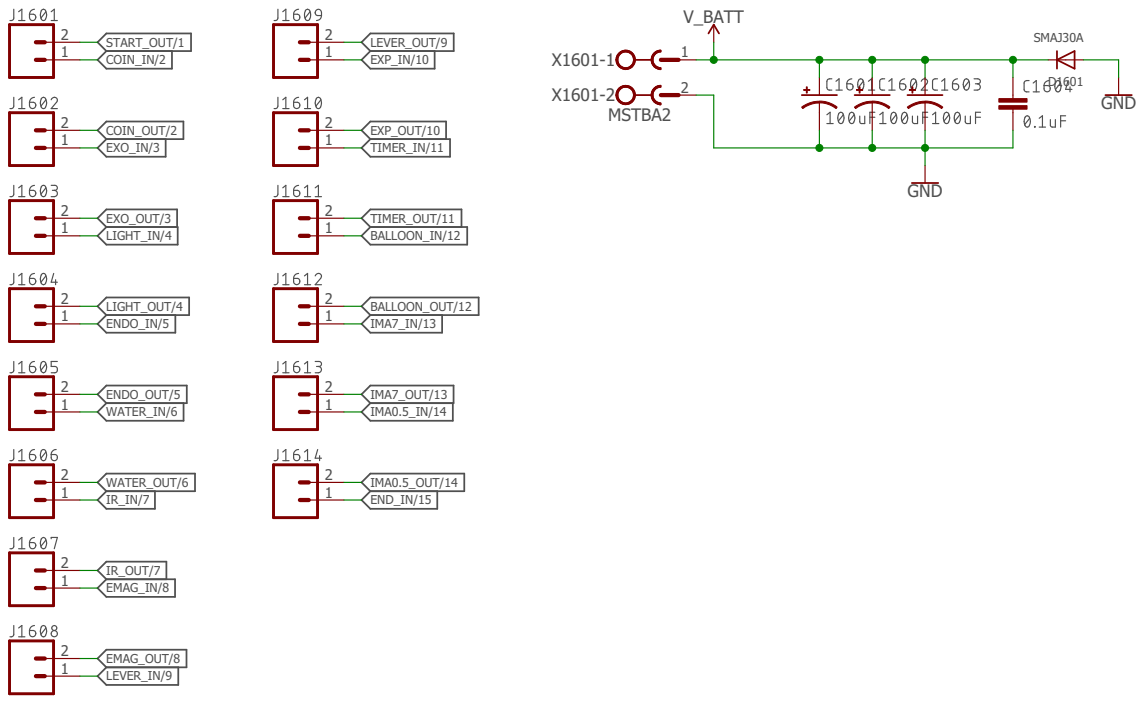
[picture p50: page 16]

Power and Inter-Action

WMHS MIT Invitational Circuit Board

Document Number: | REV:

Date: 1/21/2018 11:51 PM | Sheet: 16/16
