davecutting/Ward-Melville-2018-Mission-Possible/Circuit Board/Eastern LI Regionals Circuit Board/Board Bottom.pdf

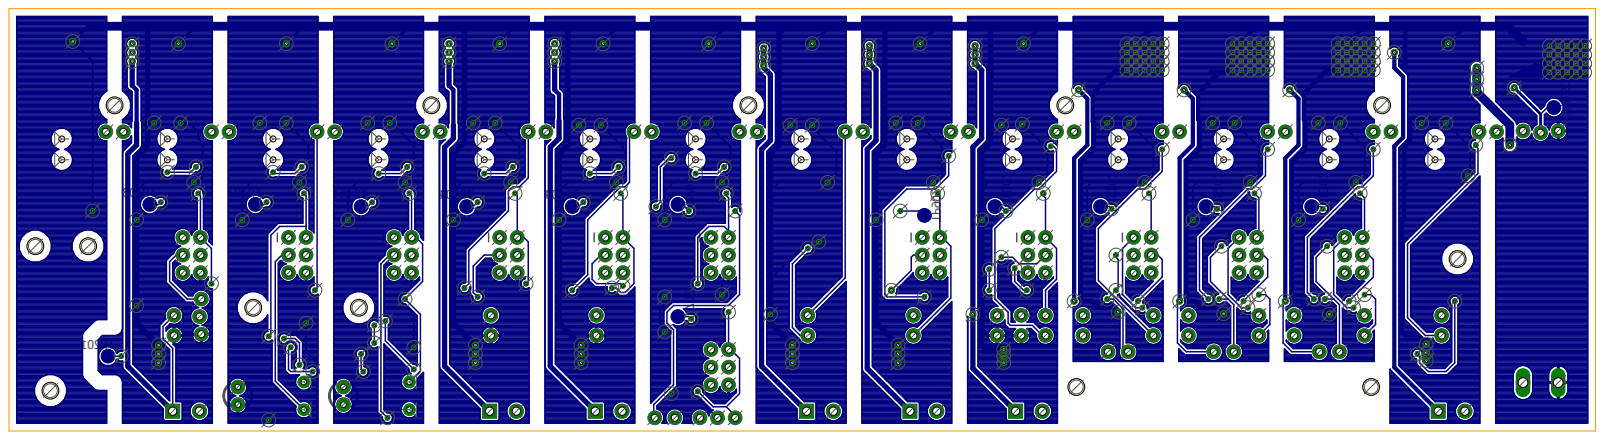
[picture p51: page 1]
