davecutting/Ward-Melville-2018-Mission-Possible/Circuit Board/Eastern LI Regionals Circuit Board/Board Top.pdf

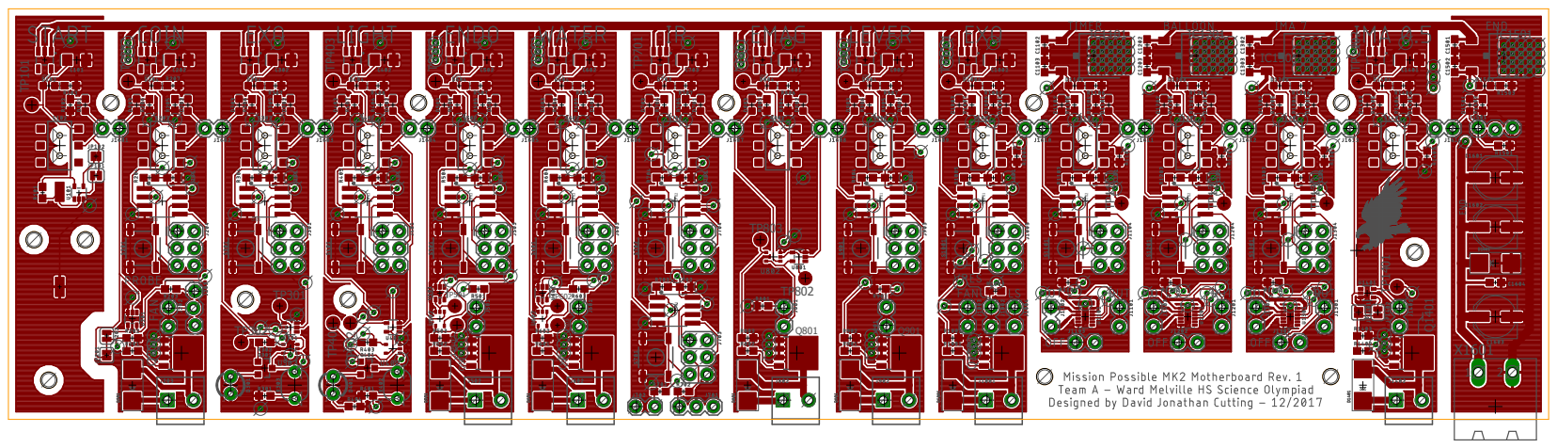
[picture p52: page 1]
