davecutting/Ward-Melville-2018-Mission-Possible/Circuit Board/WMHS Team A Mission Possible Electrical.brd

## EAGLE design Circuit Board/WMHS Team A Mission Possible Electrical.brd (2018-01-22)

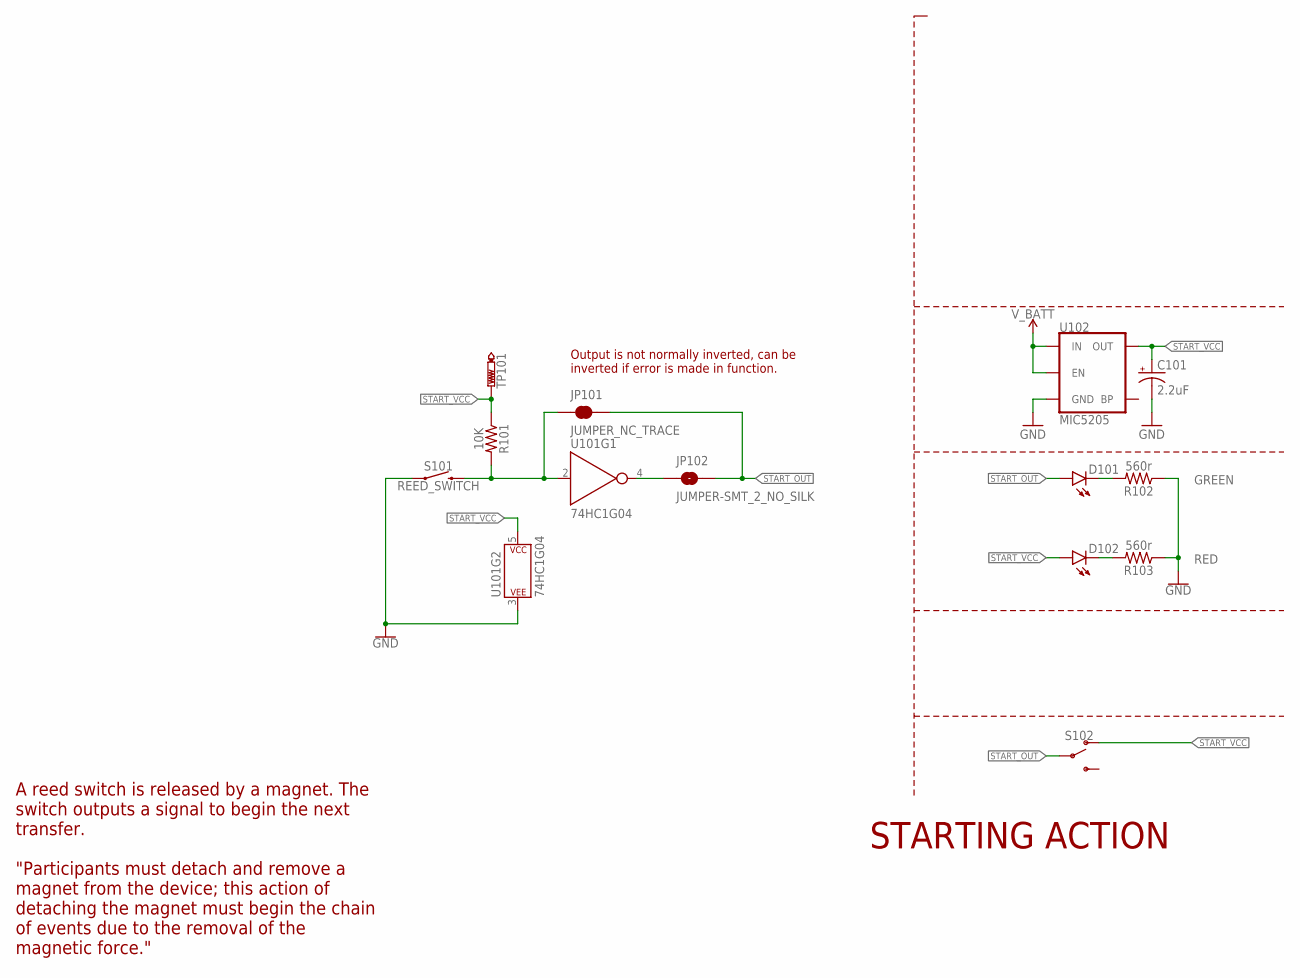
[picture p53: schematic WMHS Team A Mission Possible Electrical.sch, sheet 1, Starting Action]

Parts:
C101: 2.2uF; EIA3216
D101: GREEN; LED-0603
D102: RED; LED-0603
JP101: JUMPER_NC_TRACE; SMT-JUMPER_2_NC_TRACE_SILK
JP102: JUMPER-SMT_2_NO_SILK; SMT-JUMPER_2_NO_SILK
R101: 10K; 0603
R102, R103: 560r; 0603
S101: REED_SWITCH; AXIAL_GULLWING_REED
S102: SWITCH-SPDT-SMD-AYZ0202; SWITCH_DPDT_SMD_AYZ0202
TP101: PTR1TP20R; TP20R
U101: 74HC1G04; SOT353
U102: MIC5205; SOT23-5

Connections:
GND: C101.-, R102.1, R103.1, S101.P$1 (1), U101.3 (P$V-), U102.2 (GND); also elsewhere on the board
unnamed: JP102.1, U101.4 (Y)
unnamed: JP101.1, R101.2, S101.P$2 (2), U101.2 (A)
unnamed: D102.C, R103.2
unnamed: D101.C, R102.2
START_OUT: D101.A, JP101.2, JP102.2, S102.2; also elsewhere on the board
START_VCC: C101.+, D102.A, R101.1, S102.1 (O), TP101.TP, U101.5 (P$V+), U102.5 (OUT)
V_BATT: U102.1 (IN), U102.3 (EN); also elsewhere on the board

Notes on the sheet:
STARTING ACTION
"Participants must detach and remove a magnet from the device; this action of detaching the magnet must begin the chain of events due to the removal of the magnetic force."
A reed switch is released by a magnet. The switch outputs a signal to begin the next transfer.
Output is not normally inverted, can be inverted if error is made in function.

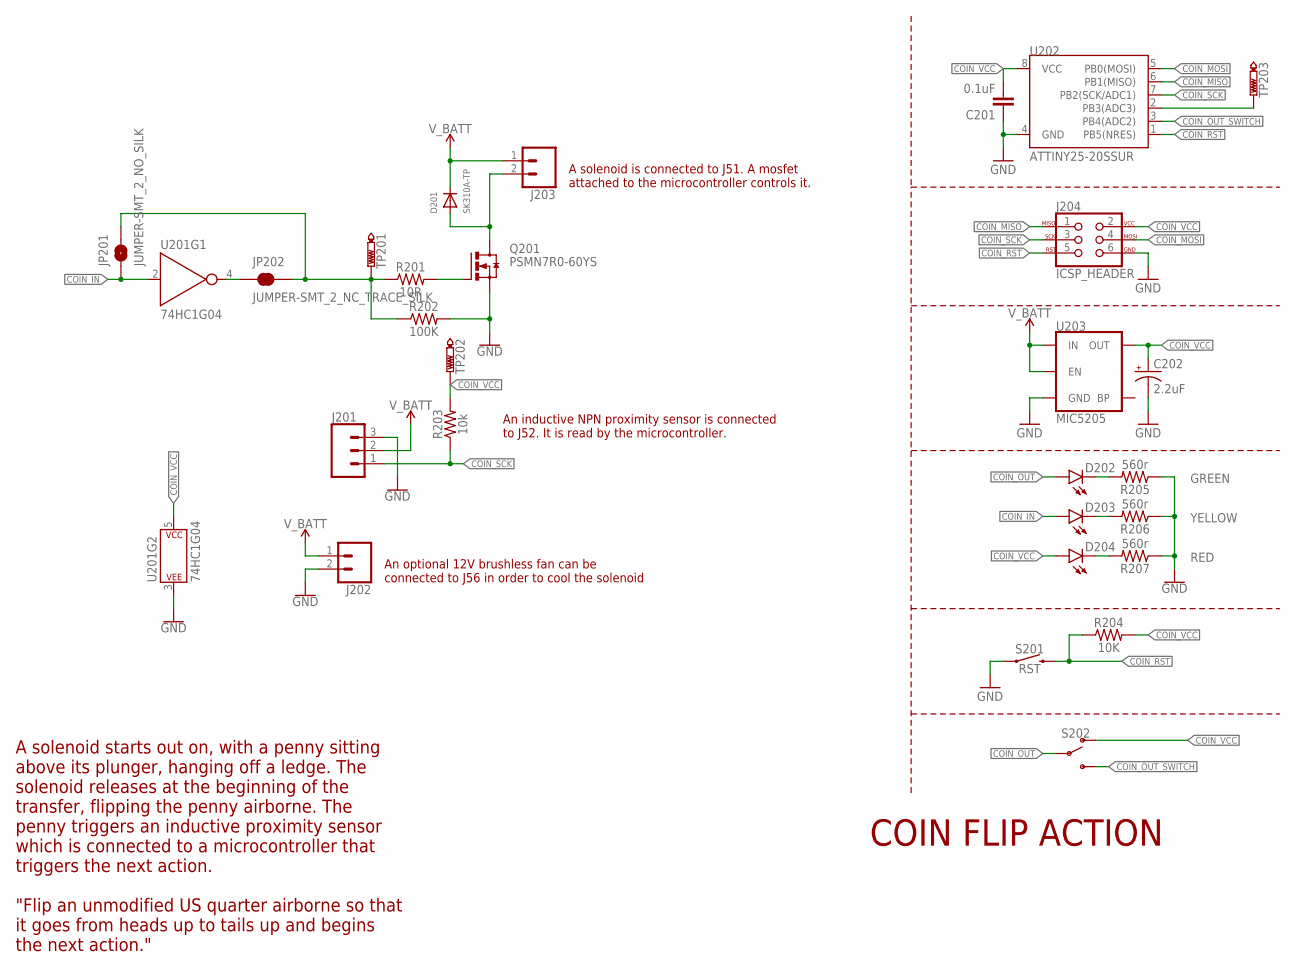
[picture p54: schematic WMHS Team A Mission Possible Electrical.sch, sheet 2, Coin Flip]

Parts:
C201: 0.1uF; 0603
C202: 2.2uF; EIA3216
D201: SK310A-TP; SMADIODE
D202: GREEN; LED-0603
D203: YELLOW; LED-0603
D204: RED; LED-0603
J201: CONN_03LOCK; 1X03_LOCK
J202: CONN_02LOCK; 1X02_LOCK
J203: CONN_023.5MM_LOCK; SCREWTERMINAL-3.5MM-2_LOCK
J204: ICSP_HEADER; 2X3
JP201: JUMPER-SMT_2_NO_SILK; SMT-JUMPER_2_NO_SILK
JP202: JUMPER-SMT_2_NC_TRACE_SILK; SMT-JUMPER_2_NC_TRACE_SILK
Q201: PSMN7R0-60YS; SOT669
R201: 10R; 0603
R202: 100K; 0603
R203: 10k; 0603
R204: 10K; 0603
R205, R206, R207: 560r; 0603
S201: RST; TACTILE_SWITCH_SMD_5.2MM
S202: SWITCH-SPDT-SMD-AYZ0202; SWITCH_DPDT_SMD_AYZ0202
TP201, TP202, TP203: PTR1TP20R; TP20R
U201: 74HC1G04; SOT353
U202: ATTINY25-20SSUR; SOIC8
U203: MIC5205; SOT23-5

Connections:
COIN_IN: D203.A, JP201.1, U201.2 (A); also elsewhere on the board
COIN_MISO: J204.1, U202.6 (PB1(MISO))
COIN_MOSI: J204.4, U202.5 (PB0(MOSI))
COIN_OUT: D202.A, S202.2; also elsewhere on the board
COIN_OUT_SWITCH: S202.3 (S), U202.3 (PB4(ADC2))
COIN_RST: J204.5, R204.1, S201.3 (2), S201.4 (2), U202.1 (PB5(NRES))
COIN_SCK: J201.1, J204.3, R203.1, U202.7 (PB2(SCK/ADC1))
COIN_VCC: C201.2, C202.+, D204.A, J204.2, R203.2, R204.2, S202.1 (O), TP202.TP, U201.5 (P$V+), U202.8 (VCC), U203.5 (OUT)
GND: C201.1, C202.-, J201.3, J202.2, J204.6, Q201.1 (S), Q201.2 (S), Q201.3 (S), R202.2, R205.1, R206.1, R207.1, S201.1, S201.2 (1), U201.3 (P$V-), U202.4 (GND), U203.2 (GND); also elsewhere on the board
unnamed: TP203.TP, U202.2 (PB3(ADC3))
unnamed: JP201.2, JP202.2, R201.1, R202.1, TP201.TP
unnamed: JP202.1, U201.4 (Y)
unnamed: Q201.4 (G), R201.2
unnamed: D201.A, J203.2, Q201.MB (D)
unnamed: D204.C, R207.2
unnamed: D203.C, R206.2
unnamed: D202.C, R205.2
V_BATT: D201.C, J201.2, J202.1, J203.1, U203.1 (IN), U203.3 (EN); also elsewhere on the board

Notes on the sheet:
COIN FLIP ACTION
"Flip an unmodified US quarter airborne so that it goes from heads up to tails up and begins the next action."
A solenoid is connected to J51. A mosfet attached to the microcontroller controls it.
An inductive NPN proximity sensor is connected to J52. It is read by the microcontroller.
An optional 12V brushless fan can be connected to J56 in order to cool the solenoid
A solenoid starts out on, with a penny sitting above its plunger, hanging off a ledge. The solenoid releases at the beginning of the transfer, flipping the penny airborne. The penny triggers an inductive proximity sensor which is connected to a microcontroller that triggers the next action.

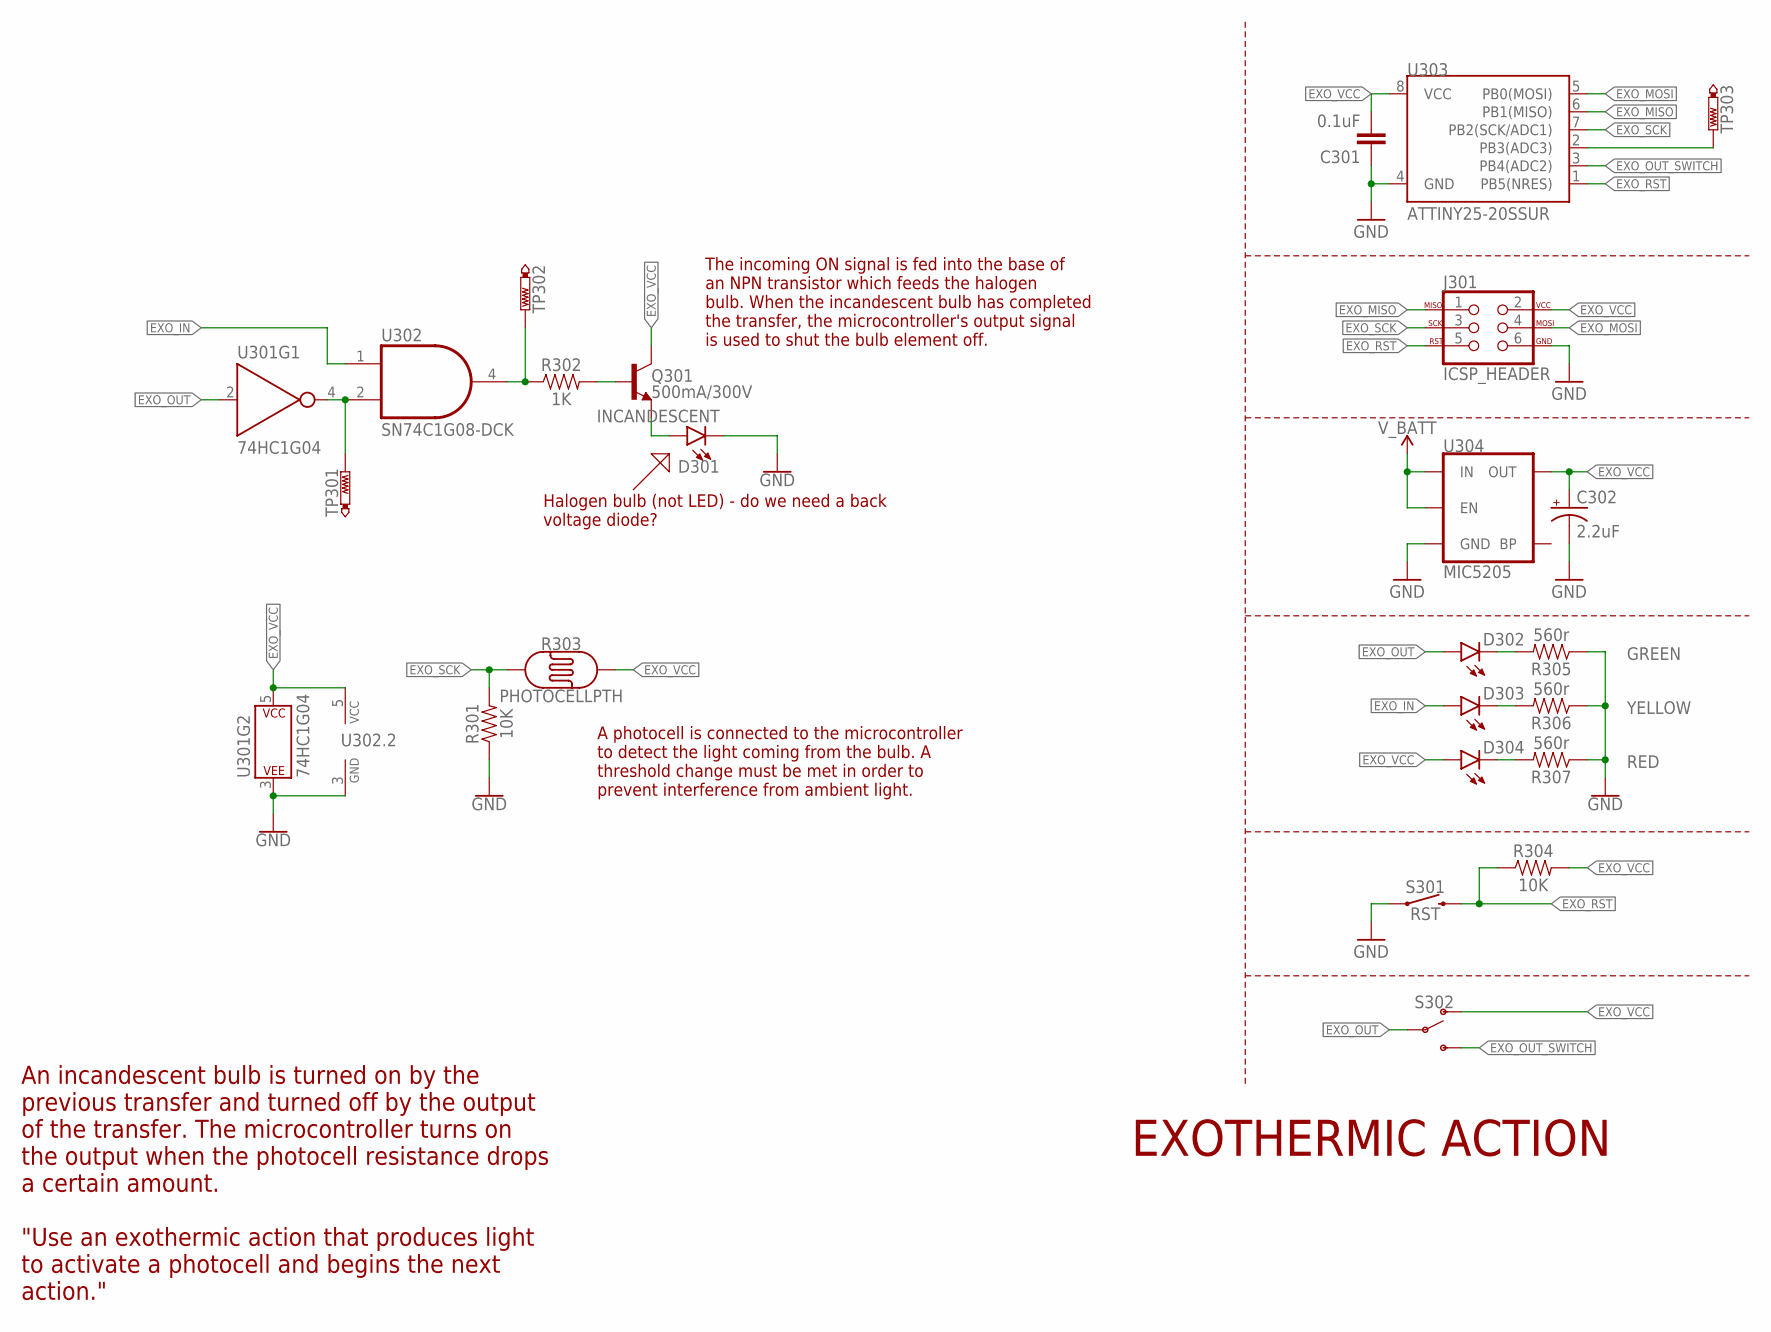
[picture p55: schematic WMHS Team A Mission Possible Electrical.sch, sheet 3, Exothermic]

Parts:
C301: 0.1uF; 0603
C302: 2.2uF; EIA3216
D301: INCANDESCENT; LED_3MM
D302: GREEN; LED-0603
D303: YELLOW; LED-0603
D304: RED; LED-0603
J301: ICSP_HEADER; 2X3
Q301: 500mA/300V; SOT23-3
R301, R304: 10K; 0603
R302: 1K; 0603
R303: PHOTOCELLPTH; PHOTOCELL
R305, R306, R307: 560r; 0603
S301: RST; TACTILE_SWITCH_SMD_5.2MM
S302: SWITCH-SPDT-SMD-AYZ0202; SWITCH_DPDT_SMD_AYZ0202
TP301, TP302, TP303: PTR1TP20R; TP20R
U301: 74HC1G04; SOT353
U302: SN74C1G08-DCK; SC-70-5
U303: ATTINY25-20SSUR; SOIC8
U304: MIC5205; SOT23-5

Connections:
EXO_IN: D303.A, U302.1 (A); also elsewhere on the board
EXO_MISO: J301.1, U303.6 (PB1(MISO))
EXO_MOSI: J301.4, U303.5 (PB0(MOSI))
EXO_OUT: D302.A, S302.2, U301.2 (A); also elsewhere on the board
EXO_OUT_SWITCH: S302.3 (S), U303.3 (PB4(ADC2))
EXO_RST: J301.5, R304.1, S301.3 (2), S301.4 (2), U303.1 (PB5(NRES))
EXO_SCK: J301.3, R301.2, R303.1, U303.7 (PB2(SCK/ADC1))
EXO_VCC: C301.2, C302.+, D304.A, J301.2, Q301.3 (C), R303.2, R304.2, S302.1 (O), U301.5 (P$V+), U302.5 (VCC), U303.8 (VCC), U304.5 (OUT)
GND: C301.1, C302.-, D301.K (C), J301.6, R301.1, R305.1, R306.1, R307.1, S301.1, S301.2 (1), U301.3 (P$V-), U302.3 (GND), U303.4 (GND), U304.2 (GND); also elsewhere on the board
unnamed: R302.1, TP302.TP, U302.4 (Y)
unnamed: TP301.TP, U301.4 (Y), U302.2 (B)
unnamed: TP303.TP, U303.2 (PB3(ADC3))
unnamed: Q301.1 (B), R302.2
unnamed: D301.A, Q301.2 (E)
unnamed: D304.C, R307.2
unnamed: D303.C, R306.2
unnamed: D302.C, R305.2
V_BATT: U304.1 (IN), U304.3 (EN); also elsewhere on the board

Notes on the sheet:
EXOTHERMIC ACTION
"Use an exothermic action that produces light to activate a photocell and begins the next action."
Halogen bulb (not LED) - do we need a back voltage diode?
The incoming ON signal is fed into the base of an NPN transistor which feeds the halogen bulb. When the incandescent bulb has completed the transfer, the microcontroller's output signal is used to shut the bulb element off.
A photocell is connected to the microcontroller to detect the light coming from the bulb. A threshold change must be met in order to prevent interference from ambient light.
An incandescent bulb is turned on by the previous transfer and turned off by the output of the transfer. The microcontroller turns on the output when the photocell resistance drops a certain amount.

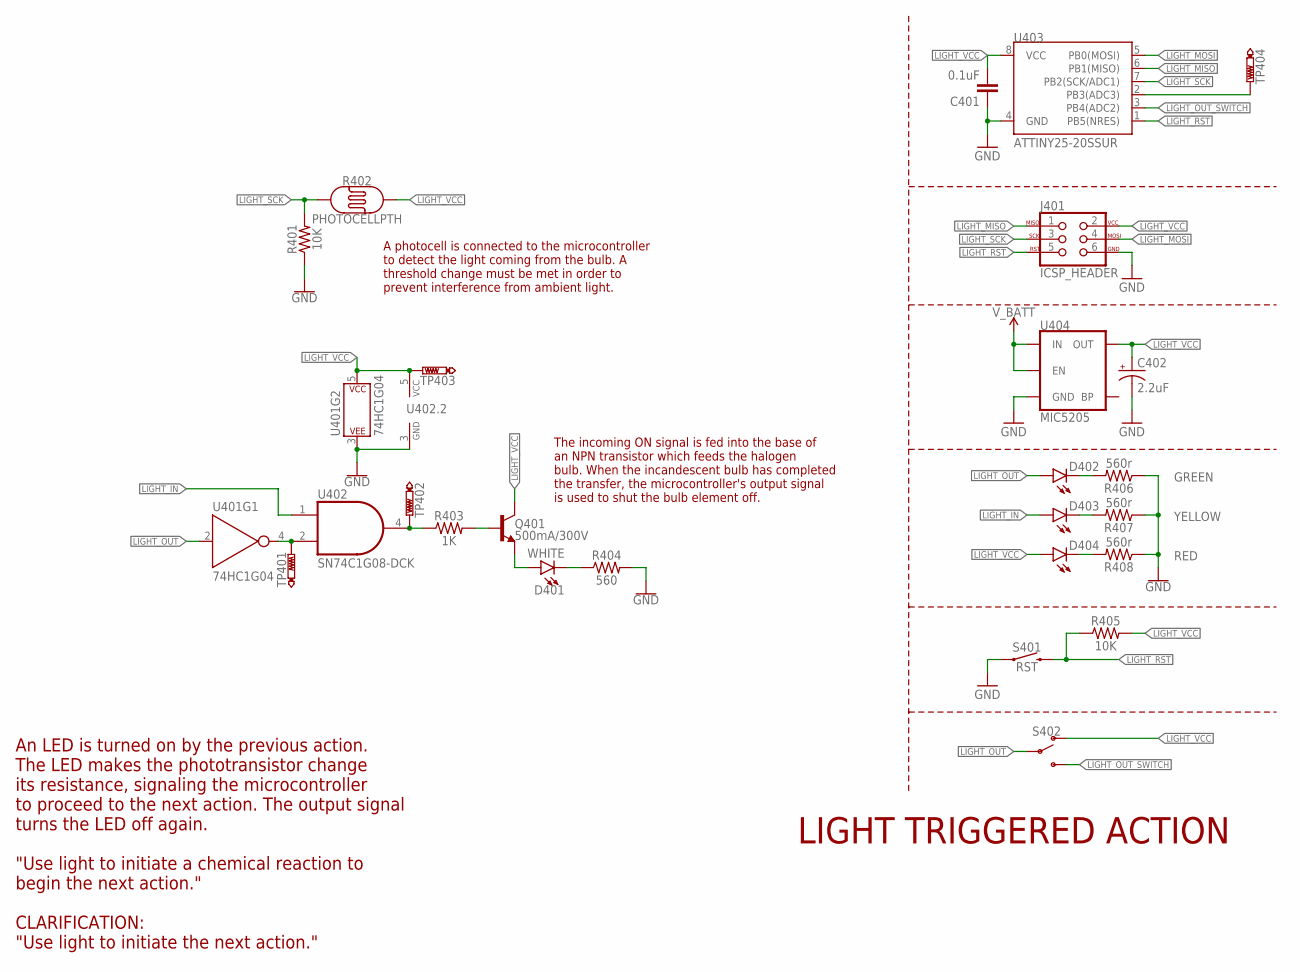
[picture p56: schematic WMHS Team A Mission Possible Electrical.sch, sheet 4, Light Triggered]

Parts:
C401: 0.1uF; 0603
C402: 2.2uF; EIA3216
D401: WHITE; LED_3MM
D402: GREEN; LED-0603
D403: YELLOW; LED-0603
D404: RED; LED-0603
J401: ICSP_HEADER; 2X3
Q401: 500mA/300V; SOT23-3
R401, R405: 10K; 0603
R402: PHOTOCELLPTH; PHOTOCELL
R403: 1K; 0603
R404: 560; 0603
R406, R407, R408: 560r; 0603
S401: RST; TACTILE_SWITCH_SMD_5.2MM
S402: SWITCH-SPDT-SMD-AYZ0202; SWITCH_DPDT_SMD_AYZ0202
TP401, TP402, TP403, TP404: PTR1TP20R; TP20R
U401: 74HC1G04; SOT353
U402: SN74C1G08-DCK; SC-70-5
U403: ATTINY25-20SSUR; SOIC8
U404: MIC5205; SOT23-5

Connections:
GND: C401.1, C402.-, J401.6, R401.1, R404.2, R406.1, R407.1, R408.1, S401.1, S401.2 (1), U401.3 (P$V-), U402.3 (GND), U403.4 (GND), U404.2 (GND); also elsewhere on the board
LIGHT_IN: D403.A, U402.1 (A); also elsewhere on the board
LIGHT_MISO: J401.1, U403.6 (PB1(MISO))
LIGHT_MOSI: J401.4, U403.5 (PB0(MOSI))
LIGHT_OUT: D402.A, S402.2, U401.2 (A); also elsewhere on the board
LIGHT_OUT_SWITCH: S402.3 (S), U403.3 (PB4(ADC2))
LIGHT_RST: J401.5, R405.1, S401.3 (2), S401.4 (2), U403.1 (PB5(NRES))
LIGHT_SCK: J401.3, R401.2, R402.1, U403.7 (PB2(SCK/ADC1))
LIGHT_VCC: C401.2, C402.+, D404.A, J401.2, Q401.3 (C), R402.2, R405.2, S402.1 (O), TP403.TP, U401.5 (P$V+), U402.5 (VCC), U403.8 (VCC), U404.5 (OUT)
unnamed: Q401.1 (B), R403.2
unnamed: D401.A, Q401.2 (E)
unnamed: R403.1, TP402.TP, U402.4 (Y)
unnamed: TP401.TP, U401.4 (Y), U402.2 (B)
unnamed: TP404.TP, U403.2 (PB3(ADC3))
unnamed: D401.K (C), R404.1
unnamed: D404.C, R408.2
unnamed: D403.C, R407.2
unnamed: D402.C, R406.2
V_BATT: U404.1 (IN), U404.3 (EN); also elsewhere on the board

Notes on the sheet:
LIGHT TRIGGERED ACTION
"Use light to initiate a chemical reaction to begin the next action." CLARIFICATION: "Use light to initiate the next action."
An LED is turned on by the previous action. The LED makes the phototransistor change its resistance, signaling the microcontroller to proceed to the next action. The output signal turns the LED off again.
A photocell is connected to the microcontroller to detect the light coming from the bulb. A threshold change must be met in order to prevent interference from ambient light.
The incoming ON signal is fed into the base of an NPN transistor which feeds the halogen bulb. When the incandescent bulb has completed the transfer, the microcontroller's output signal is used to shut the bulb element off.

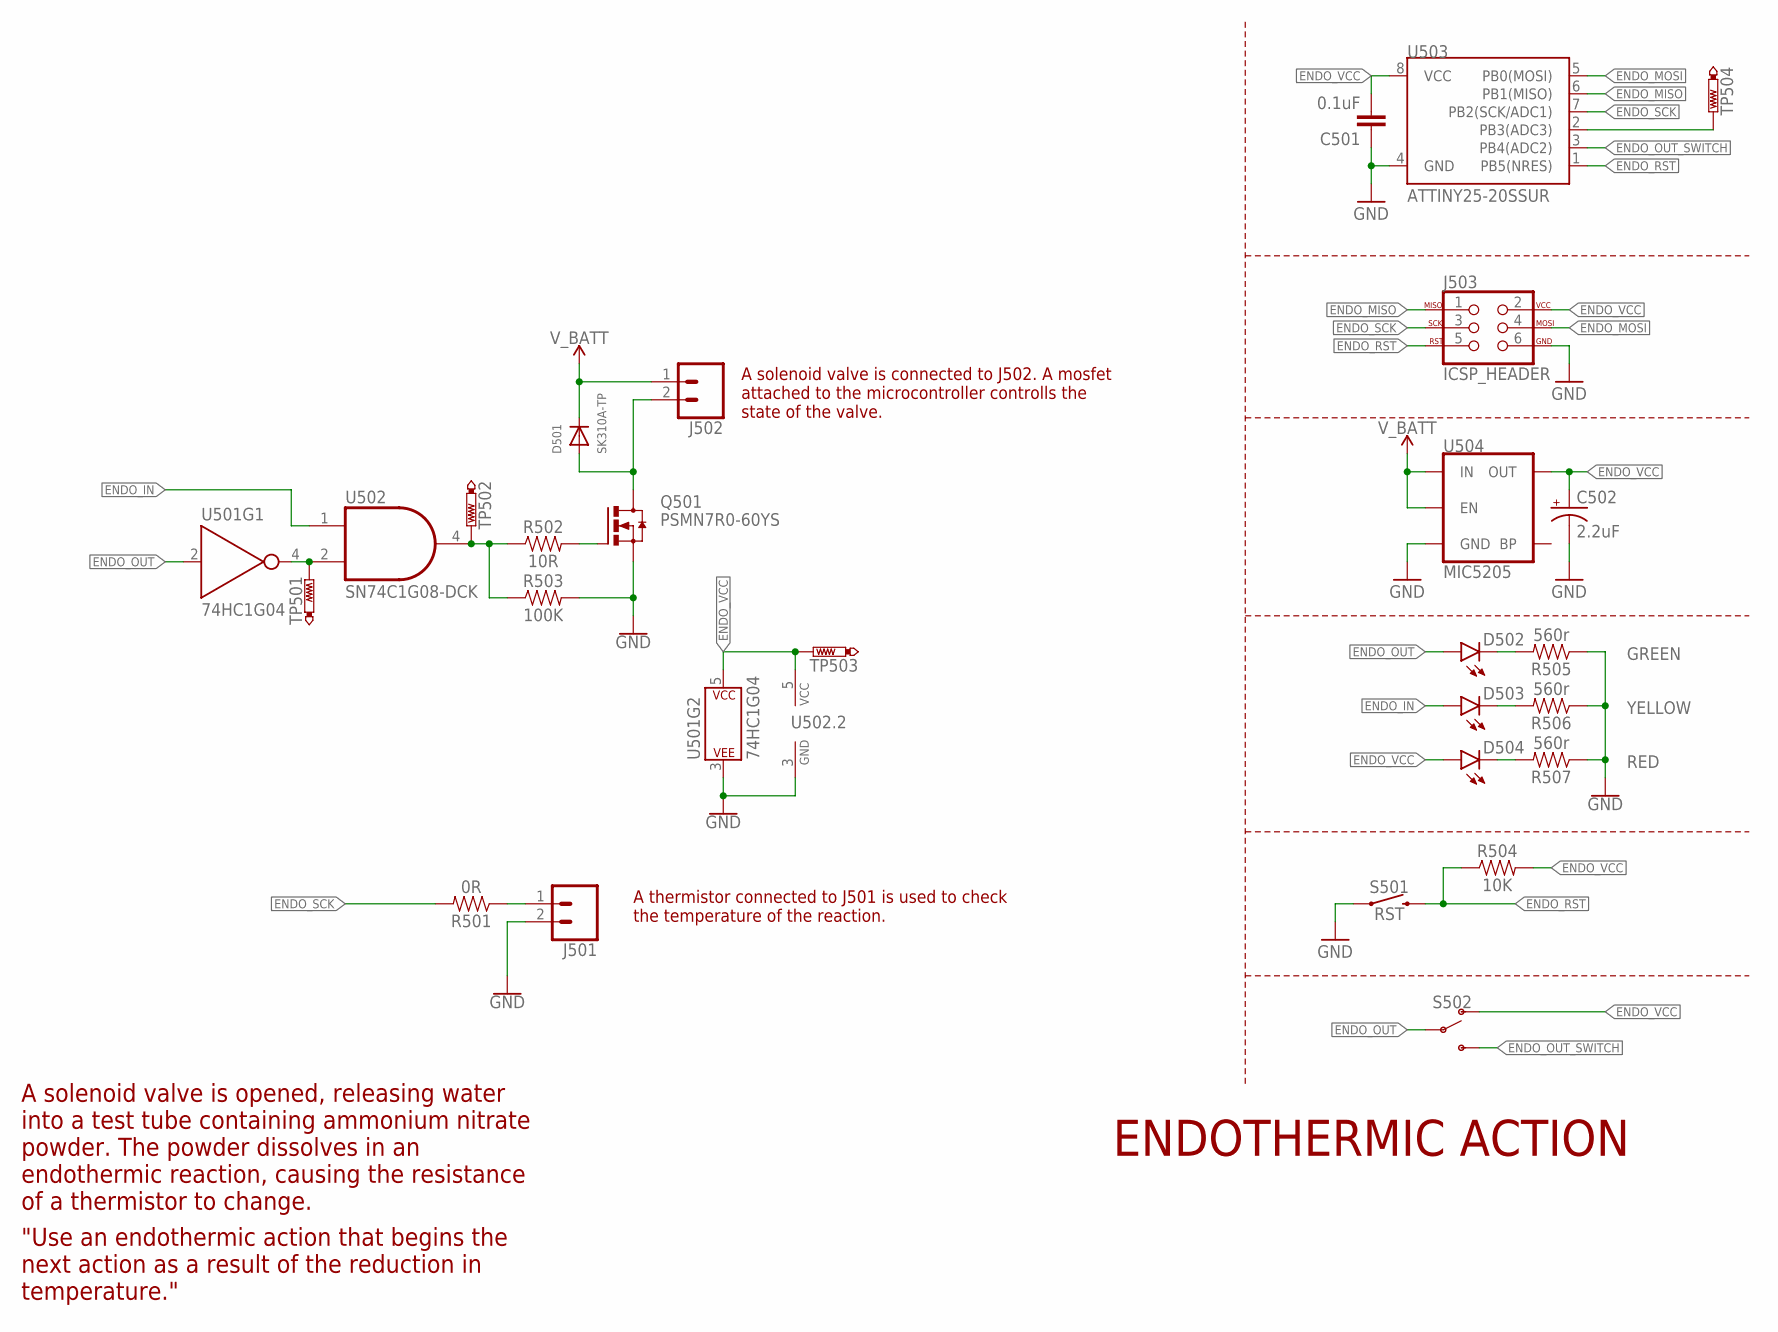
[picture p57: schematic WMHS Team A Mission Possible Electrical.sch, sheet 5, Endothermic]

Parts:
C501: 0.1uF; 0603
C502: 2.2uF; EIA3216
D501: SK310A-TP; SMADIODE
D502: GREEN; LED-0603
D503: YELLOW; LED-0603
D504: RED; LED-0603
J501: CONN_02LOCK; 1X02_LOCK
J502: CONN_023.5MM_LOCK; SCREWTERMINAL-3.5MM-2_LOCK
J503: ICSP_HEADER; 2X3
Q501: PSMN7R0-60YS; SOT669
R501: 0R; 0603
R502: 10R; 0603
R503: 100K; 0603
R504: 10K; 0603
R505, R506, R507: 560r; 0603
S501: RST; TACTILE_SWITCH_SMD_5.2MM
S502: SWITCH-SPDT-SMD-AYZ0202; SWITCH_DPDT_SMD_AYZ0202
TP501, TP502, TP503, TP504: PTR1TP20R; TP20R
U501: 74HC1G04; SOT353
U502: SN74C1G08-DCK; SC-70-5
U503: ATTINY25-20SSUR; SOIC8
U504: MIC5205; SOT23-5

Connections:
ENDO_IN: D503.A, U502.1 (A); also elsewhere on the board
ENDO_MISO: J503.1, U503.6 (PB1(MISO))
ENDO_MOSI: J503.4, U503.5 (PB0(MOSI))
ENDO_OUT: D502.A, S502.2, U501.2 (A); also elsewhere on the board
ENDO_OUT_SWITCH: S502.3 (S), U503.3 (PB4(ADC2))
ENDO_RST: J503.5, R504.1, S501.3 (2), S501.4 (2), U503.1 (PB5(NRES))
ENDO_SCK: J503.3, R501.2, U503.7 (PB2(SCK/ADC1))
ENDO_VCC: C501.2, C502.+, D504.A, J503.2, R504.2, S502.1 (O), TP503.TP, U501.5 (P$V+), U502.5 (VCC), U503.8 (VCC), U504.5 (OUT)
GND: C501.1, C502.-, J501.2, J503.6, Q501.1 (S), Q501.2 (S), Q501.3 (S), R503.2, R505.1, R506.1, R507.1, S501.1, S501.2 (1), U501.3 (P$V-), U502.3 (GND), U503.4 (GND), U504.2 (GND); also elsewhere on the board
unnamed: TP501.TP, U501.4 (Y), U502.2 (B)
unnamed: TP504.TP, U503.2 (PB3(ADC3))
unnamed: J501.1, R501.1
unnamed: Q501.4 (G), R502.2
unnamed: D501.A, J502.2, Q501.MB (D)
unnamed: R502.1, R503.1, TP502.TP, U502.4 (Y)
unnamed: D504.C, R507.2
unnamed: D503.C, R506.2
unnamed: D502.C, R505.2
V_BATT: D501.C, J502.1, U504.1 (IN), U504.3 (EN); also elsewhere on the board

Notes on the sheet:
ENDOTHERMIC ACTION
"Use an endothermic action that begins the next action as a result of the reduction in temperature."
A thermistor connected to J501 is used to check the temperature of the reaction.
A solenoid valve is connected to J502. A mosfet attached to the microcontroller controlls the state of the valve.
A solenoid valve is opened, releasing water into a test tube containing ammonium nitrate powder. The powder dissolves in an endothermic reaction, causing the resistance of a thermistor to change.

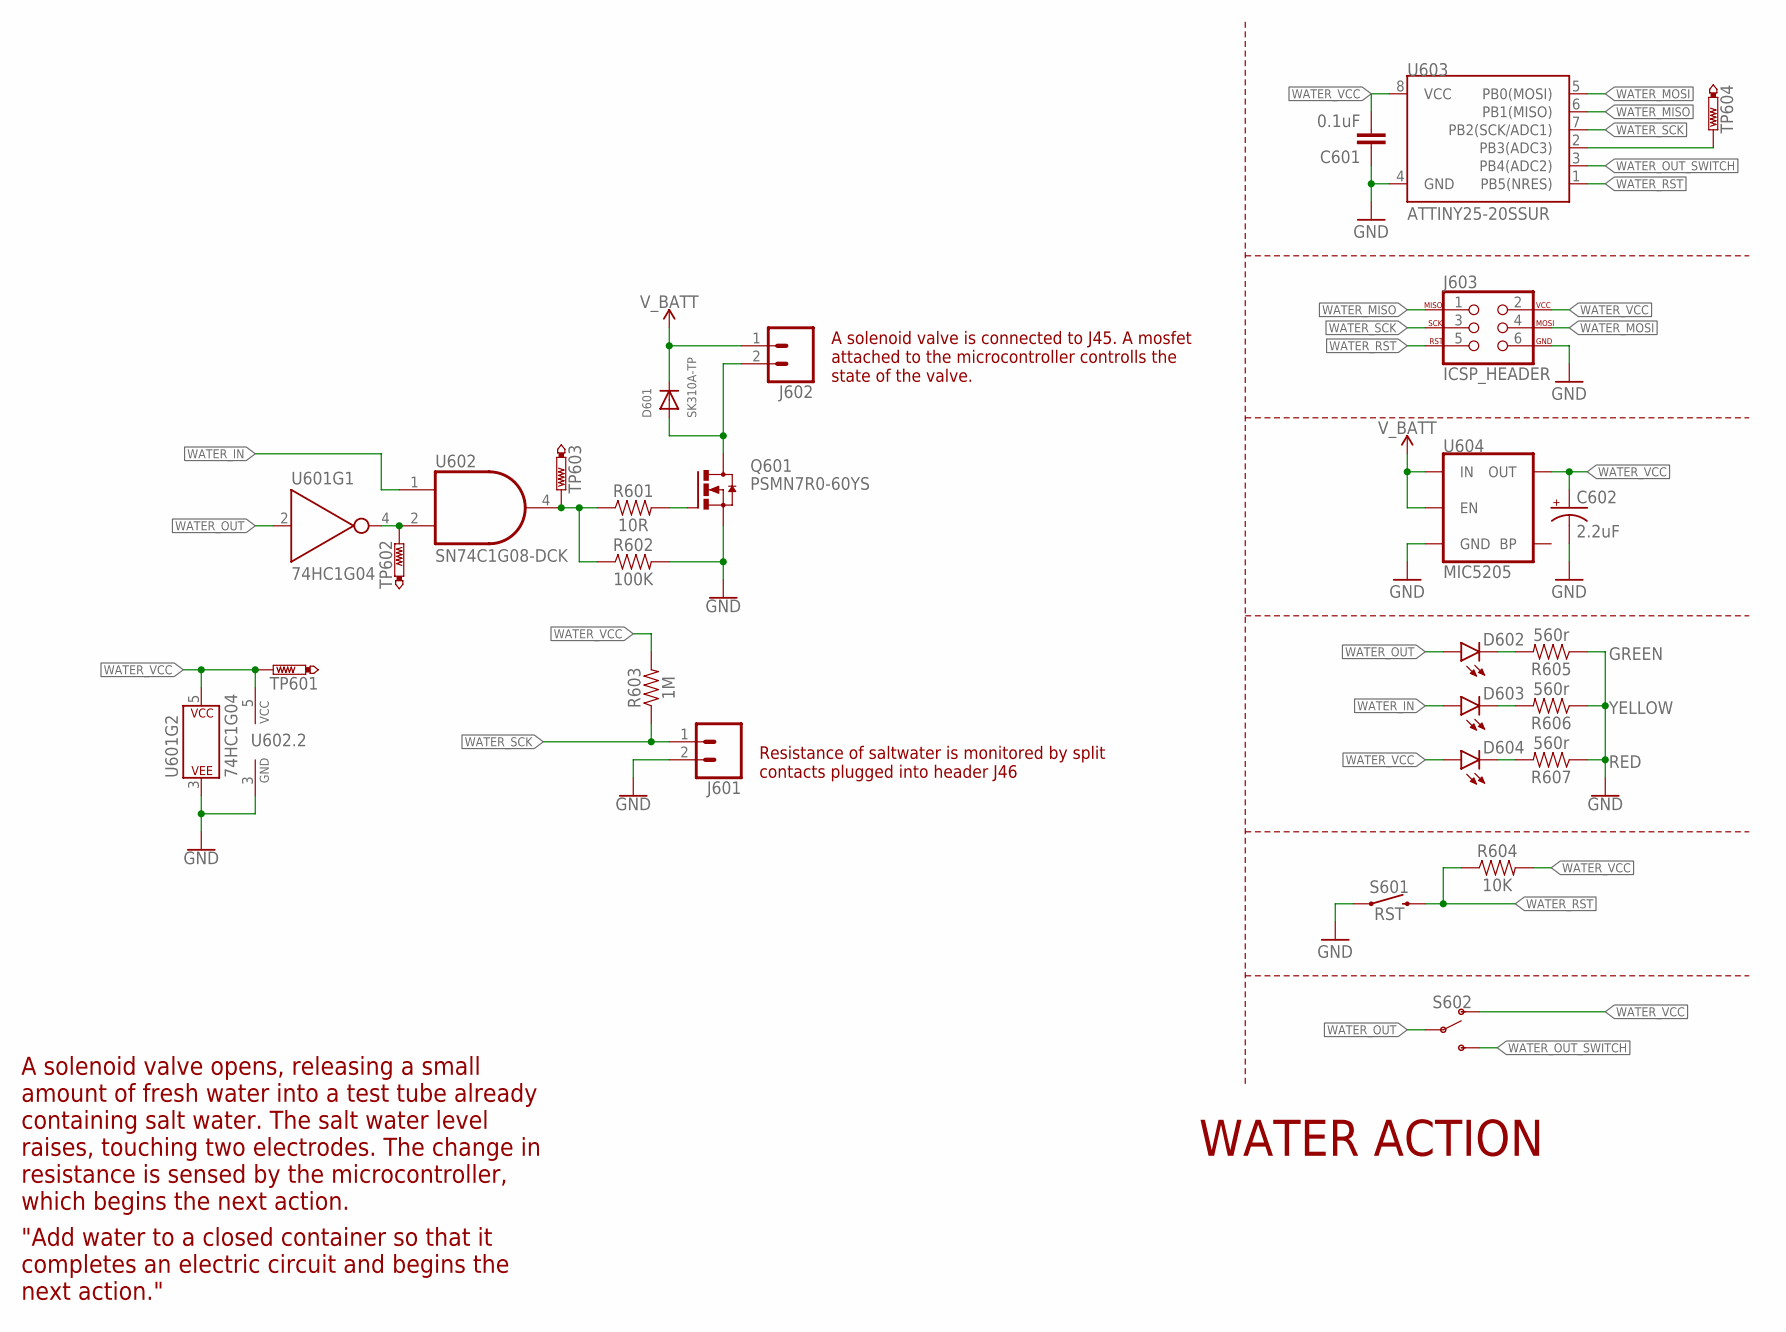
[picture p58: schematic WMHS Team A Mission Possible Electrical.sch, sheet 6, Water]

Parts:
C601: 0.1uF; 0603
C602: 2.2uF; EIA3216
D601: SK310A-TP; SMADIODE
D602: GREEN; LED-0603
D603: YELLOW; LED-0603
D604: RED; LED-0603
J601: CONN_02LOCK; 1X02_LOCK
J602: CONN_023.5MM_LOCK; SCREWTERMINAL-3.5MM-2_LOCK
J603: ICSP_HEADER; 2X3
Q601: PSMN7R0-60YS; SOT669
R601: 10R; 0603
R602: 100K; 0603
R603: 1M; 0603
R604: 10K; 0603
R605, R606, R607: 560r; 0603
S601: RST; TACTILE_SWITCH_SMD_5.2MM
S602: SWITCH-SPDT-SMD-AYZ0202; SWITCH_DPDT_SMD_AYZ0202
TP601, TP602, TP603, TP604: PTR1TP20R; TP20R
U601: 74HC1G04; SOT353
U602: SN74C1G08-DCK; SC-70-5
U603: ATTINY25-20SSUR; SOIC8
U604: MIC5205; SOT23-5

Connections:
GND: C601.1, C602.-, J601.2, J603.6, Q601.1 (S), Q601.2 (S), Q601.3 (S), R602.2, R605.1, R606.1, R607.1, S601.1, S601.2 (1), U601.3 (P$V-), U602.3 (GND), U603.4 (GND), U604.2 (GND); also elsewhere on the board
unnamed: TP602.TP, U601.4 (Y), U602.2 (B)
unnamed: TP604.TP, U603.2 (PB3(ADC3))
unnamed: D604.C, R607.2
unnamed: D603.C, R606.2
unnamed: D602.C, R605.2
unnamed: R601.1, R602.1, TP603.TP, U602.4 (Y)
unnamed: Q601.4 (G), R601.2
unnamed: D601.A, J602.2, Q601.MB (D)
V_BATT: D601.C, J602.1, U604.1 (IN), U604.3 (EN); also elsewhere on the board
WATER_IN: D603.A, U602.1 (A); also elsewhere on the board
WATER_MISO: J603.1, U603.6 (PB1(MISO))
WATER_MOSI: J603.4, U603.5 (PB0(MOSI))
WATER_OUT: D602.A, S602.2, U601.2 (A); also elsewhere on the board
WATER_OUT_SWITCH: S602.3 (S), U603.3 (PB4(ADC2))
WATER_RST: J603.5, R604.1, S601.3 (2), S601.4 (2), U603.1 (PB5(NRES))
WATER_SCK: J601.1, J603.3, R603.1, U603.7 (PB2(SCK/ADC1))
WATER_VCC: C601.2, C602.+, D604.A, J603.2, R603.2, R604.2, S602.1 (O), TP601.TP, U601.5 (P$V+), U602.5 (VCC), U603.8 (VCC), U604.5 (OUT)

Notes on the sheet:
WATER ACTION
"Add water to a closed container so that it completes an electric circuit and begins the next action."
A solenoid valve is connected to J45. A mosfet attached to the microcontroller controlls the state of the valve.
Resistance of saltwater is monitored by split contacts plugged into header J46
A solenoid valve opens, releasing a small amount of fresh water into a test tube already containing salt water. The salt water level raises, touching two electrodes. The change in resistance is sensed by the microcontroller, which begins the next action.

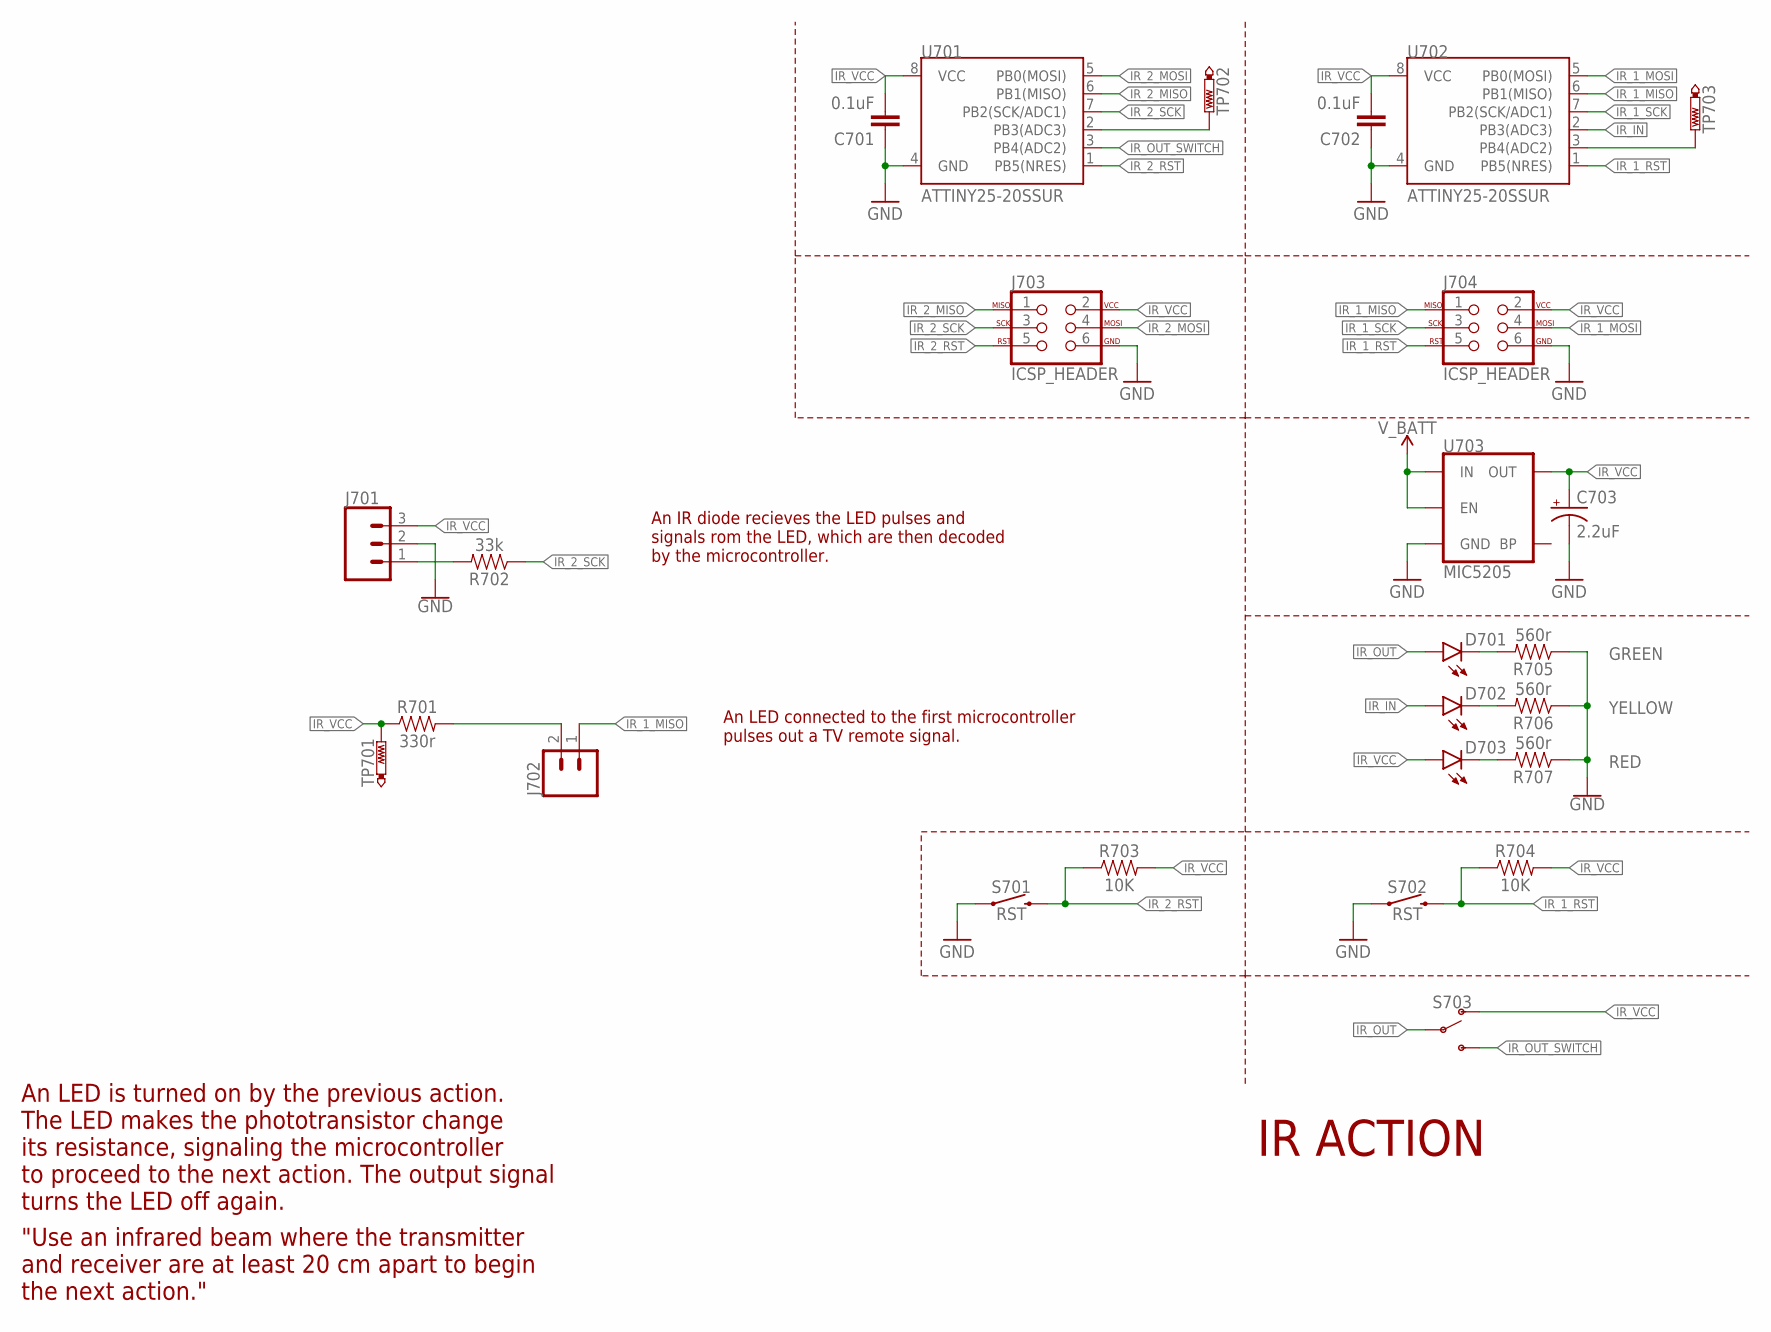
[picture p59: schematic WMHS Team A Mission Possible Electrical.sch, sheet 7, IR]

Parts:
C701, C702: 0.1uF; 0603
C703: 2.2uF; EIA3216
D701: GREEN; LED-0603
D702: YELLOW; LED-0603
D703: RED; LED-0603
J701: CONN_03; 1X03
J702: CONN_02LOCK; 1X02_LOCK
J703, J704: ICSP_HEADER; 2X3
R701: 330r; 0603
R702: 33k; 0603
R703, R704: 10K; 0603
R705, R706, R707: 560r; 0603
S701, S702: RST; TACTILE_SWITCH_SMD_5.2MM
S703: SWITCH-SPDT-SMD-AYZ0202; SWITCH_DPDT_SMD_AYZ0202
TP701, TP702, TP703: PTR1TP20R; TP20R
U701, U702: ATTINY25-20SSUR; SOIC8
U703: MIC5205; SOT23-5

Connections:
GND: C701.1, C702.1, C703.-, J701.2, J703.6, J704.6, R705.1, R706.1, R707.1, S701.1, S701.2 (1), S702.1, S702.2 (1), U701.4 (GND), U702.4 (GND), U703.2 (GND); also elsewhere on the board
IR_1_MISO: J702.1, J704.1, U702.6 (PB1(MISO))
IR_1_MOSI: J704.4, U702.5 (PB0(MOSI))
IR_1_RST: J704.5, R704.1, S702.3 (2), S702.4 (2), U702.1 (PB5(NRES))
IR_1_SCK: J704.3, U702.7 (PB2(SCK/ADC1))
IR_2_MISO: J703.1, U701.6 (PB1(MISO))
IR_2_MOSI: J703.4, U701.5 (PB0(MOSI))
IR_2_RST: J703.5, R703.1, S701.3 (2), S701.4 (2), U701.1 (PB5(NRES))
IR_2_SCK: J703.3, R702.1, U701.7 (PB2(SCK/ADC1))
IR_IN: D702.A, U702.2 (PB3(ADC3)); also elsewhere on the board
IR_OUT: D701.A, S703.2; also elsewhere on the board
IR_OUT_SWITCH: S703.3 (S), U701.3 (PB4(ADC2))
IR_VCC: C701.2, C702.2, C703.+, D703.A, J701.3, J703.2, J704.2, R701.1, R703.2, R704.2, S703.1 (O), TP701.TP, U701.8 (VCC), U702.8 (VCC), U703.5 (OUT)
unnamed: TP702.TP, U701.2 (PB3(ADC3))
unnamed: TP703.TP, U702.3 (PB4(ADC2))
unnamed: D703.C, R707.2
unnamed: J702.2, R701.2
unnamed: J701.1, R702.2
unnamed: D702.C, R706.2
unnamed: D701.C, R705.2
V_BATT: U703.1 (IN), U703.3 (EN); also elsewhere on the board

Notes on the sheet:
IR ACTION
"Use an infrared beam where the transmitter and receiver are at least 20 cm apart to begin the next action."
An IR diode recieves the LED pulses and signals rom the LED, which are then decoded by the microcontroller.
An LED connected to the first microcontroller pulses out a TV remote signal.
An LED is turned on by the previous action. The LED makes the phototransistor change its resistance, signaling the microcontroller to proceed to the next action. The output signal turns the LED off again.
