davecutting/Ward-Melville-2018-Mission-Possible/Circuit Board/WMHS Team A Mission Possible Electrical.brd

## EAGLE design Circuit Board/WMHS Team A Mission Possible Electrical.brd (continued)

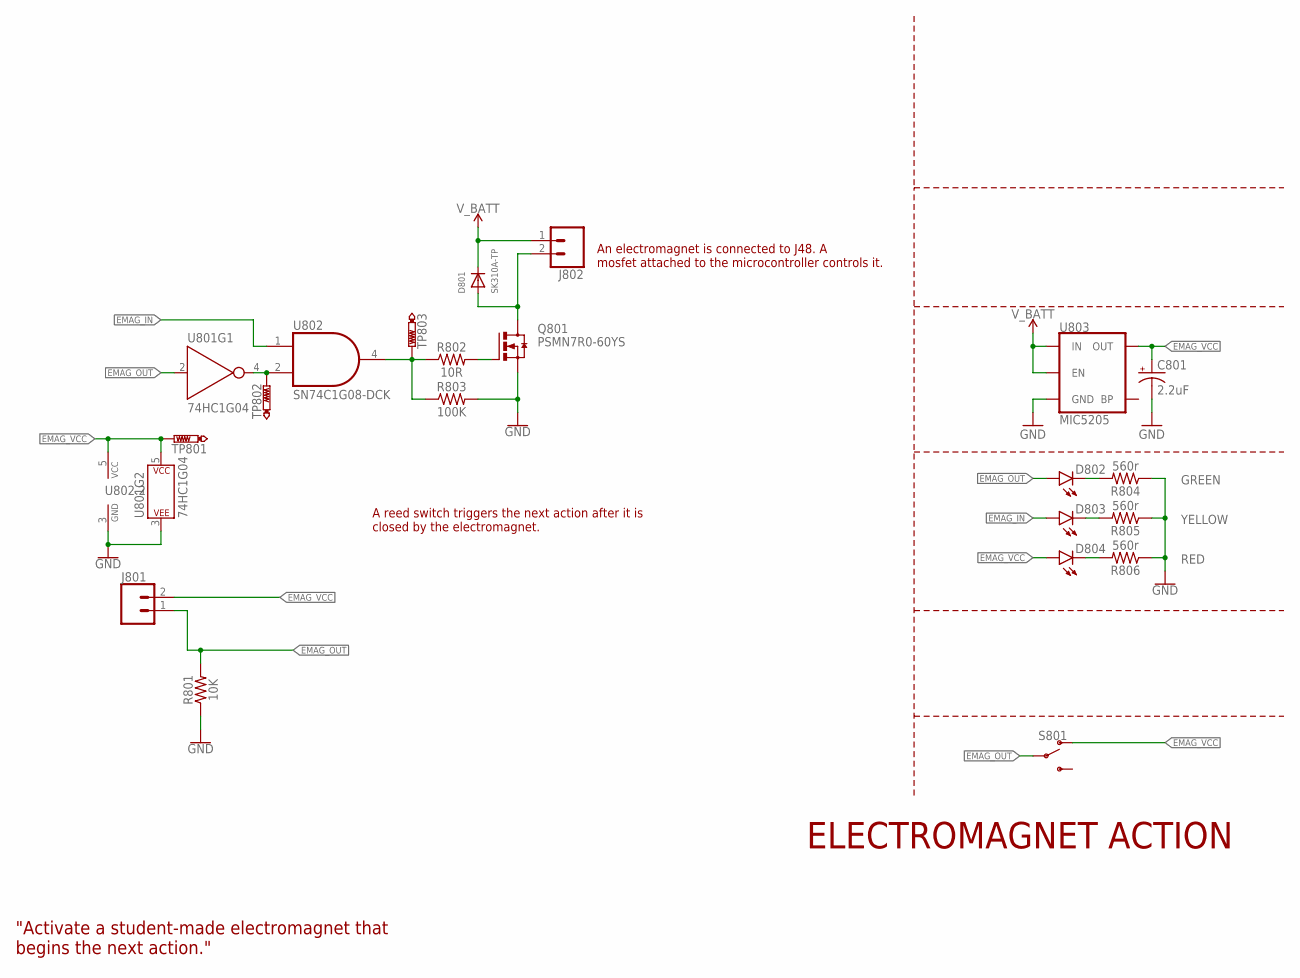
[picture p60: schematic WMHS Team A Mission Possible Electrical.sch, sheet 8, Electromagnet]

Parts:
C801: 2.2uF; EIA3216
D801: SK310A-TP; SMADIODE
D802: GREEN; LED-0603
D803: YELLOW; LED-0603
D804: RED; LED-0603
J801: CONN_02LOCK; 1X02_LOCK
J802: CONN_023.5MM_LOCK; SCREWTERMINAL-3.5MM-2_LOCK
Q801: PSMN7R0-60YS; SOT669
R801: 10K; 0603
R802: 10R; 0603
R803: 100K; 0603
R804, R805, R806: 560r; 0603
S801: SWITCH-SPDT-SMD-AYZ0202; SWITCH_DPDT_SMD_AYZ0202
TP801, TP802, TP803: PTR1TP20R; TP20R
U801: 74HC1G04; SOT353
U802: SN74C1G08-DCK; SC-70-5
U803: MIC5205; SOT23-5

Connections:
EMAG_IN: D803.A, U802.1 (A); also elsewhere on the board
EMAG_OUT: D802.A, J801.1, R801.2, S801.2, U801.2 (A); also elsewhere on the board
EMAG_VCC: C801.+, D804.A, J801.2, S801.1 (O), TP801.TP, U801.5 (P$V+), U802.5 (VCC), U803.5 (OUT)
GND: C801.-, Q801.1 (S), Q801.2 (S), Q801.3 (S), R801.1, R803.2, R804.1, R805.1, R806.1, U801.3 (P$V-), U802.3 (GND), U803.2 (GND); also elsewhere on the board
unnamed: TP802.TP, U801.4 (Y), U802.2 (B)
unnamed: R802.1, R803.1, TP803.TP, U802.4 (Y)
unnamed: Q801.4 (G), R802.2
unnamed: D801.A, J802.2, Q801.MB (D)
unnamed: D804.C, R806.2
unnamed: D803.C, R805.2
unnamed: D802.C, R804.2
V_BATT: D801.C, J802.1, U803.1 (IN), U803.3 (EN); also elsewhere on the board

Notes on the sheet:
ELECTROMAGNET ACTION
"Activate a student-made electromagnet that begins the next action."
An electromagnet is connected to J48. A mosfet attached to the microcontroller controls it.
A reed switch triggers the next action after it is closed by the electromagnet.

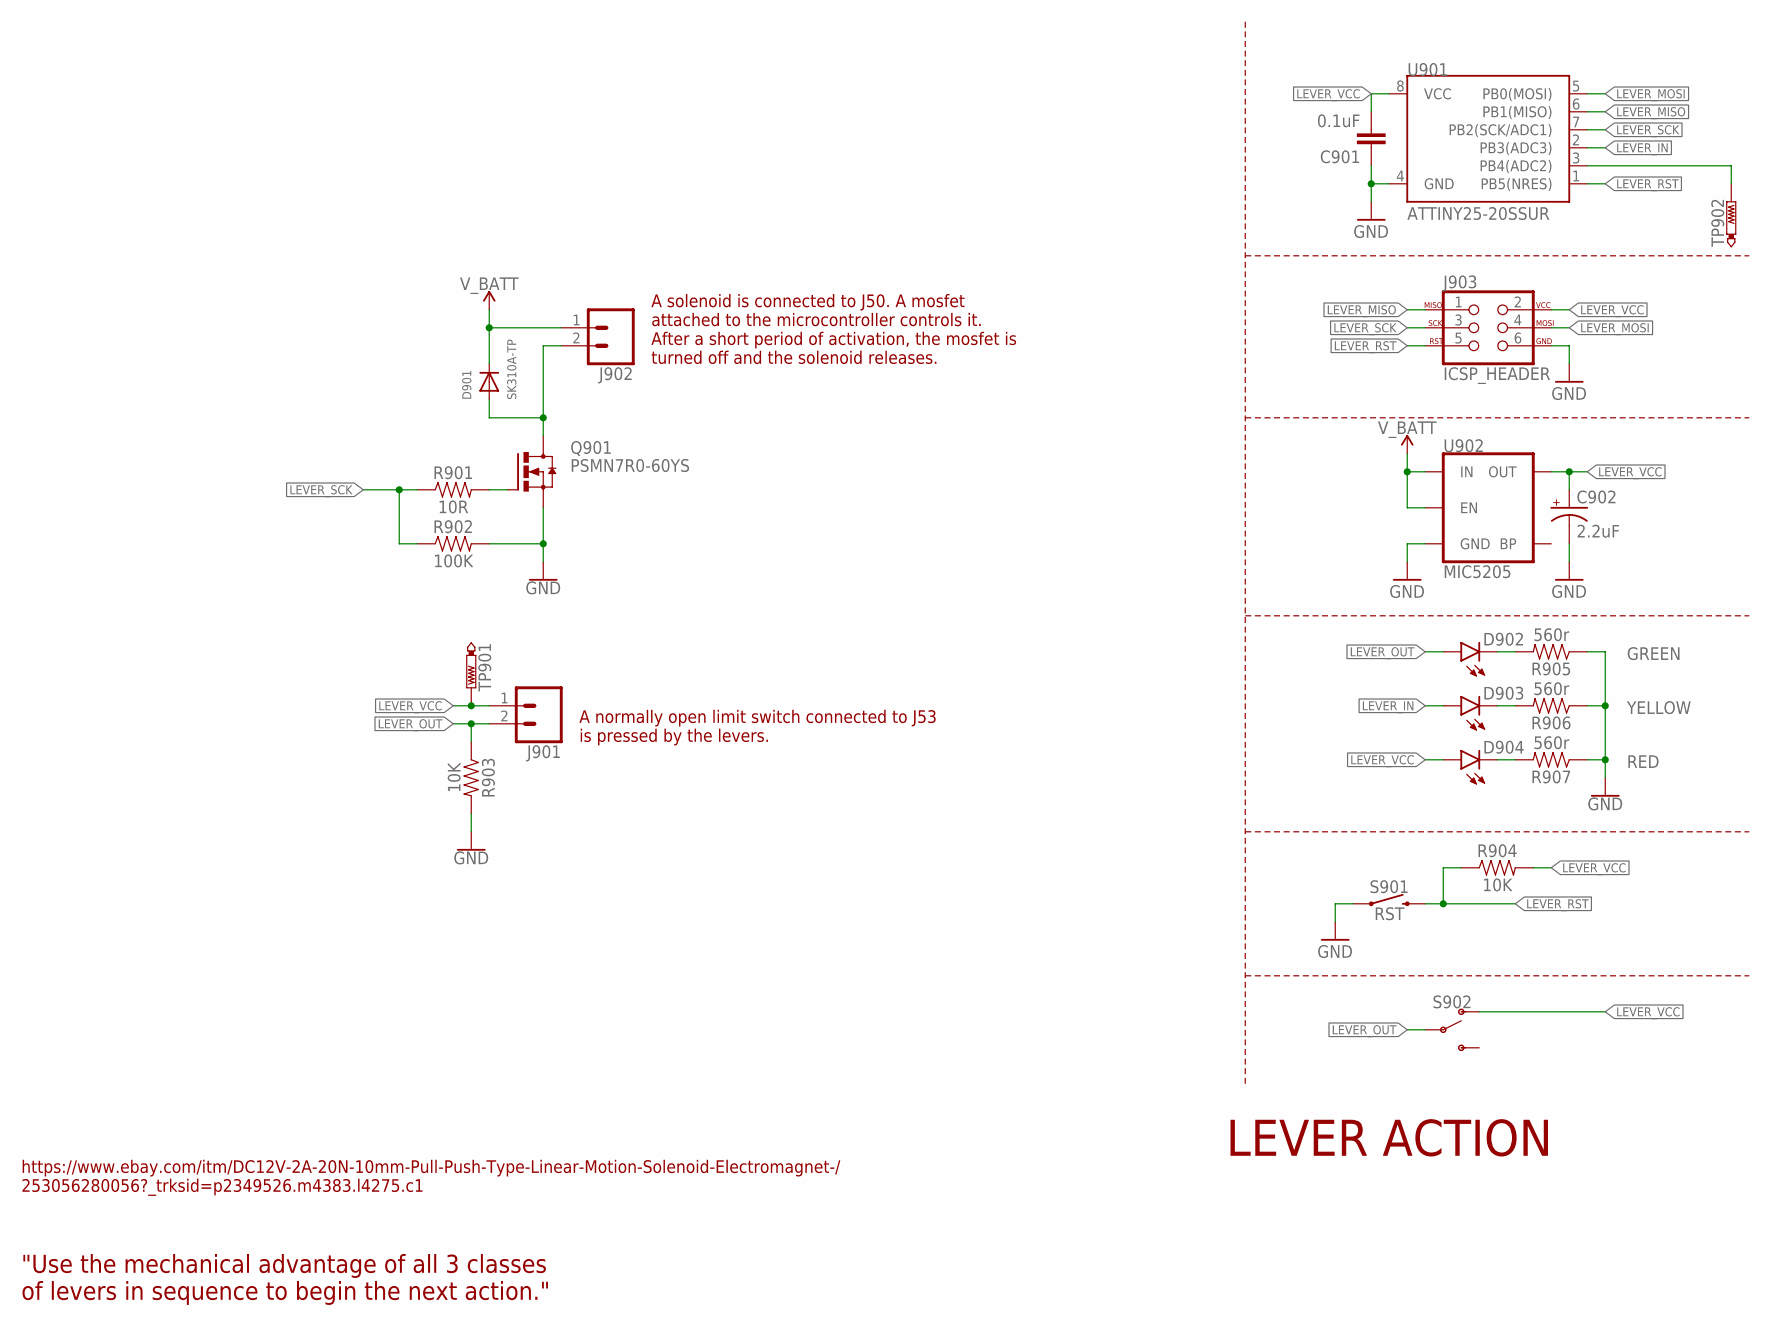
[picture p61: schematic WMHS Team A Mission Possible Electrical.sch, sheet 9, Levers]

Parts:
C901: 0.1uF; 0603
C902: 2.2uF; EIA3216
D901: SK310A-TP; SMADIODE
D902: GREEN; LED-0603
D903: YELLOW; LED-0603
D904: RED; LED-0603
J901: CONN_02LOCK; 1X02_LOCK
J902: CONN_023.5MM_LOCK; SCREWTERMINAL-3.5MM-2_LOCK
J903: ICSP_HEADER; 2X3
Q901: PSMN7R0-60YS; SOT669
R901: 10R; 0603
R902: 100K; 0603
R903, R904: 10K; 0603
R905, R906, R907: 560r; 0603
S901: RST; TACTILE_SWITCH_SMD_5.2MM
S902: SWITCH-SPDT-SMD-AYZ0202; SWITCH_DPDT_SMD_AYZ0202
TP901, TP902: PTR1TP20R; TP20R
U901: ATTINY25-20SSUR; SOIC8
U902: MIC5205; SOT23-5

Connections:
GND: C901.1, C902.-, J903.6, Q901.1 (S), Q901.2 (S), Q901.3 (S), R902.2, R903.2, R905.1, R906.1, R907.1, S901.1, S901.2 (1), U901.4 (GND), U902.2 (GND); also elsewhere on the board
LEVER_IN: D903.A, U901.2 (PB3(ADC3)); also elsewhere on the board
LEVER_MISO: J903.1, U901.6 (PB1(MISO))
LEVER_MOSI: J903.4, U901.5 (PB0(MOSI))
LEVER_OUT: D902.A, J901.2, R903.1, S902.2; also elsewhere on the board
LEVER_RST: J903.5, R904.1, S901.3 (2), S901.4 (2), U901.1 (PB5(NRES))
LEVER_SCK: J903.3, R901.1, R902.1, U901.7 (PB2(SCK/ADC1))
LEVER_VCC: C901.2, C902.+, D904.A, J901.1, J903.2, R904.2, S902.1 (O), TP901.TP, U901.8 (VCC), U902.5 (OUT)
unnamed: TP902.TP, U901.3 (PB4(ADC2))
unnamed: Q901.4 (G), R901.2
unnamed: D901.A, J902.2, Q901.MB (D)
unnamed: D904.C, R907.2
unnamed: D903.C, R906.2
unnamed: D902.C, R905.2
V_BATT: D901.C, J902.1, U902.1 (IN), U902.3 (EN); also elsewhere on the board

Notes on the sheet:
LEVER ACTION
"Use the mechanical advantage of all 3 classes of levers in sequence to begin the next action."
A solenoid is connected to J50. A mosfet attached to the microcontroller controls it. After a short period of activation, the mosfet is turned off and the solenoid releases.
A normally open limit switch connected to J53 is pressed by the levers.
https://www.ebay.com/itm/DC12V-2A-20N-10mm-Pull-Push-Type-Linear-Motion-Solenoid-Electromagnet-/ 253056280056?_trksid=p2349526.m4383.l4275.c1

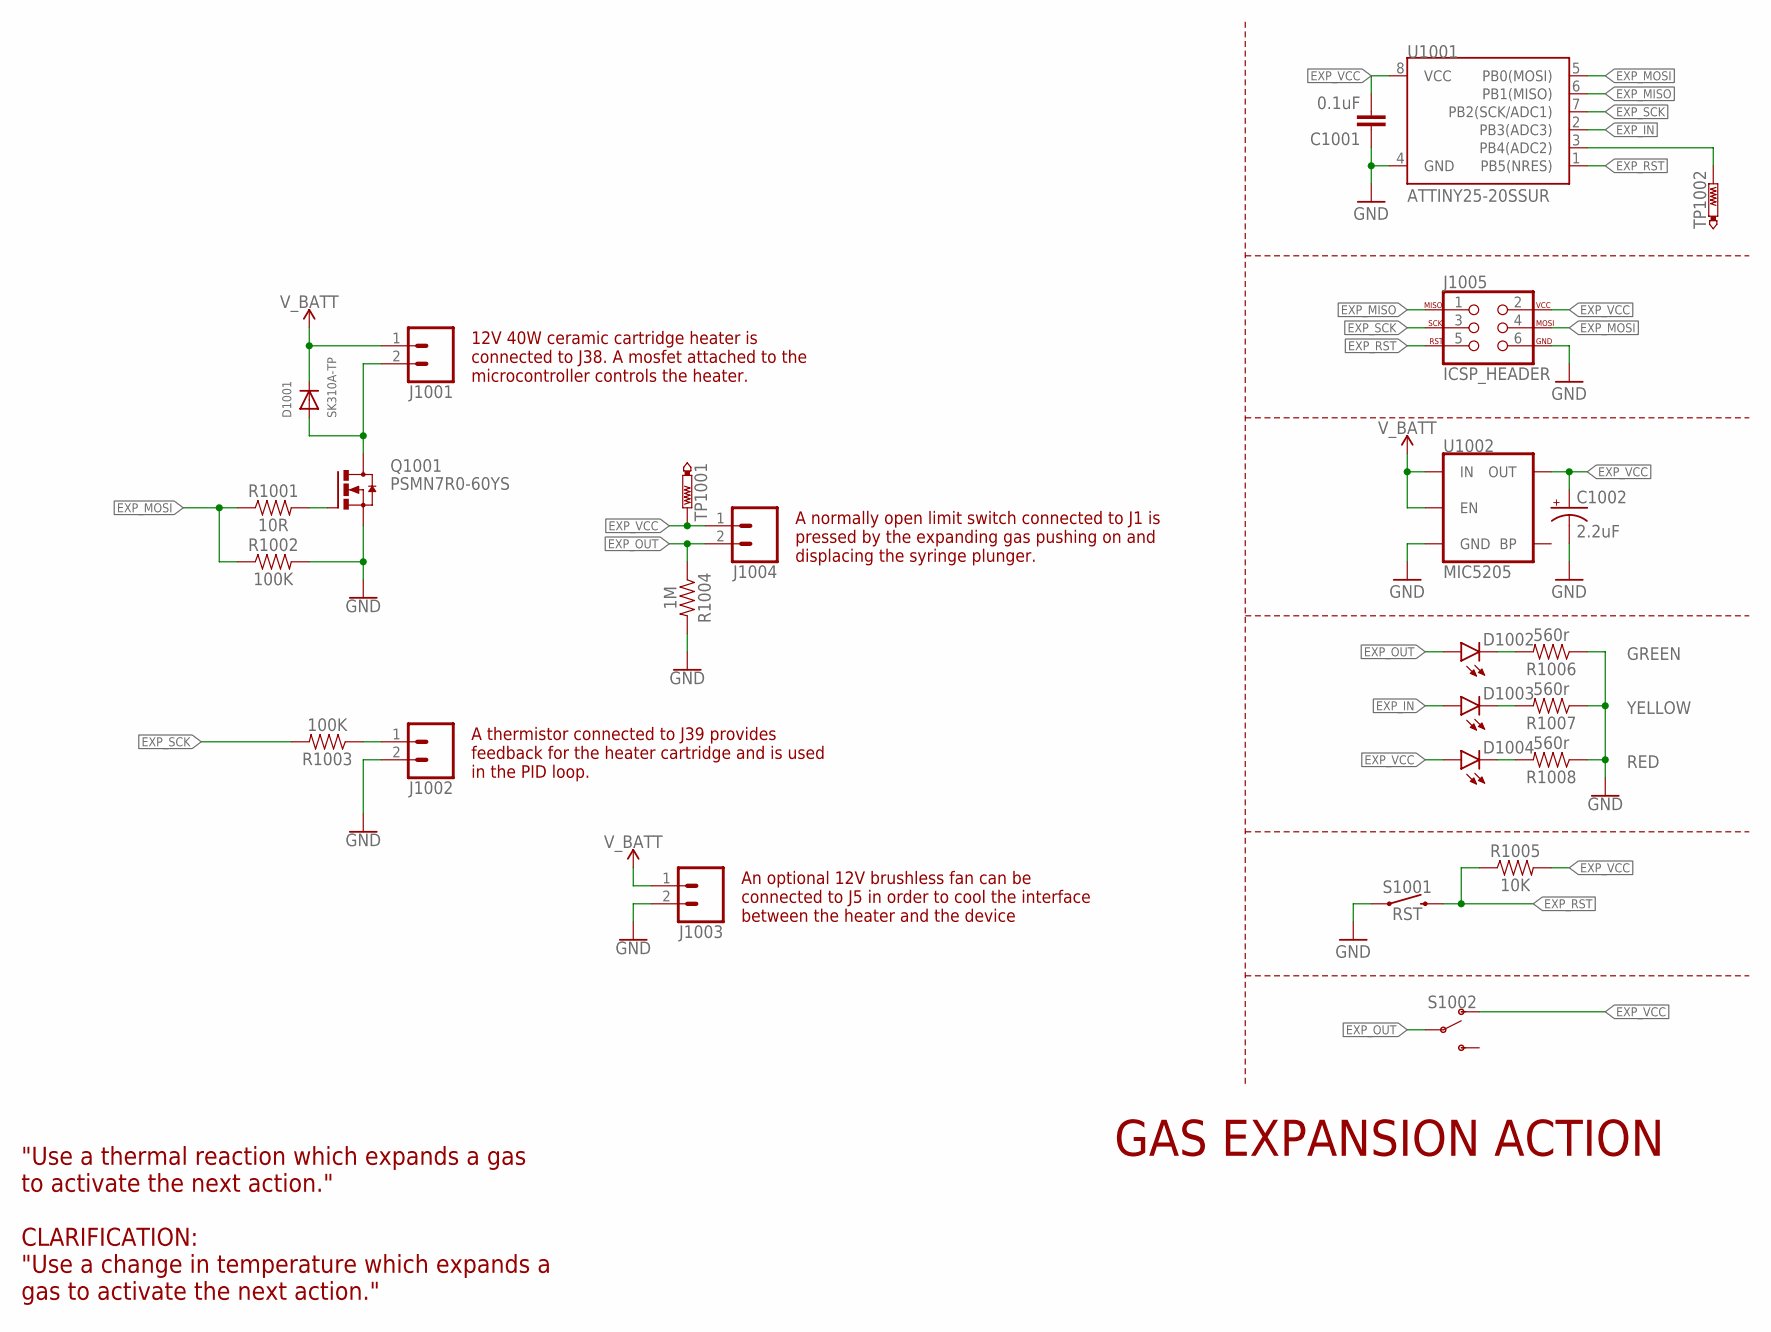
[picture p62: schematic WMHS Team A Mission Possible Electrical.sch, sheet 10, Gas Expansion]

Parts:
C1001: 0.1uF; 0603
C1002: 2.2uF; EIA3216
D1001: SK310A-TP; SMADIODE
D1002: GREEN; LED-0603
D1003: YELLOW; LED-0603
D1004: RED; LED-0603
J1001: CONN_023.5MM_LOCK; SCREWTERMINAL-3.5MM-2_LOCK
J1002, J1003, J1004: CONN_02LOCK; 1X02_LOCK
J1005: ICSP_HEADER; 2X3
Q1001: PSMN7R0-60YS; SOT669
R1001: 10R; 0603
R1002, R1003: 100K; 0603
R1004: 1M; 0603
R1005: 10K; 0603
R1006, R1007, R1008: 560r; 0603
S1001: RST; TACTILE_SWITCH_SMD_5.2MM
S1002: SWITCH-SPDT-SMD-AYZ0202; SWITCH_DPDT_SMD_AYZ0202
TP1001, TP1002: PTR1TP20R; TP20R
U1001: ATTINY25-20SSUR; SOIC8
U1002: MIC5205; SOT23-5

Connections:
EXP_IN: D1003.A, U1001.2 (PB3(ADC3)); also elsewhere on the board
EXP_MISO: J1005.1, U1001.6 (PB1(MISO))
EXP_MOSI: J1005.4, R1001.1, R1002.1, U1001.5 (PB0(MOSI))
EXP_OUT: D1002.A, J1004.2, R1004.1, S1002.2; also elsewhere on the board
EXP_RST: J1005.5, R1005.1, S1001.3 (2), S1001.4 (2), U1001.1 (PB5(NRES))
EXP_SCK: J1005.3, R1003.2, U1001.7 (PB2(SCK/ADC1))
EXP_VCC: C1001.2, C1002.+, D1004.A, J1004.1, J1005.2, R1005.2, S1002.1 (O), TP1001.TP, U1001.8 (VCC), U1002.5 (OUT)
GND: C1001.1, C1002.-, J1002.2, J1003.2, J1005.6, Q1001.1 (S), Q1001.2 (S), Q1001.3 (S), R1002.2, R1004.2, R1006.1, R1007.1, R1008.1, S1001.1, S1001.2 (1), U1001.4 (GND), U1002.2 (GND); also elsewhere on the board
unnamed: Q1001.4 (G), R1001.2
unnamed: TP1002.TP, U1001.3 (PB4(ADC2))
unnamed: J1002.1, R1003.1
unnamed: D1001.A, J1001.2, Q1001.MB (D)
unnamed: D1004.C, R1008.2
unnamed: D1003.C, R1007.2
unnamed: D1002.C, R1006.2
V_BATT: D1001.C, J1001.1, J1003.1, U1002.1 (IN), U1002.3 (EN); also elsewhere on the board

Notes on the sheet:
GAS EXPANSION ACTION
"Use a thermal reaction which expands a gas to activate the next action." CLARIFICATION: "Use a change in temperature which expands a gas to activate the next action."
12V 40W ceramic cartridge heater is connected to J38. A mosfet attached to the microcontroller controls the heater.
A normally open limit switch connected to J1 is pressed by the expanding gas pushing on and displacing the syringe plunger.
A thermistor connected to J39 provides feedback for the heater cartridge and is used in the PID loop.
An optional 12V brushless fan can be connected to J5 in order to cool the interface between the heater and the device

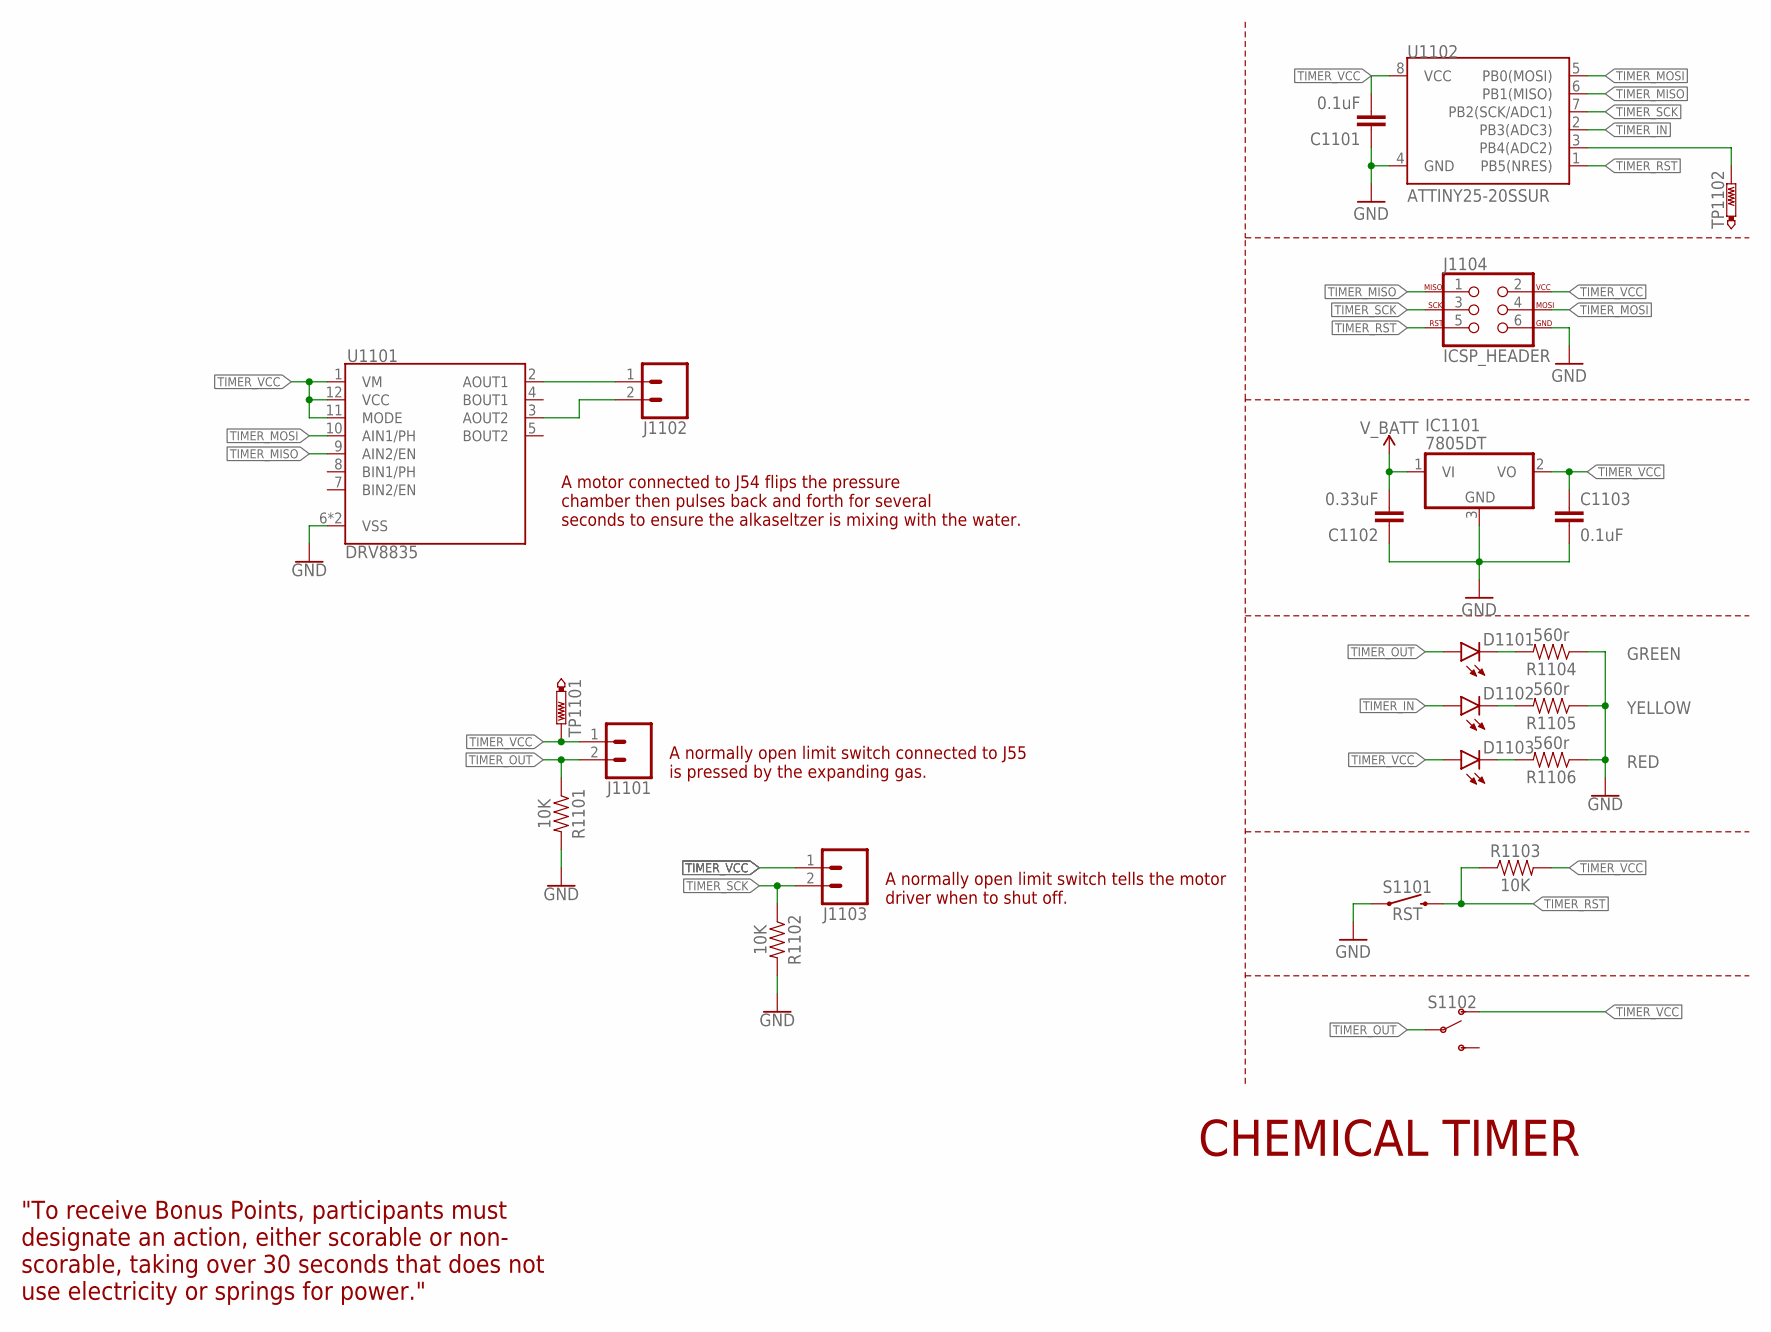
[picture p63: schematic WMHS Team A Mission Possible Electrical.sch, sheet 11, Timer]

Parts:
C1101, C1103: 0.1uF; 0603
C1102: 0.33uF; 0603
D1101: GREEN; LED-0603
D1102: YELLOW; LED-0603
D1103: RED; LED-0603
IC1101: 7805DT; TO252
J1101, J1102, J1103: CONN_02LOCK; 1X02_LOCK
J1104: ICSP_HEADER; 2X3
R1101, R1102, R1103: 10K; 0603
R1104, R1105, R1106: 560r; 0603
S1101: RST; TACTILE_SWITCH_SMD_5.2MM
S1102: SWITCH-SPDT-SMD-AYZ0202; SWITCH_DPDT_SMD_AYZ0202
TP1101, TP1102: PTR1TP20R; TP20R
U1101: DRV8835; WSON-12
U1102: ATTINY25-20SSUR; SOIC8

Connections:
GND: C1101.1, C1102.1, C1103.2, IC1101.3 (GND), J1104.6, R1101.2, R1102.2, R1104.1, R1105.1, R1106.1, S1101.1, S1101.2 (1), U1101.6 (VSS), U1101.PAD (VSS), U1102.4 (GND); also elsewhere on the board
unnamed: TP1102.TP, U1102.3 (PB4(ADC2))
unnamed: J1102.1, U1101.2 (AOUT1)
unnamed: J1102.2, U1101.3 (AOUT2)
unnamed: D1103.C, R1106.2
unnamed: D1102.C, R1105.2
unnamed: D1101.C, R1104.2
TIMER_IN: D1102.A, U1102.2 (PB3(ADC3)); also elsewhere on the board
TIMER_MISO: J1104.1, U1101.9 (AIN2/EN), U1102.6 (PB1(MISO))
TIMER_MOSI: J1104.4, U1101.10 (AIN1/PH), U1102.5 (PB0(MOSI))
TIMER_OUT: D1101.A, J1101.2, R1101.1, S1102.2; also elsewhere on the board
TIMER_RST: J1104.5, R1103.1, S1101.3 (2), S1101.4 (2), U1102.1 (PB5(NRES))
TIMER_SCK: J1103.2, J1104.3, R1102.1, U1102.7 (PB2(SCK/ADC1))
TIMER_VCC: C1101.2, C1103.1, D1103.A, IC1101.2 (VO), J1101.1, J1103.1, J1104.2, R1103.2, S1102.1 (O), TP1101.TP, U1101.1 (VM), U1101.11 (MODE), U1101.12 (VCC), U1102.8 (VCC)
V_BATT: C1102.2, IC1101.1 (VI); also elsewhere on the board

Notes on the sheet:
CHEMICAL TIMER
"To receive Bonus Points, participants must designate an action, either scorable or non- scorable, taking over 30 seconds that does not use electricity or springs for power."
A normally open limit switch connected to J55 is pressed by the expanding gas.
A motor connected to J54 flips the pressure chamber then pulses back and forth for several seconds to ensure the alkaseltzer is mixing with the water.
A normally open limit switch tells the motor driver when to shut off.

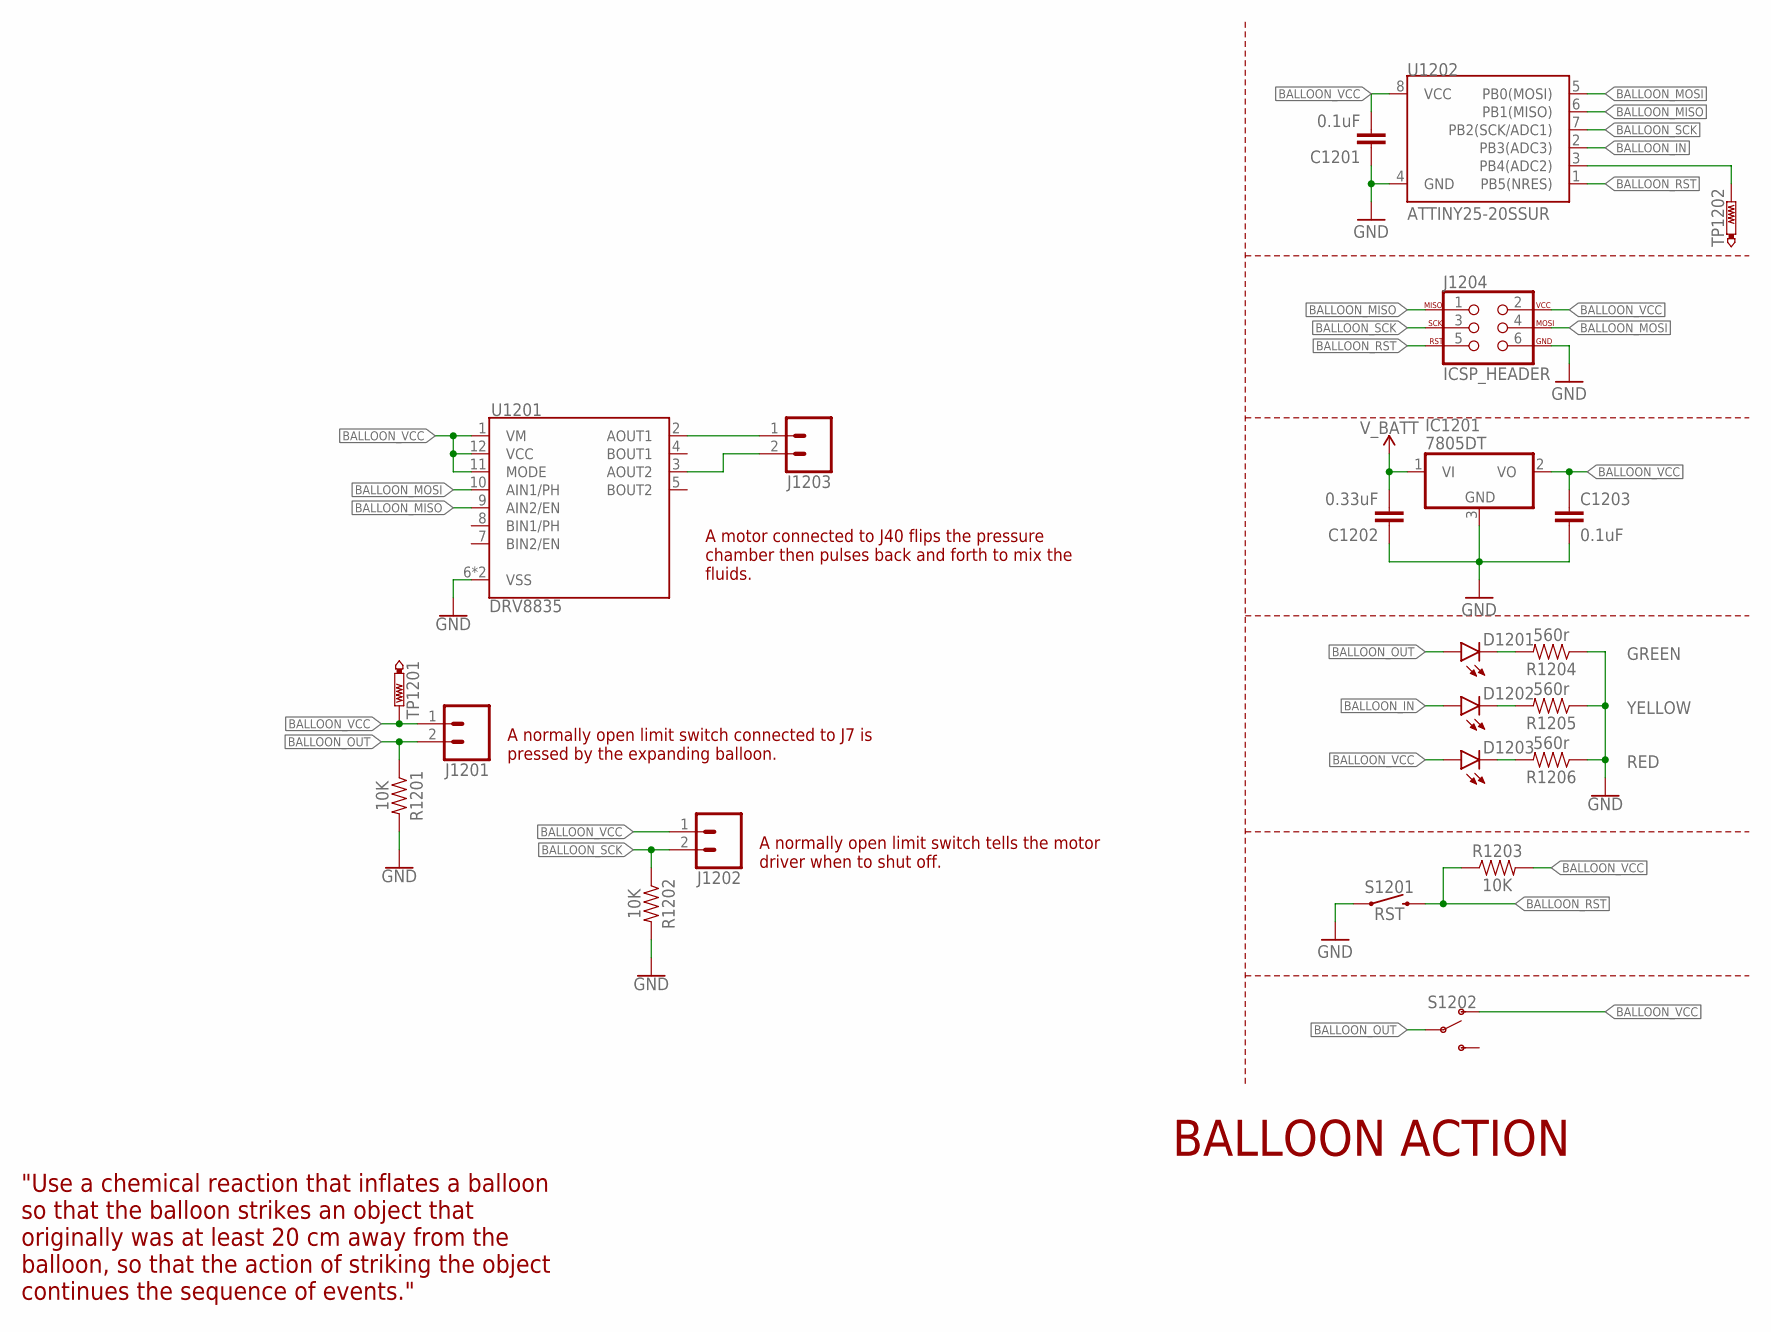
[picture p64: schematic WMHS Team A Mission Possible Electrical.sch, sheet 12, Balloon]

Parts:
C1201, C1203: 0.1uF; 0603
C1202: 0.33uF; 0603
D1201: GREEN; LED-0603
D1202: YELLOW; LED-0603
D1203: RED; LED-0603
IC1201: 7805DT; TO252
J1201, J1202, J1203: CONN_02LOCK; 1X02_LOCK
J1204: ICSP_HEADER; 2X3
R1201, R1202, R1203: 10K; 0603
R1204, R1205, R1206: 560r; 0603
S1201: RST; TACTILE_SWITCH_SMD_5.2MM
S1202: SWITCH-SPDT-SMD-AYZ0202; SWITCH_DPDT_SMD_AYZ0202
TP1201, TP1202: PTR1TP20R; TP20R
U1201: DRV8835; WSON-12
U1202: ATTINY25-20SSUR; SOIC8

Connections:
BALLOON_IN: D1202.A, U1202.2 (PB3(ADC3)); also elsewhere on the board
BALLOON_MISO: J1204.1, U1201.9 (AIN2/EN), U1202.6 (PB1(MISO))
BALLOON_MOSI: J1204.4, U1201.10 (AIN1/PH), U1202.5 (PB0(MOSI))
BALLOON_OUT: D1201.A, J1201.2, R1201.1, S1202.2; also elsewhere on the board
BALLOON_RST: J1204.5, R1203.1, S1201.3 (2), S1201.4 (2), U1202.1 (PB5(NRES))
BALLOON_SCK: J1202.2, J1204.3, R1202.1, U1202.7 (PB2(SCK/ADC1))
BALLOON_VCC: C1201.2, C1203.1, D1203.A, IC1201.2 (VO), J1201.1, J1202.1, J1204.2, R1203.2, S1202.1 (O), TP1201.TP, U1201.1 (VM), U1201.11 (MODE), U1201.12 (VCC), U1202.8 (VCC)
GND: C1201.1, C1202.1, C1203.2, IC1201.3 (GND), J1204.6, R1201.2, R1202.2, R1204.1, R1205.1, R1206.1, S1201.1, S1201.2 (1), U1201.6 (VSS), U1201.PAD (VSS), U1202.4 (GND); also elsewhere on the board
unnamed: TP1202.TP, U1202.3 (PB4(ADC2))
unnamed: J1203.1, U1201.2 (AOUT1)
unnamed: J1203.2, U1201.3 (AOUT2)
unnamed: D1203.C, R1206.2
unnamed: D1202.C, R1205.2
unnamed: D1201.C, R1204.2
V_BATT: C1202.2, IC1201.1 (VI); also elsewhere on the board

Notes on the sheet:
BALLOON ACTION
"Use a chemical reaction that inflates a balloon so that the balloon strikes an object that originally was at least 20 cm away from the balloon, so that the action of striking the object continues the sequence of events."
A normally open limit switch connected to J7 is pressed by the expanding balloon.
A motor connected to J40 flips the pressure chamber then pulses back and forth to mix the fluids.
A normally open limit switch tells the motor driver when to shut off.

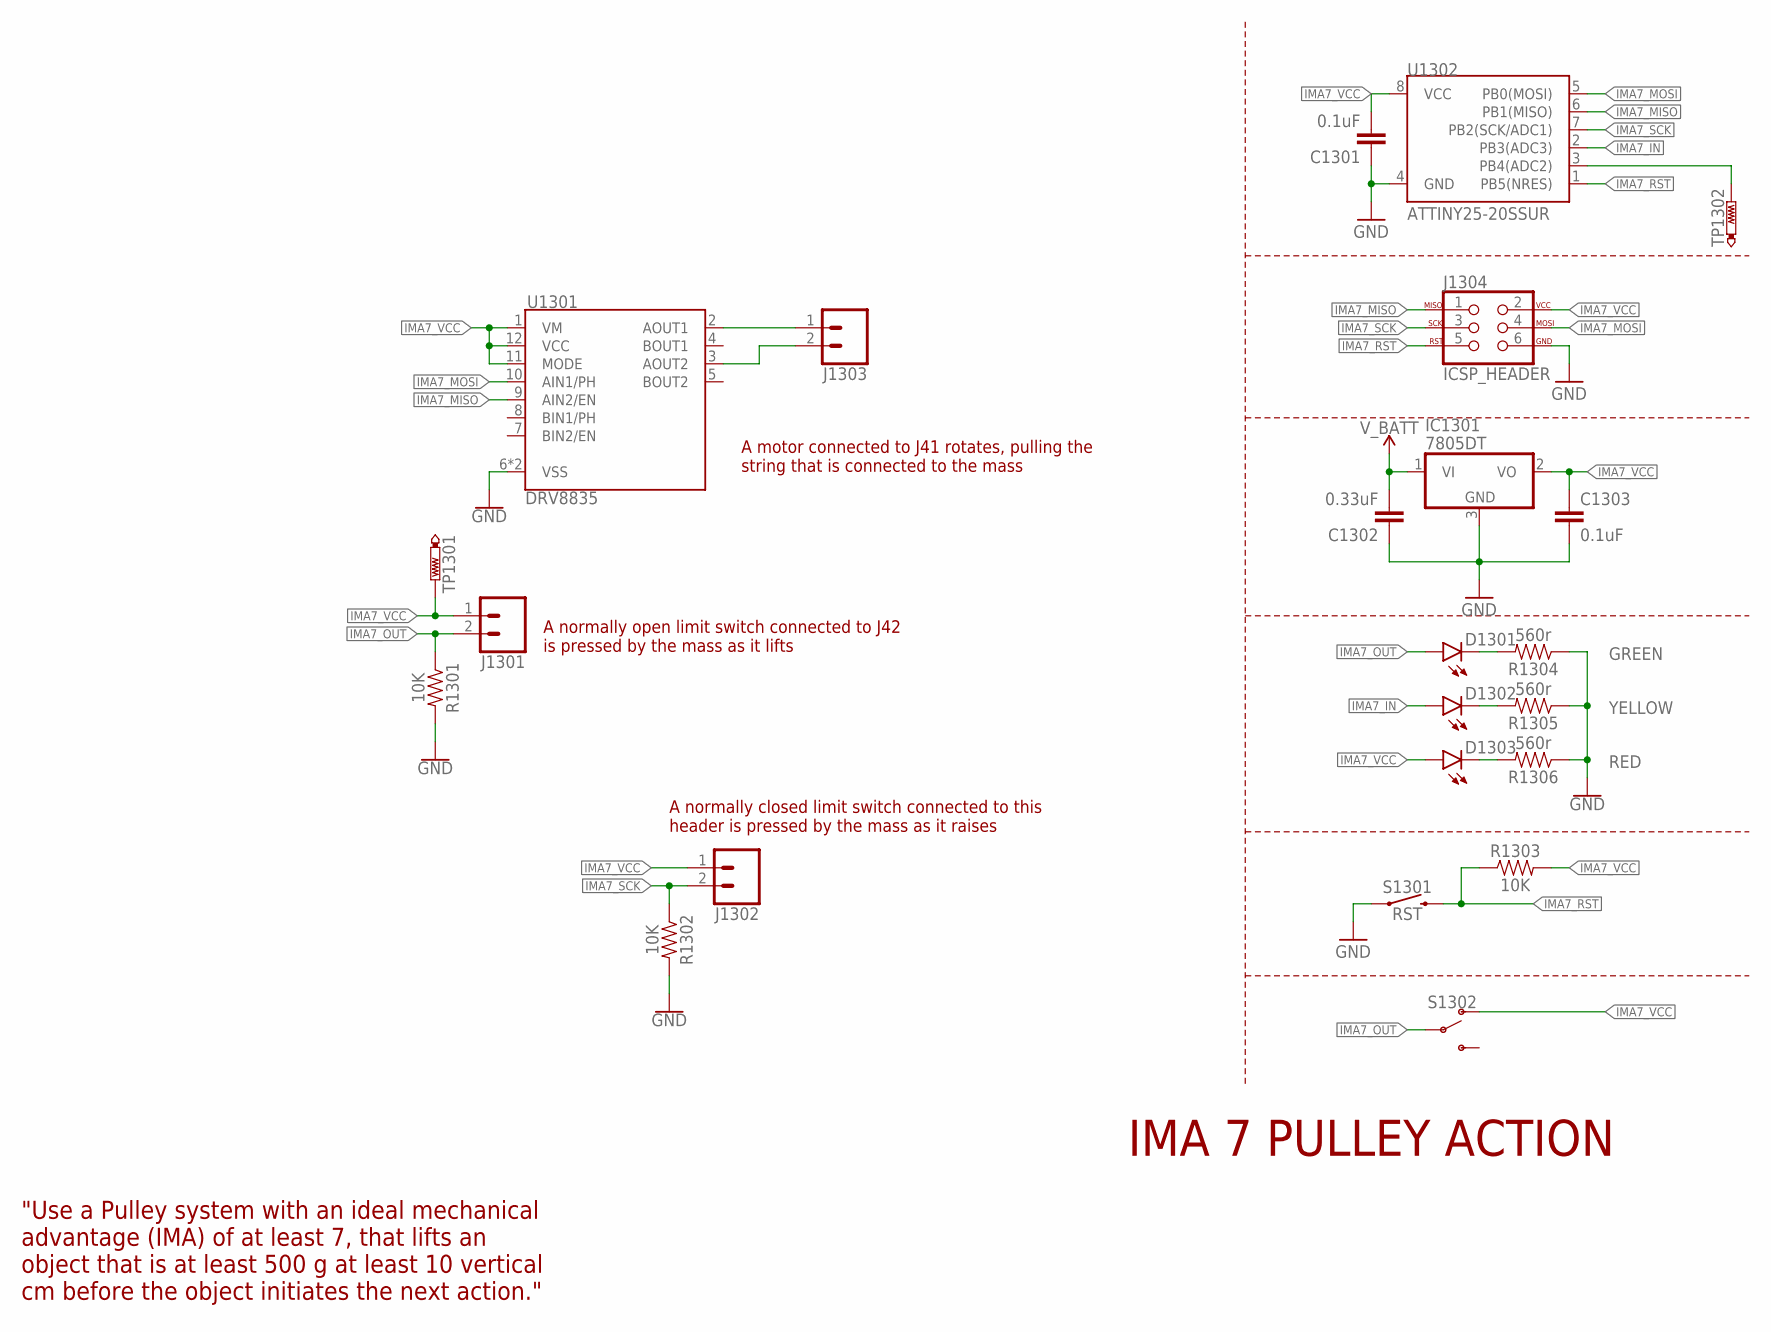
[picture p65: schematic WMHS Team A Mission Possible Electrical.sch, sheet 13, IMA7]

Parts:
C1301, C1303: 0.1uF; 0603
C1302: 0.33uF; 0603
D1301: GREEN; LED-0603
D1302: YELLOW; LED-0603
D1303: RED; LED-0603
IC1301: 7805DT; TO252
J1301, J1302, J1303: CONN_02LOCK; 1X02_LOCK
J1304: ICSP_HEADER; 2X3
R1301, R1302, R1303: 10K; 0603
R1304, R1305, R1306: 560r; 0603
S1301: RST; TACTILE_SWITCH_SMD_5.2MM
S1302: SWITCH-SPDT-SMD-AYZ0202; SWITCH_DPDT_SMD_AYZ0202
TP1301, TP1302: PTR1TP20R; TP20R
U1301: DRV8835; WSON-12
U1302: ATTINY25-20SSUR; SOIC8

Connections:
GND: C1301.1, C1302.1, C1303.2, IC1301.3 (GND), J1304.6, R1301.2, R1302.2, R1304.1, R1305.1, R1306.1, S1301.1, S1301.2 (1), U1301.6 (VSS), U1301.PAD (VSS), U1302.4 (GND); also elsewhere on the board
IMA7_IN: D1302.A, U1302.2 (PB3(ADC3)); also elsewhere on the board
IMA7_MISO: J1304.1, U1301.9 (AIN2/EN), U1302.6 (PB1(MISO))
IMA7_MOSI: J1304.4, U1301.10 (AIN1/PH), U1302.5 (PB0(MOSI))
IMA7_OUT: D1301.A, J1301.2, R1301.1, S1302.2; also elsewhere on the board
IMA7_RST: J1304.5, R1303.1, S1301.3 (2), S1301.4 (2), U1302.1 (PB5(NRES))
IMA7_SCK: J1302.2, J1304.3, R1302.1, U1302.7 (PB2(SCK/ADC1))
IMA7_VCC: C1301.2, C1303.1, D1303.A, IC1301.2 (VO), J1301.1, J1302.1, J1304.2, R1303.2, S1302.1 (O), TP1301.TP, U1301.1 (VM), U1301.11 (MODE), U1301.12 (VCC), U1302.8 (VCC)
unnamed: TP1302.TP, U1302.3 (PB4(ADC2))
unnamed: J1303.1, U1301.2 (AOUT1)
unnamed: J1303.2, U1301.3 (AOUT2)
unnamed: D1303.C, R1306.2
unnamed: D1302.C, R1305.2
unnamed: D1301.C, R1304.2
V_BATT: C1302.2, IC1301.1 (VI); also elsewhere on the board

Notes on the sheet:
IMA 7 PULLEY ACTION
"Use a Pulley system with an ideal mechanical advantage (IMA) of at least 7, that lifts an object that is at least 500 g at least 10 vertical cm before the object initiates the next action."
A normally open limit switch connected to J42 is pressed by the mass as it lifts
A motor connected to J41 rotates, pulling the string that is connected to the mass
A normally closed limit switch connected to this header is pressed by the mass as it raises

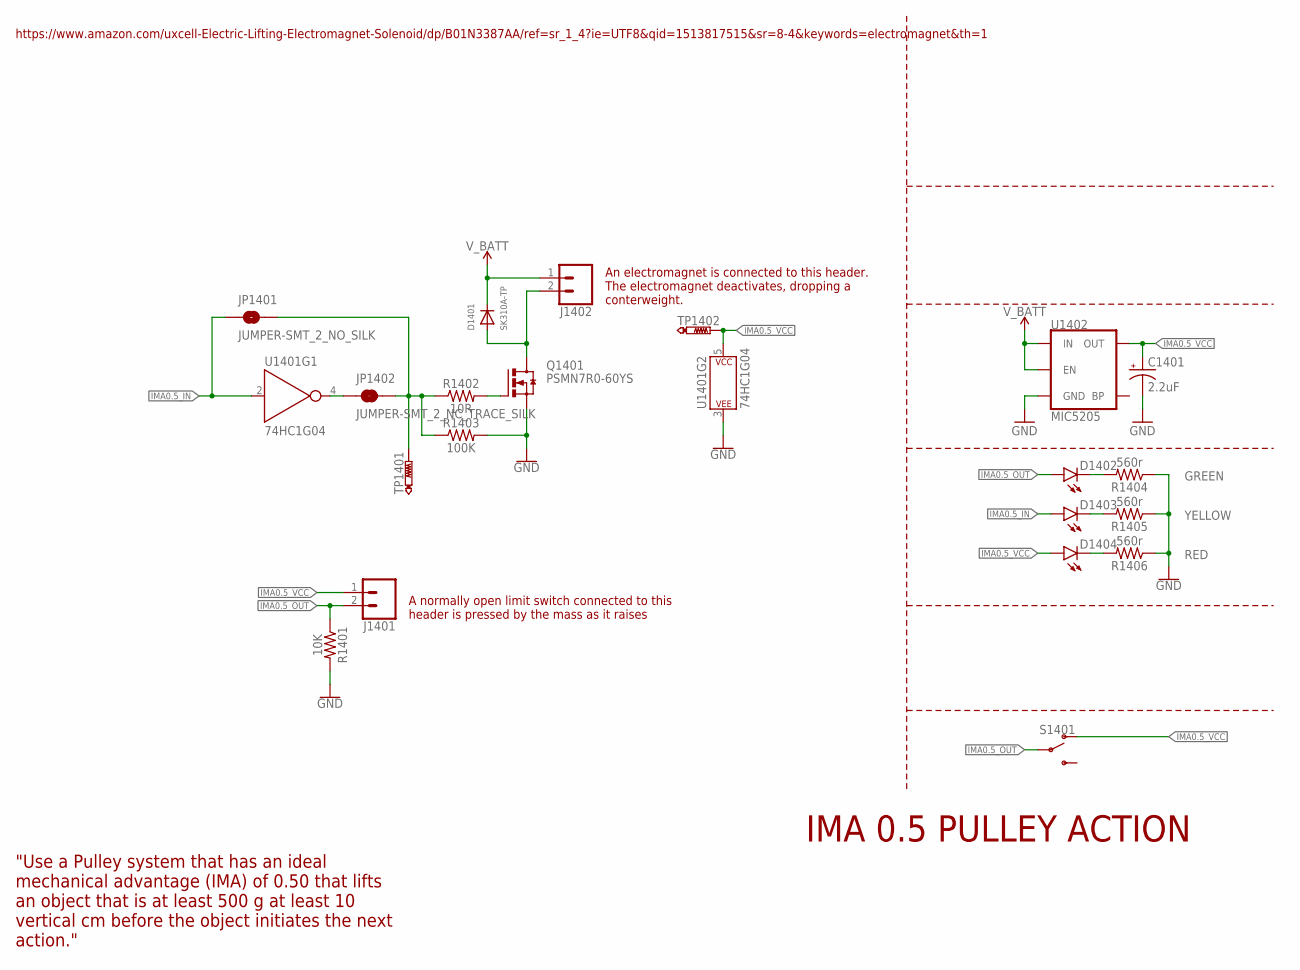
[picture p66: schematic WMHS Team A Mission Possible Electrical.sch, sheet 14, IMA0.5]

Parts:
C1401: 2.2uF; EIA3216
D1401: SK310A-TP; SMADIODE
D1402: GREEN; LED-0603
D1403: YELLOW; LED-0603
D1404: RED; LED-0603
J1401: CONN_02LOCK; 1X02_LOCK
J1402: CONN_023.5MM_LOCK; SCREWTERMINAL-3.5MM-2_LOCK
JP1401: JUMPER-SMT_2_NO_SILK; SMT-JUMPER_2_NO_SILK
JP1402: JUMPER-SMT_2_NC_TRACE_SILK; SMT-JUMPER_2_NC_TRACE_SILK
Q1401: PSMN7R0-60YS; SOT669
R1401: 10K; 0603
R1402: 10R; 0603
R1403: 100K; 0603
R1404, R1405, R1406: 560r; 0603
S1401: SWITCH-SPDT-SMD-AYZ0202; SWITCH_DPDT_SMD_AYZ0202
TP1401, TP1402: PTR1TP20R; TP20R
U1401: 74HC1G04; SOT353
U1402: MIC5205; SOT23-5

Connections:
GND: C1401.-, Q1401.1 (S), Q1401.2 (S), Q1401.3 (S), R1401.2, R1403.2, R1404.1, R1405.1, R1406.1, U1401.3 (P$V-), U1402.2 (GND); also elsewhere on the board
IMA0.5_IN: D1403.A, JP1401.1, U1401.2 (A); also elsewhere on the board
IMA0.5_OUT: D1402.A, J1401.2, R1401.1, S1401.2; also elsewhere on the board
IMA0.5_VCC: C1401.+, D1404.A, J1401.1, S1401.1 (O), TP1402.TP, U1401.5 (P$V+), U1402.5 (OUT)
unnamed: JP1401.2, JP1402.2, R1402.1, R1403.1, TP1401.TP
unnamed: JP1402.1, U1401.4 (Y)
unnamed: Q1401.4 (G), R1402.2
unnamed: D1401.A, J1402.2, Q1401.MB (D)
unnamed: D1404.C, R1406.2
unnamed: D1403.C, R1405.2
unnamed: D1402.C, R1404.2
V_BATT: D1401.C, J1402.1, U1402.1 (IN), U1402.3 (EN); also elsewhere on the board

Notes on the sheet:
IMA 0.5 PULLEY ACTION
"Use a Pulley system that has an ideal mechanical advantage (IMA) of 0.50 that lifts an object that is at least 500 g at least 10 vertical cm before the object initiates the next action."
An electromagnet is connected to this header. The electromagnet deactivates, dropping a conterweight.
A normally open limit switch connected to this header is pressed by the mass as it raises
https://www.amazon.com/uxcell-Electric-Lifting-Electromagnet-Solenoid/dp/B01N3387AA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
