davecutting/Ward-Melville-2018-Mission-Possible/Circuit Board/WMHS Team A Mission Possible Electrical.brd

## EAGLE design Circuit Board/WMHS Team A Mission Possible Electrical.brd (continued)

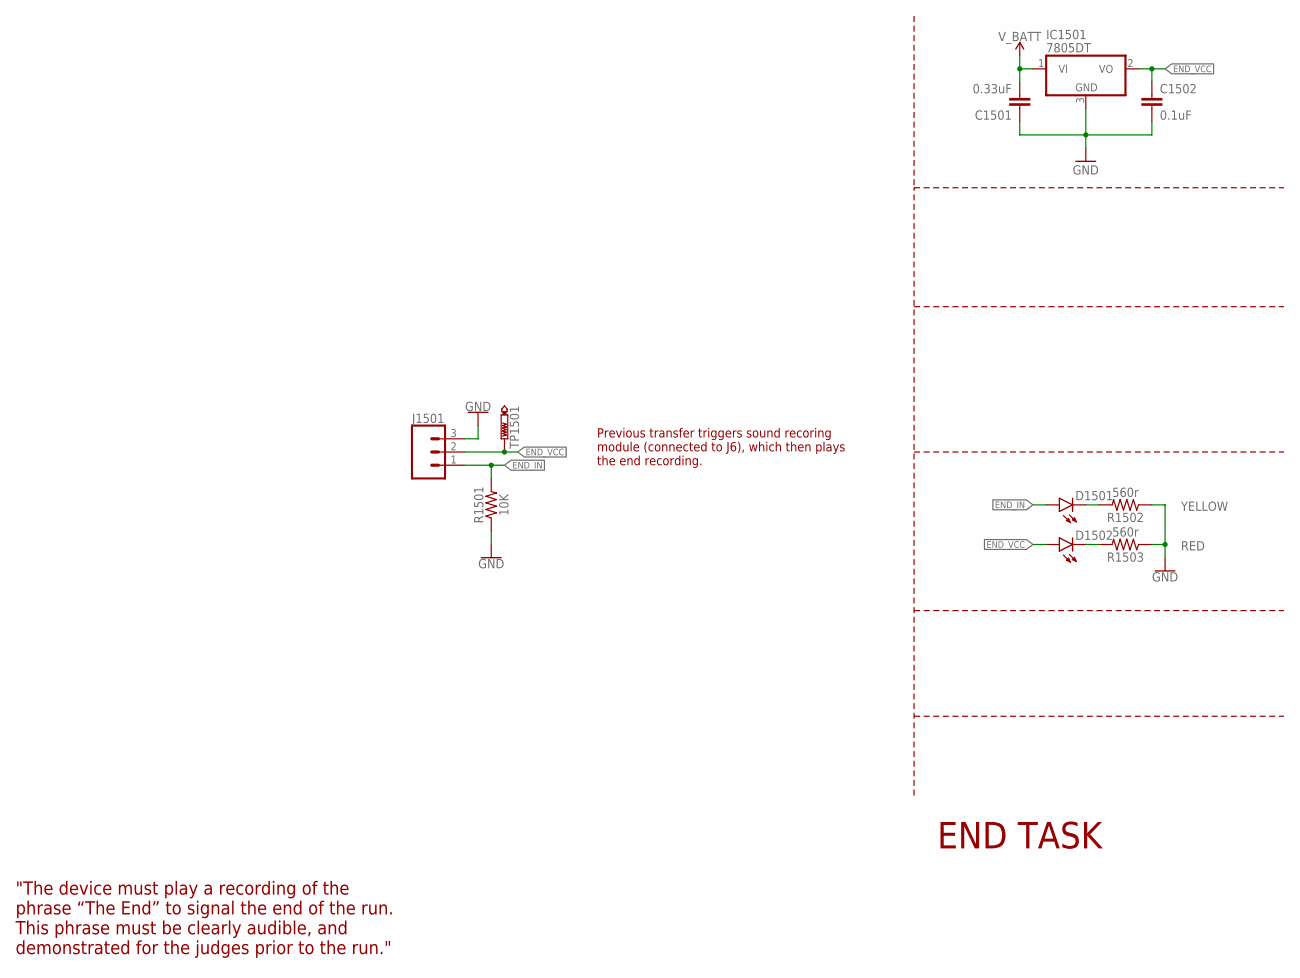
[picture p67: schematic WMHS Team A Mission Possible Electrical.sch, sheet 15, End Task]

Parts:
C1501: 0.33uF; 0603
C1502: 0.1uF; 0603
D1501: YELLOW; LED-0603
D1502: RED; LED-0603
IC1501: 7805DT; TO252
J1501: CONN_03LOCK; 1X03_LOCK
R1501: 10K; 0603
R1502, R1503: 560r; 0603
TP1501: PTR1TP20R; TP20R

Connections:
END_IN: D1501.A, J1501.1, R1501.2; also elsewhere on the board
END_VCC: C1502.1, D1502.A, IC1501.2 (VO), J1501.2, TP1501.TP
GND: C1501.1, C1502.2, IC1501.3 (GND), J1501.3, R1501.1, R1502.1, R1503.1; also elsewhere on the board
unnamed: D1502.C, R1503.2
unnamed: D1501.C, R1502.2
V_BATT: C1501.2, IC1501.1 (VI); also elsewhere on the board

Notes on the sheet:
END TASK
"The device must play a recording of the phrase “The End” to signal the end of the run. This phrase must be clearly audible, and demonstrated for the judges prior to the run."
Previous transfer triggers sound recoring module (connected to J6), which then plays the end recording.

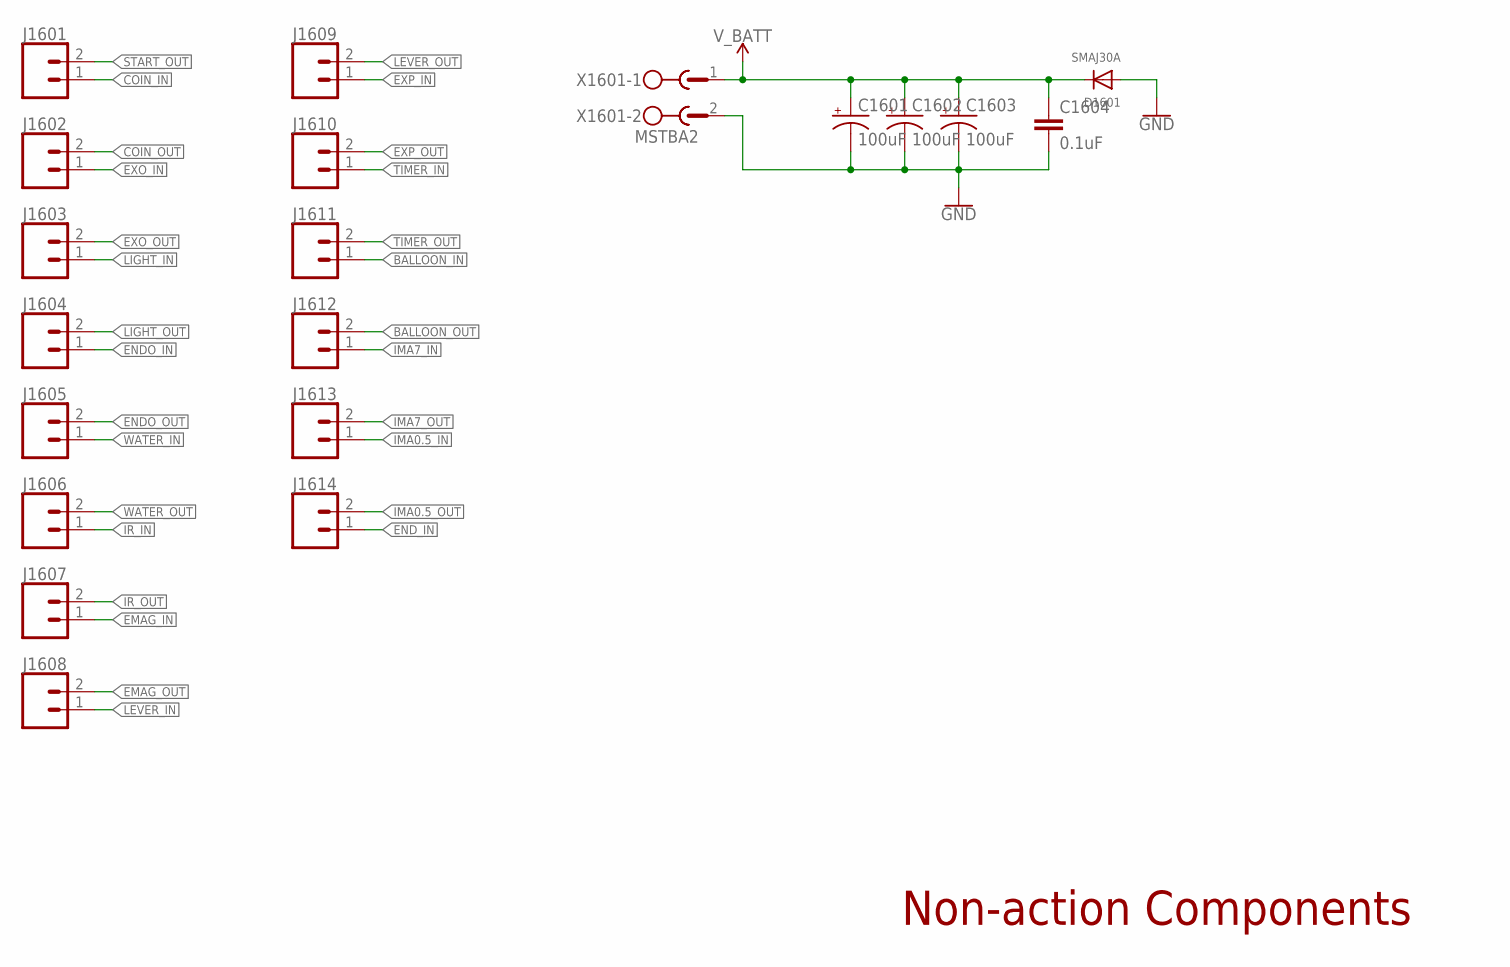
[picture p68: schematic WMHS Team A Mission Possible Electrical.sch, sheet 16, Non-action Components]

Parts:
C1601, C1602, C1603: 100uF; PANASONIC_D
C1604: 0.1uF; 0603
D1601: SMAJ30A; SMADIODE
J1601, J1602, J1603, J1604, J1605, J1606, J1607, J1608, J1609, J1610, J1611, J1612, J1613, J1614: CONN_02; 1X02
X1601: MSTBA2

Connections:
BALLOON_IN: J1611.1; also elsewhere on the board
BALLOON_OUT: J1612.2; also elsewhere on the board
COIN_IN: J1601.1; also elsewhere on the board
COIN_OUT: J1602.2; also elsewhere on the board
EMAG_IN: J1607.1; also elsewhere on the board
EMAG_OUT: J1608.2; also elsewhere on the board
ENDO_IN: J1604.1; also elsewhere on the board
ENDO_OUT: J1605.2; also elsewhere on the board
END_IN: J1614.1; also elsewhere on the board
EXO_IN: J1602.1; also elsewhere on the board
EXO_OUT: J1603.2; also elsewhere on the board
EXP_IN: J1609.1; also elsewhere on the board
EXP_OUT: J1610.2; also elsewhere on the board
GND: C1601.-, C1602.-, C1603.-, C1604.2, D1601.A, X1601.2; also elsewhere on the board
IMA0.5_IN: J1613.1; also elsewhere on the board
IMA0.5_OUT: J1614.2; also elsewhere on the board
IMA7_IN: J1612.1; also elsewhere on the board
IMA7_OUT: J1613.2; also elsewhere on the board
IR_IN: J1606.1; also elsewhere on the board
IR_OUT: J1607.2; also elsewhere on the board
LEVER_IN: J1608.1; also elsewhere on the board
LEVER_OUT: J1609.2; also elsewhere on the board
LIGHT_IN: J1603.1; also elsewhere on the board
LIGHT_OUT: J1604.2; also elsewhere on the board
START_OUT: J1601.2; also elsewhere on the board
TIMER_IN: J1610.1; also elsewhere on the board
TIMER_OUT: J1611.2; also elsewhere on the board
V_BATT: C1601.+, C1602.+, C1603.+, C1604.1, D1601.C, X1601.1; also elsewhere on the board
WATER_IN: J1605.1; also elsewhere on the board
WATER_OUT: J1606.2; also elsewhere on the board

Notes on the sheet:
Non-action Components

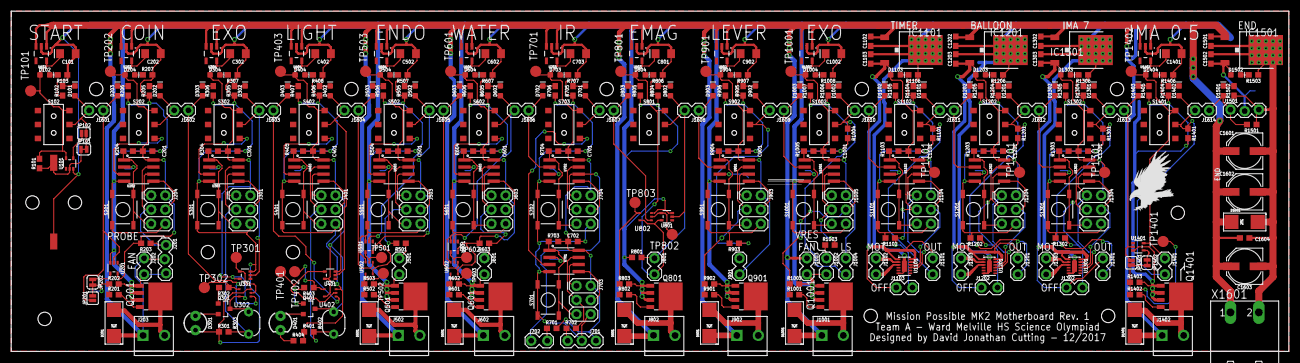
[picture p69: board WMHS Team A Mission Possible Electrical.brd from above]

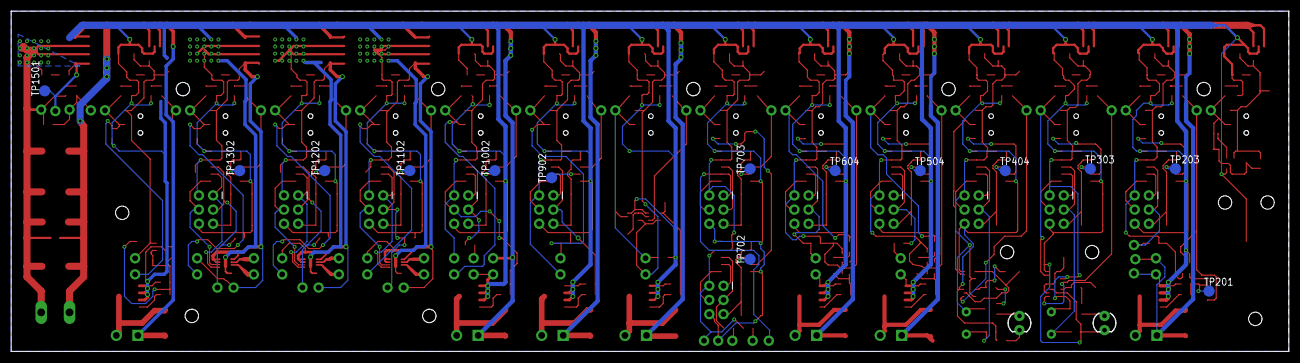
[picture p70: board WMHS Team A Mission Possible Electrical.brd from below]

Board: 2 copper layers, 228.9 x 60.9 mm, 362 parts (14 on the bottom side), 199 nets.

Other parts of the board:
U$2: EAGLE-PLC-8MM
