davecutting/Ward-Melville-2018-Mission-Possible/(commit log)

2018-01-15 Added beta circuit board design files
    [WMHS Team A Mission Possible Electrical.brd, WMHS Team A Mission Possible Electrical.csv, WMHS Team A Mission Possible Electrical.sch]
2018-01-22 Added code
    [WMHS Team A Mission Possible Electrical.brd, WMHS Team A Mission Possible Electrical.csv, WMHS Team A Mission Possible Electrical.sch]
2018-01-22 Reorganized files and updated schematics
    MIT schematics have been finalized and the code is pretty stable, beisdes some thresholding issues.
    [MIT Invitational Circuit Board BOM.csv, MIT Invitational Circuit Board.brd, MIT Invitational Circuit Board.sch]
2018-01-22 Updated README.md and added PDF schematics and layouts
    [MIT Invitational Circuit Board.brd, WMHS MIT Invitational Circuit Board BOM.csv, WMHS MIT Invitational Circuit Board.brd, WMHS MIT Invitational Circuit Board.sch]
2018-01-22 Updated code version and schematics for regionals (beta version)
    [WMHS Eastern LI Invitational Circuit Board.brd, WMHS Eastern LI Invitational Circuit Board.sch, WMHS MIT Invitational Circuit Board BOM.csv]
2018-01-23 Changed file naming system
    [WMHS Eastern LI Invitational Circuit Board.sch, WMHS MIT Invy Circuit Board.brd, WMHS MIT Invy Circuit Board.sch]
2018-03-03 SOUP and States Upgrades and Modifications
    [WMHS Eastern LI Invitational Circuit Board.sch]
